549116/ProjectGearDeburr/documentatie/proof of concept/foto/WhatsApp Image 2025-10-16 at 11.18.52_3c14d5c5.jpg

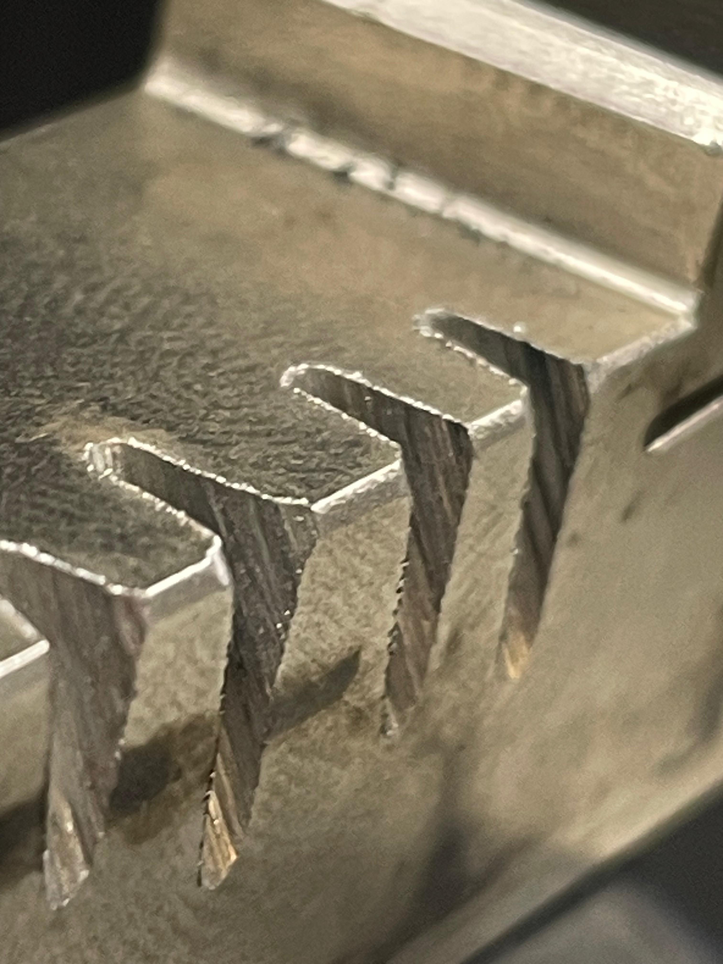
documentatie/proof of concept/foto/WhatsApp Image 2025-10-16 at 11.18.52_3c14d5c5.jpg
