549116/ProjectGearDeburr/presentaties/current status 21-11-2025.pptx

## Current status

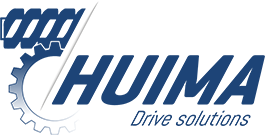
[picture p15: figure]
HUIMA SPECIALS – Drive solutions
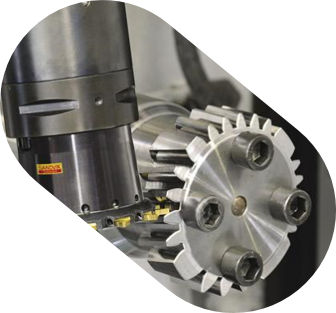
[picture p16: figure]
Gear Processing Process (7 Steps Make You Feel Simple) - Richconn

Project Gear Deburr

- - Gijs Winkelhorst
- - Sven Kerkhoff

## Slide 2

- Table of contents

- Current 3d model
  - Overview
  - How does it work?
  - Components
  - test
  - issues
- Future plans

## Slide 3

- 3d model overview

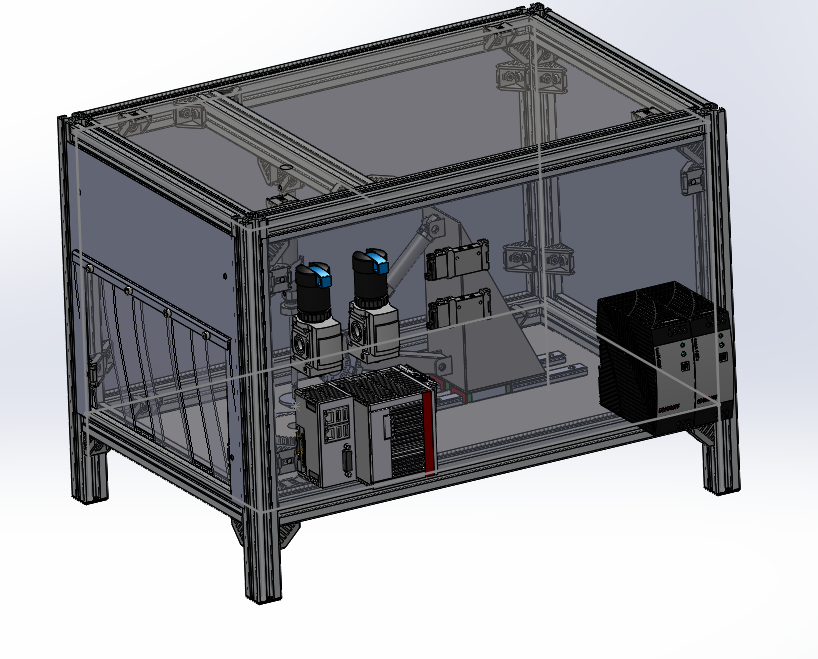
[picture p17: figure]

- Bosch rexroth frame 30x30 profile
- Deburring with a steel brush
- Prototype
- adjustable to the diameter and height of the gear wheel

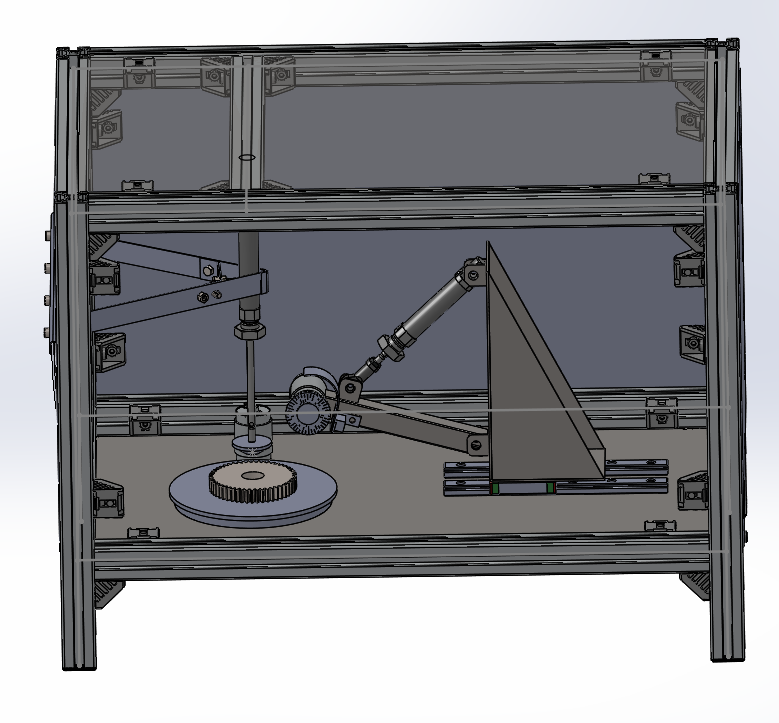
[picture p18: figure]
Afbeelding met schets Door AI gegenereerde inhoud is mogelijk onjuist.

## Slide 4

- How does it work?

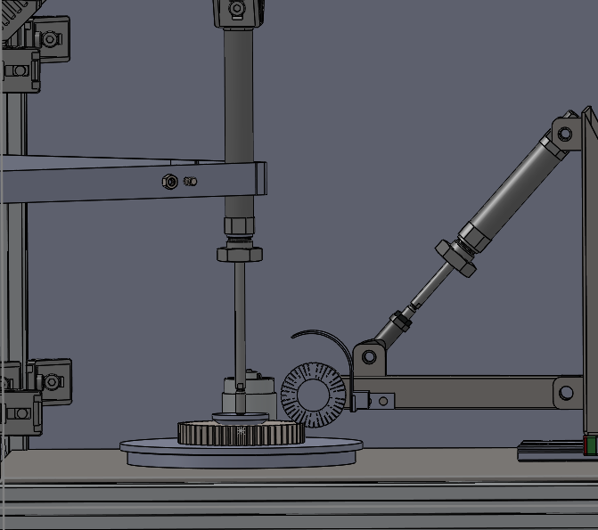
[picture p19: figure]
Afbeelding met schermopname, machine, microscoop Door AI gegenereerde inhoud is mogelijk onjuist.

Step 1:
Gear is placed on the turntable by hand or by a robot
Step 2:
Pneumatic cilinder with rotating center presses the gear onto the turntable
Step 3:
steel brush moves to the correct diameter position and is pressed against the gear wheel
Step 4:
Steel brush and turntable starts to rotate. -> gear is getting deburred
Step 5:
Everything returns to its starting position
Step 6:
Gear can be taken out

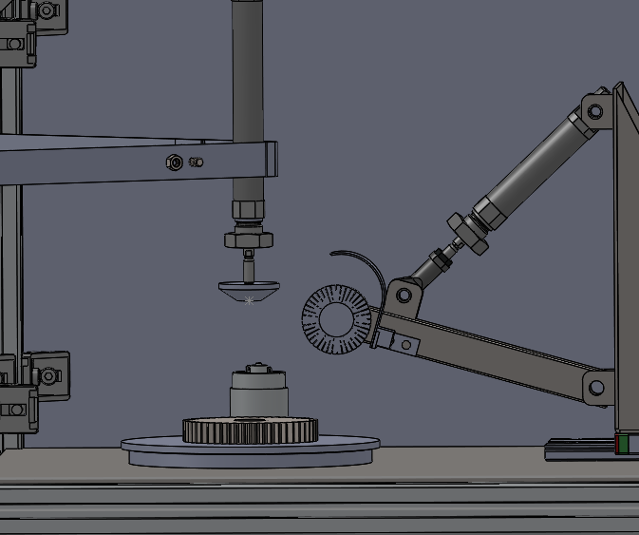
[picture p20: figure]
Afbeelding met schermopname, 3d-modellering, microscoop Door AI gegenereerde inhoud is mogelijk onjuist.

## Slide 5

- testing

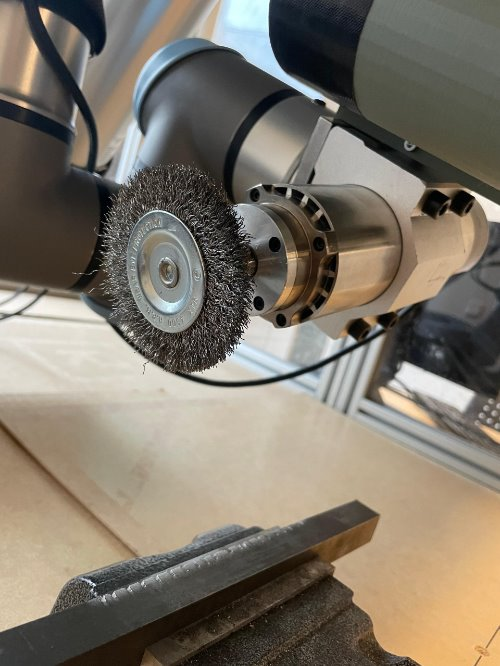
[picture p21: figure]
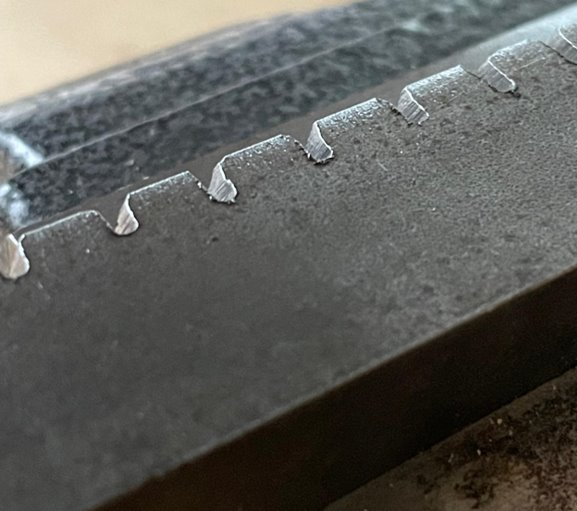
[picture p22: figure]

- Testing with robot and steel brush
- burrs have been removed

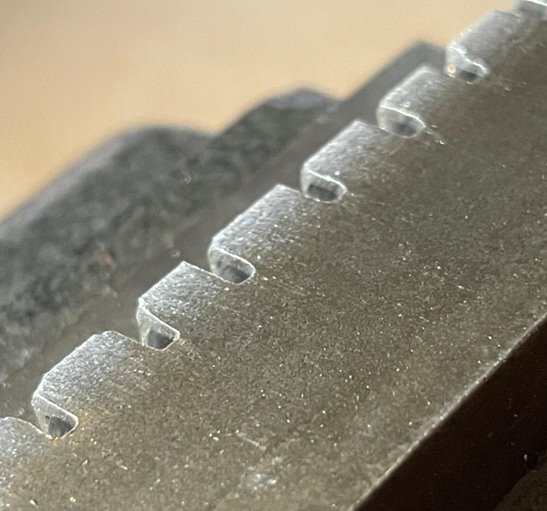
[picture p23: figure]

## Slide 6

- Components

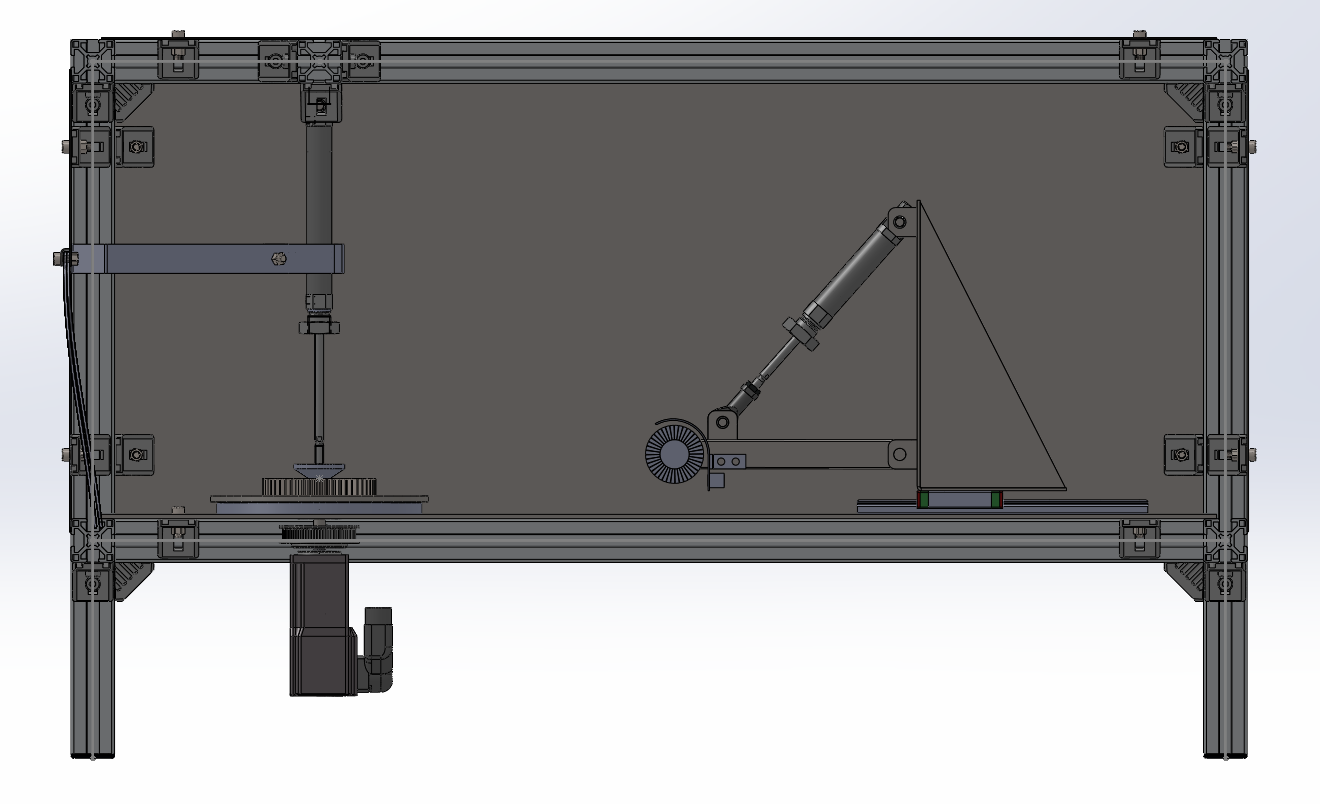
[picture p24: figure]
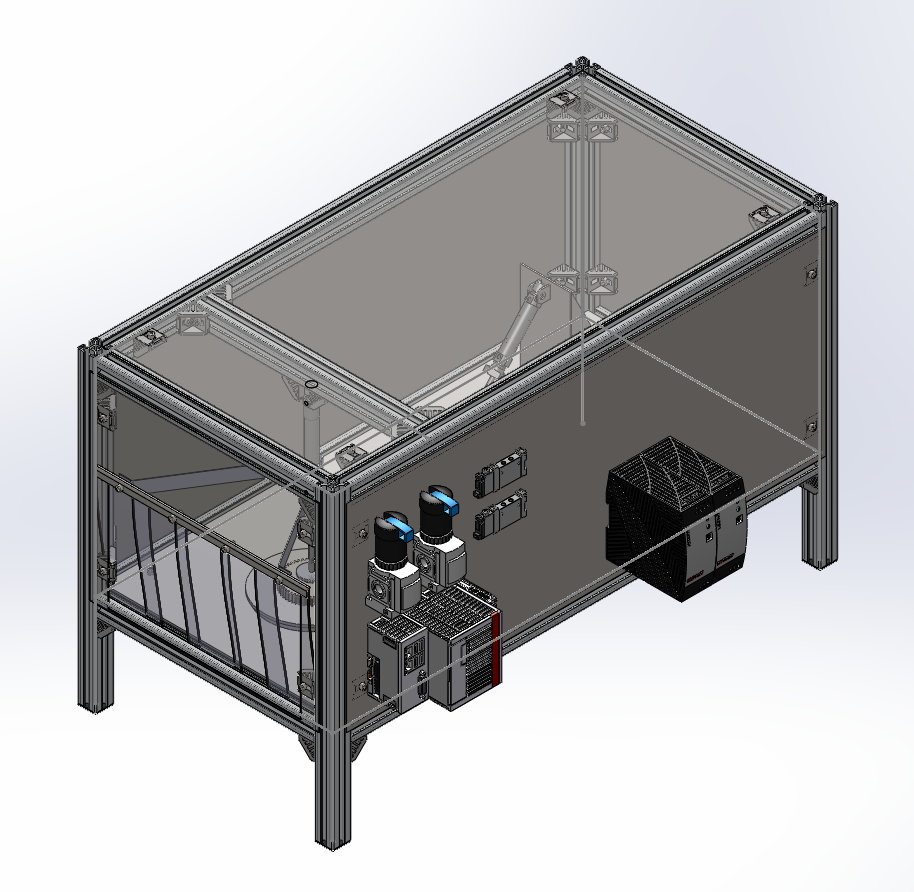
[picture p25: figure]
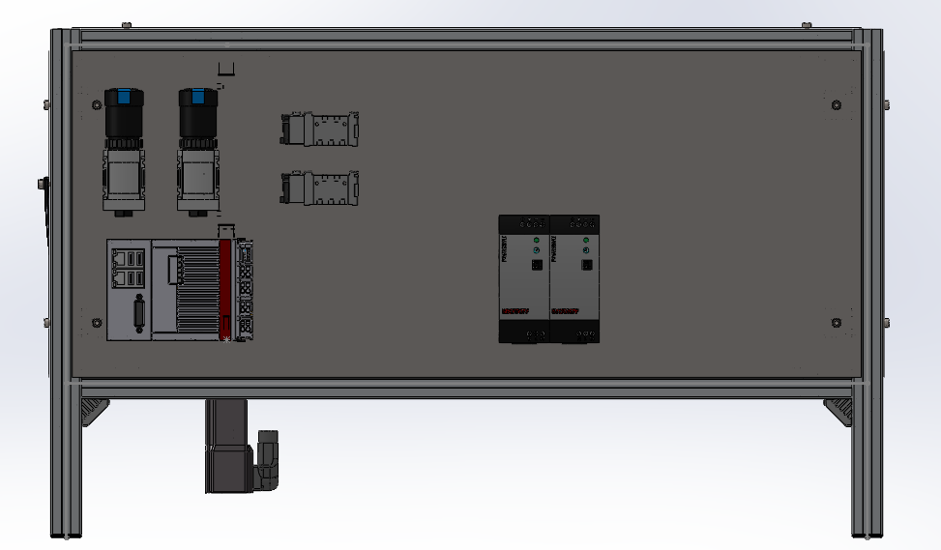
[picture p26: figure]

## Slide 7

- issues

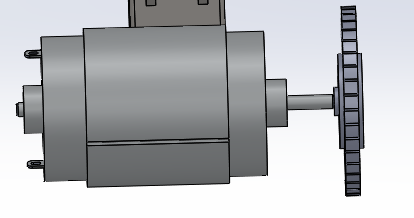
[picture p27: figure]

- bending force on motor axis.
- Bending force supporting gear
- Moment of inertia of turntable on motor
- Safety features
- Dust in machine

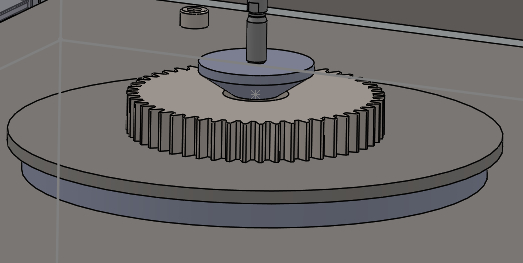
[picture p28: figure]

## Slide 8

- Future plans

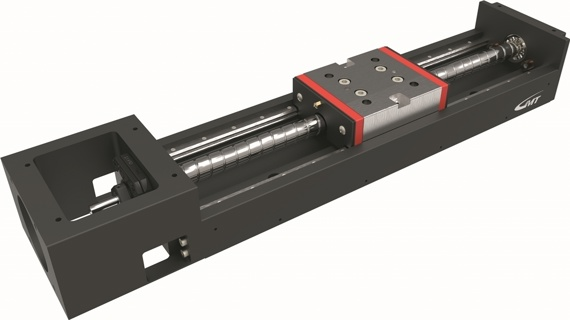
[picture p29: figure]
Linear actuator GKA4270-600-12N-P5 - GMT Europe GmbH
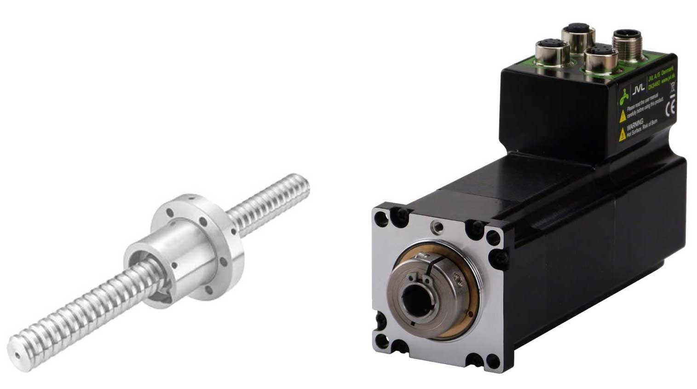
[picture p30: figure]

- Finalize 3d model and components
- Wiring
- Building the prototype
- Programming
- testing

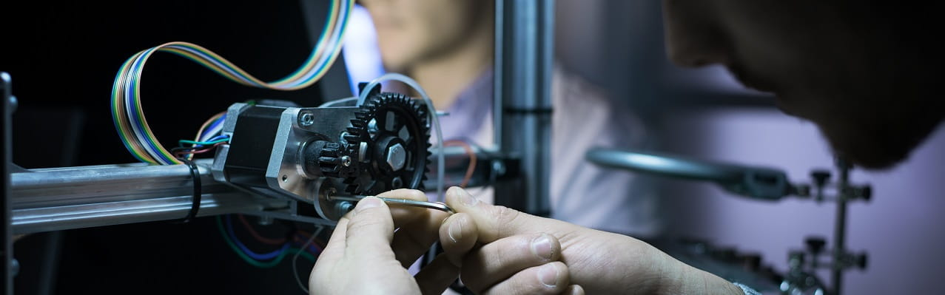
[picture p31: figure]
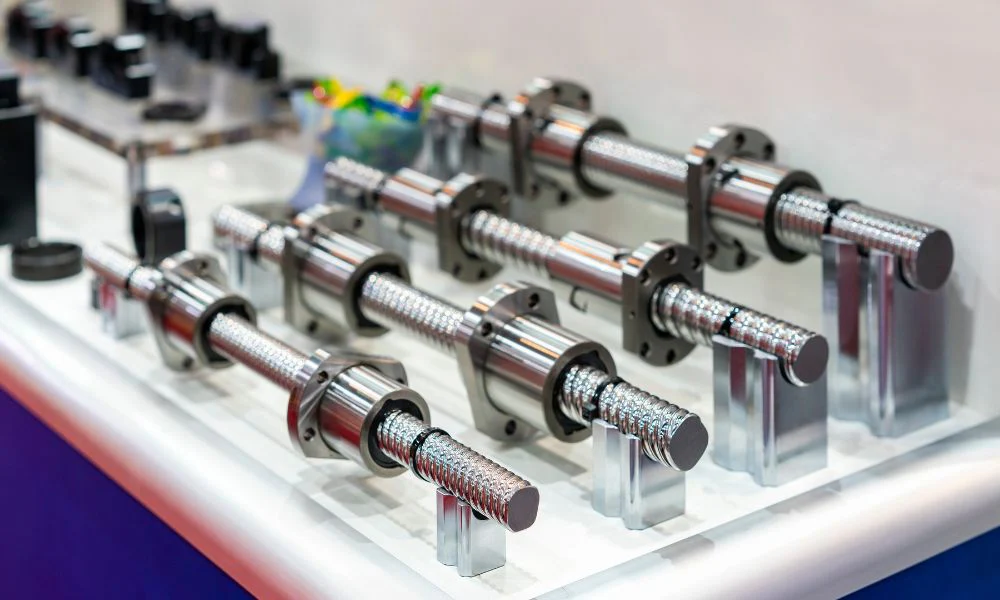
[picture p32: figure]
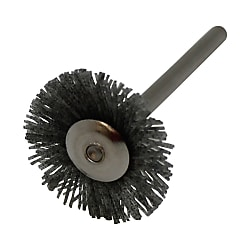
[picture p33: figure]
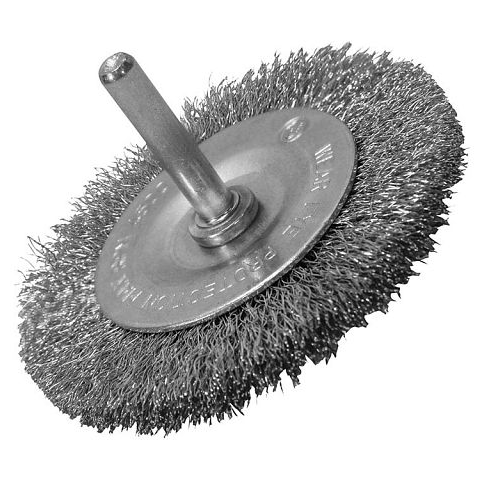
[picture p34: figure]
Wire Brush 75mm x 6mm Shank | FaithfullTools.com
