549116/ProjectGearDeburr/berekeningen/berekening uiterste massawaarden tandwielen.docx

# Berekening uiterste massawaarden tandwielen

# Lichtste

Algemene gegevens:

∅_(buiten) = 77.6 mm = 0.0776 m

∅_(binnen) = 50.0 mm = 0.0500 m

Modul = onbekend. Aanname: massieve schijf van buitendiameter.

## C45

Overige materiaalgegevens:

- Dichtheid = 7850 kg/m³ (bron: Xometry.pro)

π/4*(0.0776^2 -0.0500^2 )*dikte tandwiel*7850=kg=g

## 42CrMo4

Overige materiaalgegevens:

Dichtheid = 7850 kg/m³

π/4*(0.0776^2 -0.0500^2 )*dikte tandwiel*7850=kg=g

Dus het lichtste tandwiel is … gram.

# Zwaarste

∅_(buiten) = 132 mm = 0.132 m

∅_(binnen) = 17.0 mm = 0.0170 m
