549116/ProjectGearDeburr/presentaties/presentatie groep 5 week 1.6.pptx

## Status quo gear deburring

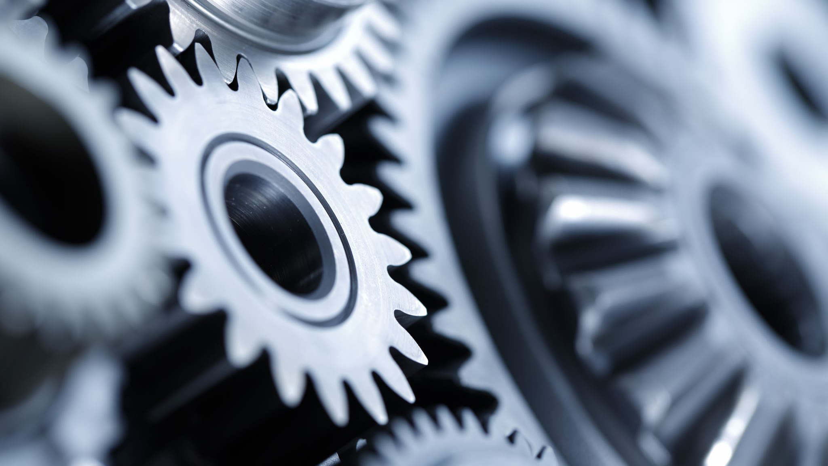
[picture p35: figure]
Machine gears

Groep 5:
Cedric Arentz (532214)
Gijs Winkelhorst (554028)
Sven Kerkhof (549116)
3-10-2025

## Introduction to project

- Mr. Spikker
- Huima BV
- Deburring of gears
- Proof of concept

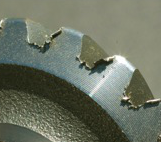
[picture p36: figure]
Deburring and Gear Deburring – Marples Gears
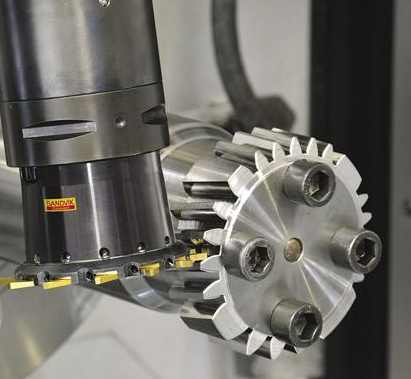
[picture p37: figure]
Gear Processing Process (7 Steps Make You Feel Simple) - Richconn

## Week 1

- Choosing of project
- Research about project
- First market research

## Week 2

- Meeting with client
  - weekly
- Company visit
  - Current solution: sandpaper wheel + plastic/steel brush
  - Manual labor
- Research
  - Market
  - project

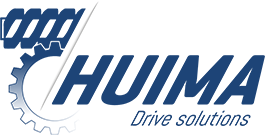
[picture p38: figure]
HUIMA SPECIALS – Drive solutions

## Week 3

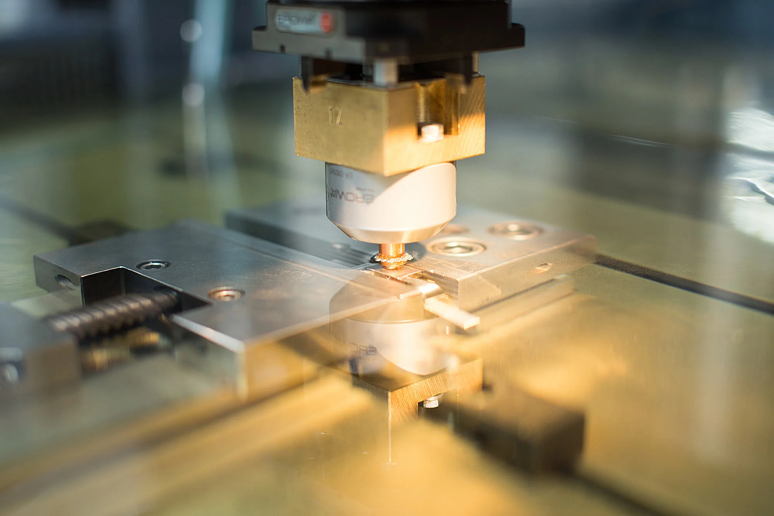
[picture p39: figure]

- Function scheme
- Morfologic scheme
  - EDM
  - brush
- first draft requirements document
  - Table version
  - Text version

## Week 4

- Combined requirements document
- Schedule
- Testing of concepts
  - EDM would be possible
  - brush is already proven
- Start of idef0 diagram

## Week 5

- EDM not an option -> brush
  - Bed
  - Gear tolerances
  - cost
- IDEF0 diagram
- Actual concept drawings
  - 2 or 3 axis version?

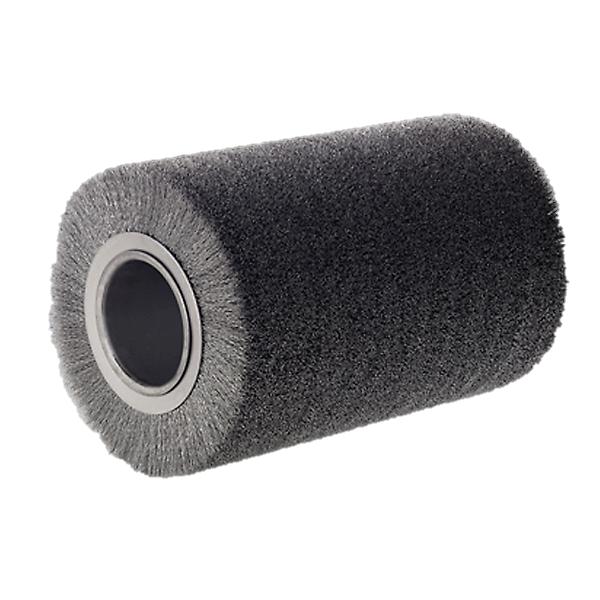
[picture p40: figure]
Industrial Brushes - RSA Cutting Systems

## Present (week 6)

- 'final' decision on concept to prove
  - Presented to company and client
- This presentation
- Calculations
  - Special parts to look into

## future

- Purchase part list
- Solidworks drawings
- Refinement Schedule for next quartile
  - Deadlines for different assemblies
- Building, testing, refinement (next quartile)

## Questions?

- Feel free to ask
