549116/ProjectGearDeburr/documentatie/oude pve's/PvE Verslag.docx

# 1 Inleiding

## 1.1 Projectcontext

Binnen de minor Industrial Automation werken studenten aan een praktijkgericht project waarbij een stap in een bestaand productieproces wordt geautomatiseerd. Dit project is gekozen voor het automatiseren van het afbramen van tandwielen die worden geproduceerd met behulp van een Afwikkelfreesmachine.

## 1.2 Bedrijf

# 2 Huidige situatie

In de huidige situatie vindt het afbramen volledig handmatig plaats. Operators gebruiken hierbij een koolstofborstel om bramen uit de groeven te verwijderen en een schuurband om de bovenzijdes van de tandwielen te bewerken. Dit is tijdsintensief, fysiek belastend en gevoelig voor inconsistentie en overbewerking.

## 2.1 Probleem

# 3 Gewenste situatie

## 3.1 Bedrijfswens

## 3.2 Projectscope

Het doel van dit project is het ontwikkelen van een proof of concept voor een geautomatiseerd systeem dat tandwielen op een reproduceerbare, veilige en efficiënte manier kan afbramen. Hoewel detectie, handling en afvoer secundair zijn, vormen ze wel noodzakelijke stappen om het proces als geheel werkbaar te maken.

# 4 Ontwerpuitgangspunten

Onder ontwerpuitgangspunten verstaan wij de basis waarop het systeem ontworpen moet worden

## 4.1 Specificaties

### 4.1.1 Materialen

De tandwielen worden van 42CrMo4 en C45 gemaakt. Dit zijn beide harde constructiestalen waardoor bewerkingen op dit metaal (hier iets waarom het moeilijk is om te bewerken)

### 4.1.2 Afmetingen

De Tandwielen hebben een buitendiameter van 75-140mm en een binnendiameter (gat) van 17-50mm. Voor de wormwielen gelden maten die zowel kleiner als het minimum en groter als het maximum van de tandwielen zijn.

## 4.2 Proces

### 4.2.1 Aanvoer

De tandwielen worden vanuit de afwikkelfreesmachine op een drager aangeleverd op een lopende band. Hierbij is belangrijk om te benoemen dat de bramen aan de onderkant van de tandwielen uitsteken. Deze band bevindt zich op een hoogte van +-1,5m. Sinds deze aanvoer niet makkelijk aan te sluiten is op een vervolg proces, zou er een toepassing gemaakt moeten worden die de tandwielen van deze lopende band kan detecteren en afhalen om de tandwielen verder te bewerken.

### 4.2.2 Afvoer

Omdat het ontbramen de laatste stap is in het bewerkingsproces kunnen de tandwielen na het proces verzameld worden of in een buffer worden bewaard waarna de tandwielen voor transport of opslag kunnen worden afgehandeld.

1 Scope en prioriteiten

De scope van het project is gedefinieerd aan de hand van prioriteiten:

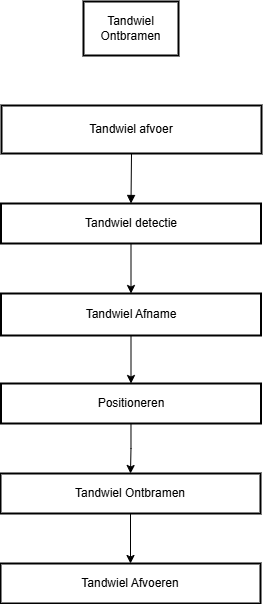
[picture p58: figure]

Hoofdoel:
Afbramen van normale tandwielen

Het systeem moet in staat zijn de bramen die ontstaan tijdens het slijpen effectief en consistent te verwijderen.

Voor de gehele automatie zijn deze stappen ook wenselijk. Afhankelijk van de vooruitgang kunnen deze eisen worden meegenomen

1. Afbramen van wormwielen – Afhankelijk van de oplossing die wordt gekozen, kan dit met de nodige aanpassingen worden meegenomen
2. Detecteren, correct oppakken en positioneren van tandwielen – noodzakelijk om het afbramen automatisch te laten verlopen.
3. Afvoeren en/of opslaan van tandwielen – gewenst om het proces te sluiten, maar ondergeschikt aan de afbraamfunctie.

Hoewel de focus ligt bij het aanleveren van een proof of concept voor het afbramen van tandwielen moet het wel zodanig ontworpen worden dat het passend is op deze functionaliteiten.

Specificaties en Eisen

Materialen

De tandwielen worden van 42CrMo4 en C45 gemaakt. Dit zijn beide harde constructiestalen waardoor bewerkingen op dit metaal (hier iets waarom het moeilijk is om te bewerken)

Afmetingen

De Tandwielen hebben een buitendiameter van 75-140mm en een binnendiameter (gat) van 17-50mm. Voor de wormwielen gelden maten die zowel kleiner als het minimum en groter als het maximum van de tandwielen zijn.

Aanvoer:
De tandwielen worden vanuit de afwikkelfreesmachine op een drager aangeleverd op een lopende band. Hierbij is belangrijk om te benoemen dat de bramen aan de onderkant van de tandwielen uitsteken. Deze band bevindt zich op een hoogte van +-1,5m. Sinds deze aanvoer niet makkelijk aan te sluiten is op een vervolg proces, zou er een toepassing gemaakt moeten worden die de tandwielen van deze lopende band kan detecteren en afhalen om de tandwielen verder te bewerken.

Afvoer

Omdat het ontbramen de laatste stap is in het bewerkingsproces kunnen de tandwielen na het proces verzameld worden of in een buffer worden bewaard waarna de tandwielen voor transport of opslag kunnen worden afgehandeld.

# 5 Functionele eisen

- Het systeem moet tandwielen kunnen afbramen binnen de cyclustijd van het slijpproces.
- Het systeem moet tandwielen herkennen en correct positioneren voor bewerking.
- Het systeem moet compatibel zijn met de genoemde diameters en materialen.
- Het afbraamproces moet reproduceerbaar en betrouwbaar zijn.
- Het systeem moet ontworpen zijn voor proof of concept: uitbreidbaar en geschikt als basis voor verdere ontwikkeling.

# 6 Niet-functionele eisen

- Veiligheid: naleving van ARBO- en werkplaatsvoorschriften.
- Betrouwbaarheid: minimaal storingsvrij functioneren tijdens demonstraties.
- Onderhoudsgemak: componenten moeten eenvoudig vervangbaar en reinigbaar zijn.
- Gebruiksvriendelijkheid: de bediening moet intuïtief zijn en geen hoge operatorvaardigheden vereisen.

# 7 Randvoorwaarden

- Budget: €10.000–15.000.
- Tijd: één semester (± 20 weken).
- Wettelijk kader: ARBO en overige werkplaatsveiligheid.
- Ruimte: integratie in bestaande productieruimte (ruimte van 2-3m²)

# 8 Op te leveren resultaten

- Een proof of concept van een (deels geautomatiseerd) afbraamsysteem dat normale tandwielen kan afwerken binnen de gestelde cyclustijd.
- Een werkende demo waarin detectie, positionering en afbramen zichtbaar worden gedemonstreerd.
- Documentatie met:
  - Beschrijving van ontwerp en werking.
  - Onderbouwing van gemaakte ontwerpkeuzes.
  - Overzicht van beperkingen en openstaande punten.
  - Suggesties voor vervolgstappen.
- Een evaluatie van de haalbaarheid binnen de gestelde randvoorwaarden (kosten, veiligheid, ruimte).
- Een presentatie voor de opdrachtgever en het bedrijf met de resultaten en vervolgmogelijkheden.

# 9 Wensen / nice-to-have

- Automatische afvoer van tandwielen naar een opslagpunt.
- Flexibiliteit om later wormwielen volledig te integreren.
- Gebruik van standaardcomponenten om kosten te beperken en vervangbaarheid te vergroten.

# 10 Open punten / te onderzoeken onderwerpen

- Welke detectietechnieken het meest geschikt zijn (bijv. vision, sensoren).
- Welke afbraammethoden technisch en economisch haalbaar zijn.
- Hoe om te gaan met vervuiling door vet en slijpsel.
- Hoe het proces later opgeschaald kan worden naar volledige integratie in de productielijn.

Eisen verzameld in overzicht op een meetbare specifiek geformuleerde manier. Dit moet allemaal terug te vinden zijn:

Soort eis: vast, variabel of wens | Gebruikers eis of fabricage eis | eis
vast | gebruiker | Machine moet automatisch werken
vast | gebruiker | De machine moet kunnen werken met een tandwiel-buitendiameter van 75 t/m 140 mm
| | De machine moet kunnen werken met een tandwiel-binnendiameter van 17 t/m 50 mm
vast | gebruiker | De machine moet met tandwielen kunnen werken met een dikte van (...) t/m (...) mm
vast | gebruiker | Machine moet tandwielen kunnen ontbramen die gemaakt zijn van de volgende soort materialen: aluminium, brons, gietijzer, brons, chroom 42.
vast | fabricage | Alle tandwielen voldoen aan de standaard iso maatvoering en mogen een minimale modulus waarde hebben van ……
vast | gebruiker | Maximale radius rand tandwiel na bewerking is …. mm
vast | gebruiker | Cyclustijd moet binnen de 15 minuten zitten
vast | gebruiker | Maximaal budget is 15.000 euro
vast | fabricage | Machine voldoet aan CE-norm
vast | fabricage | Machine moet deels bestendig zijn tegen spanen en olie
vast | gebruiker | Machine moet functioneel zijn tussen de -20 en 60 graden celcius
Variabel | gebruiker | Machine mag niet meer dan 3 m² vloeroppervlak in beslag nemen
wens | gebruiker | Machine moet aansluiten op de tandwielproductie machine
