549116/ProjectGearDeburr/documentatie/contact/Antwoorden Bedrijfsbezoek.docx

## Informatie

Het doel van het project is om een Proof of Concept op te leveren die op een effectieve manier het afbraamproces bij tandwielen automatiseert. Deze proof of concept is in afstemming met de eisen die het bedrijf hierbij stelt. Hierbij wordt er niet gekeken naar de aanvoer en afvoer van de tandwielen in het productieproces.

Batches met dezelfde tandwielen in de tientallen

Conisch gevormde Jigs voor transport van Tandwielen

Materialen die gebruikt worden voor de tandwielen (Zachtst naar hardst):

- Brons (zachtst)
- Messing
- AluminiumBrons
- Enzovoort.
- C-45 (hardst)

## Werkwijze

Concepten uitwerken en met afstemming van Joris presenteren aan bedrijf.

Tussentijds concepten uittesten. Niet te veel op eentje vestigen in beginfase

Nadenken over wat voor gereedschap we gaan gebruiken

Componenten beschikbaar op school.

Elke donderdag 14:45 bespreekmoment Joris Spikker
