549116/ProjectGearDeburr/documentatie/contact/Vragenlijst bezoek tandwiel deburren.docx

# Vragenlijst bezoek tandwiel deburren

- Mogen de tandwielen op de loopband blijven

mogen er spanen/troep op de loopband komen

# Financieel

- Hoeveel mag de machine kosten in gebruik
- Hoeveel mag het project/aanschaf kosten
- 15000 euro

# Praktisch

- Moeten beide kanten of alleen de braamkant worden bewerkt
  - Waar zit de braamkant bij helische tandwielen
- Hoe groot mag de machine zijn
- hoeveel diepte mag er van het tandwiel af
- komen de tandwielen perfect uit elkaar met bepaalde afstand aan?
  - Hoever/ hoelang zit ertussen
  - Mogen ze weer op deze rolband worden gegooid/gelegd na nabewerken
  - Zitten nog eisen aan hierbovengenoemd
- Hoe vet zijn de tandwielen
- Is er al een naaf
  - Is hier een systeem/constante binnendiameter voor? nee
- Hoe groot zijn de tandwielen
  - Minimale/maximale diameter
  - Minimale/maximale dikte
  - Minimale/maximale gewicht
- Van welk materiaal / welke hardheid is er te verwachten
- Levensduur en onderhoud
  - Hoeveel uur tussen onderhoud
  - Hoeveel uur moet de machine in totaal meegaan

Kunnen de maten van de tandwielen tijdens het proces uitgelezen worden?

Worden de tandwielen in batches gemaakt?

# Snelheid

- Hoeveel tandwielen per tijdseenheid moet de machine aankunnen?

# Veiligheid

- Moet de machine afgeschermd zijn?
- Alleen arbo of nog veiliger als dat?
