549116/ProjectGearDeburr/documentatie/PvE/Plan van Eisen - Afbraam Automatisering.docx

# Plan van Eisen

Automatisering afbraamproces tandwielen

# 1 Inleiding

Binnen de minor Industrial Automation wordt voor het bedrijf Huima Specials BV gewerkt aan de ontwikkeling van een proof of concept voor het automatiseren van het afbramen van tandwielen.

## 1.1 Huidige situatie

Het bedrijf maakt gebruik van een afwikkelfreesmachine die tandwielen produceert en onbewerkt afgeeft. Na dit proces blijven er bramen en vetresten achter. Momenteel wordt het afwerken van deze tandwielen handmatig uitgevoerd door een werknemer: het tandwiel wordt met een doek schoongemaakt, met een schuurband worden de vlakke kanten afgewerkt en met een koolstofborstel worden de groeven langsgegaan. Dit is arbeidsintensief, fysiek belastend en leidt tot variaties in kwaliteit.

## 1.2 Gewenste situatie

Het bedrijf streeft naar een volledig geautomatiseerd proces waarin de tandwielen na de afwikkelfrees automatisch worden opgepakt, gecentreerd, ontbraamd, eventueel gereinigd en vervolgens afgevoerd naar een verzamelpunt.

## 1.3 Projectdoel

Voor het project ontwikkelen wij een proof of concept dat zich primair richt op het automatisch afbramen van de tandwielen. De overige stappen in het proces – detectie, oppakken, positioneren en afvoer – worden wel meegenomen in de oplossingsrichting en opstelling, maar krijgen een secundaire rol. Afhankelijk van de voortgang kan een deel hiervan verder worden gerealiseerd.

# 2 Ontwerpuitgangspunten

Ontwerpuitgangspunten vormen de randvoorwaarden en uitgangssituatie waarbinnen het systeem moet worden ontwikkeld. Dit zijn feiten die al door het bedrijf zijn vastgesteld en waar het project geen invloed op heeft.

## 2.1 Productgegevens

Eigenschap | Specificatie
Materialen | 42CrMo4, C45
Buitendiameter tandwielen | 75–140 mm
Binnendiameter tandwielen | 17–50 mm
Dikte tandwielen | Nog te specificeren
Toestand bij aanvoer | Spaanders in snijolie op de tandwielen, met bramen aan de onderzijde

## 2.2 Aanvoer en afvoer

### 2.2.1 Aanvoer

Na de afwikkelfreesmachine worden de tandwielen geplaatst in houders die via een transportband, vanwaar ze door een medewerker verder verwerkt worden. Bij aanvoer zijn de tandwielen vettig en bevinden de bramen zich met name aan de onderzijde.

### 2.2.2 Afvoer

Na het afbramen worden de tandwielen (nu nog handmatig) verzameld op pallets en in een doos geplaatst voor opslag of transport.

## 2.3 Randvoorwaarden

- Budget: €10.000–15.000.
- Semesterduur: ± 20 weken.
- Machine moet voldoen aan CE-normering en ARBO-veiligheid.

# 3 Procesoverzicht

Zoals te zien in de figuur bestaal het proces uit een aantal stappen:

1. inneemen van een tandwiel na de afwikkelfrees.
2. correct positioneren van het tandwiel.
3. Centreren en fixeren van het tandwiel voor bewerking.
4. Het tandwiel roteren, zodat elke braam langs de tool komt
5. De tool gebruiken
6. De tool wegnemen
7. Afgifte van het tandwiel

# 4 Eisen (MoSCoW)

Onderstaande tabel geeft een overzicht van de eisen, ingedeeld volgens de MoSCoW-methode en voorzien van de herkomst van de eis (gebruiker of fabricage).

NR | Eis | MoSCoW | Herkomst
1 | Machine moet automatisch functioneren zonder constante handmatige interventie | Must | Gebruiker
2 | Machine moet tandwielen met buitendiameter 75–140 mm verwerken | Must | Gebruiker
3 | Machine moet tandwielen met binnendiameter 17–50 mm verwerken | Must | Gebruiker
4 | Machine moet geschikt zijn voor materialen 42CrMo4 en C45 | Must | Gebruiker
5 | Cyclustijd mag de cyclustijd van de afwikkelfrees niet overschrijden | Must | Gebruiker
6 | Machine moet een CE markering hebben | Must | Fabricage
7 | De machine moet voldoen aan de arbowet | must | Fabricage
8 | Machine moet bestand zijn tegen spanen en olie | Must | Fabricage
9 | Machine mag maximaal 3 m² vloeroppervlak innemen | Must | Gebruiker
10 | Machine moet tandwielen detecteren en correct oppakken van houders op 1,5 m hoogte | Must | Gebruiker
11 | Machine moet tandwielen effectief ontbramen (radius na bewerking nader te bepalen) | Must | Gebruiker
12 | Dagelijks onderhoud mag maximaal 10 minuten duren | Should | Gebruiker
13 | Wekelijks onderhoud mag maximaal 30 minuten duren | should | gebruiker
14 | Resultaten moeten reproduceerbaar zijn, met op het zicht consistente afwerking | Should | Gebruiker
15 | Machine moet functioneren bij 5°C tot +35 °C | Should | Fabricage
16 | Machine tandwieldikten tussen (bereik) kunnen bewerken | must | Gebruiker
17 | Machine kan aansluiten op tandwielproductiemachine | Could | Gebruiker
18 | Machine kan tandwielen uit het uitvoermagazijn van de afwikkelfrees pakken | Could | Gebruiker
19 | Volledige integratie met afvoersysteem | could | gebruiker
20 | Uitbreidbaarheid voor wormwielen | Could | Gebruiker
21 | Gebruik van standaardcomponenten voor kosten en onderhoud | Could | Fabricage
22 | Geautomatiseerde kwaliteitscontrole (visuele inspectie) | Won’t | Gebruiker

# 5 Op te leveren resultaten

- Een proof of concept van een (deels geautomatiseerd) afbraamsysteem dat normale tandwielen kan verwerken binnen de gestelde cyclustijd.
- Een werkende demo waarin het automatisch afbramen van tandwielen wordt getoond. Positionering kan handmatig plaatsvinden, tenzij de projectvoortgang meer toelaat.
- Documentatie met:
  - Beschrijving van ontwerp en werking.
  - Onderbouwing van ontwerpkeuzes (detectie, klemmen, afbraamtechniek).
  - Overzicht van beperkingen en suggesties voor vervolgstappen.
- Evaluatie van de haalbaarheid binnen budget, veiligheid en beschikbare ruimte.
- Een presentatie van de resultaten en vervolgmogelijkheden aan het bedrijf.
- Twee posterpresentaties voor het lectoraat, eentje halverwege en eentje aan het einde van het project.
6 Plan van Eisen – Automatisering afbraamproces tandwielen
7 1. Inleiding

Binnen de minor Industrial Automation wordt in samenwerking met [naam bedrijf/afdeling] gewerkt aan de ontwikkeling van een proof of concept voor het automatiseren van het afbramen van tandwielen.

8 Huidige situatie

Het bedrijf maakt gebruik van een afwikkelfreesmachine die tandwielen produceert en onbewerkt afgeeft. Na dit proces blijven er bramen en vetresten achter. Momenteel wordt dit handmatig uitgevoerd door een werknemer: het tandwiel wordt met een doek schoongemaakt, met een koolstofborstel worden de groeven langsgegaan en met een schuurband worden de vlakke kanten afgewerkt. Dit is arbeidsintensief, fysiek belastend en leidt tot variaties in kwaliteit.

9 2. Gewenste situatie
10 Bedrijfswens

Het bedrijf streeft naar een volledig geautomatiseerd proces waarin de tandwielen na de afwikkelfrees automatisch worden opgepakt, gecentreerd, ontbraamd, eventueel gereinigd en vervolgens afgevoerd naar een verzamelpunt.

11 Projectdoel

Binnen het project ontwikkelen wij een proof of concept dat zich primair richt op het automatisch afbramen van de tandwielen. De overige stappen in het proces – detectie, oppakken, positioneren en afvoer – worden meegenomen in de oplossingsrichting en opstelling, maar hebben een secundaire rol. Afhankelijk van de voortgang kan een deel hiervan verder worden gerealiseerd.

12 3. Ontwerpuitgangspunten

Ontwerpuitgangspunten vormen de randvoorwaarden en uitgangssituatie waarbinnen het systeem moet worden ontwikkeld. Dit zijn feiten die al door het bedrijf zijn vastgesteld en waar het project geen invloed op heeft.

13 Productgegevens

Eigenschap | Specificatie
Materialen | 42CrMo4, C45
Buitendiameter tandwielen | 75–140 mm
Binnendiameter tandwielen | 17–50 mm
Dikte tandwielen | Nog te specificeren
Toestand bij aanvoer | Vettig, met bramen aan de onderzijde

14 Aanvoer en afvoer
- Aanvoer: na de afwikkelfreesmachine worden de tandwielen op een transportband geplaatst. Op circa 1,5 meter hoogte verplaatsen de tandwielen zich in houders (jigs) die door de band worden meegevoerd. Bij aanvoer zijn de tandwielen vettig en bevinden de bramen zich met name aan de onderzijde.
- Afvoer: na het afbramen worden de tandwielen (nu nog handmatig) verzameld op pallets en in een doos geplaatst voor verdere verwerking.
15 Randvoorwaarden
- Budget: €10.000–15.000.
- Semesterduur: ± 20 weken.
- Machine moet voldoen aan CE-normering en ARBO-veiligheid.
16 4. Procesoverzicht

De automatisering omvat de volgende processtappen:

1. Detecteren van een tandwiel na de afwikkelfrees.
2. Oppakken en correct positioneren van het tandwiel.
3. Centreren en fixeren van het tandwiel voor bewerking.
4. Afbramen van tandwiel (tussen groeven en bovenrand).
5. Eventueel reinigen/verwijderen van slijpsel en vet.
6. Afvoeren naar pallet of doos voor verzameling.
17 5. Eisen

Onderstaande tabel geeft een overzicht van de eisen, ingedeeld volgens de MoSCoW-methode en voorzien van de herkomst van de eis (gebruiker of fabricage).

Nr. | Eis | MoSCoW | Herkomst
1 | Machine moet automatisch functioneren zonder constante handmatige interventie | Must | Gebruiker
2 | Machine moet tandwielen met buitendiameter 75–140 mm verwerken | Must | Gebruiker
3 | Machine moet tandwielen met binnendiameter 17–50 mm verwerken | Must | Gebruiker
4 | Machine moet geschikt zijn voor materialen 42CrMo4 en C45 | Must | Gebruiker
5 | Cyclustijd mag de cyclustijd van de afwikkelfrees niet overschrijden | Must | Gebruiker
6 | Machine moet voldoen aan CE-norm en ARBO-veiligheid | Must | Fabricage
7 | Machine moet bestand zijn tegen spanen en olie | Must | Fabricage
8 | Machine mag maximaal 3 m² vloeroppervlak innemen | Must | Gebruiker
9 | Machine moet tandwielen detecteren en correct oppakken van houders op 1,5 m hoogte | Must | Gebruiker
10 | Machine moet tandwielen centreren en fixeren voor bewerking | Must | Gebruiker
11 | Machine moet tandwielen effectief ontbramen (radius na bewerking nader te bepalen) | Must | Gebruiker
12 | Machine moet onderhoudsvriendelijk zijn (borstels/onderdelen vervangbaar) | Should | Gebruiker
13 | Resultaten moeten reproduceerbaar zijn, met consistente afwerking | Should | Gebruiker
14 | Machine moet functioneren bij -20 °C tot +60 °C | Should | Fabricage
15 | Machine moet geschikt zijn voor variatie in tandwieldikte | Should | Gebruiker
16 | Machine kan aansluiten op tandwielproductiemachine | Could | Gebruiker
17 | Volledige integratie met aanvoer- en afvoersysteem | Could | Gebruiker
18 | Uitbreidbaarheid voor wormwielen | Could | Gebruiker
19 | Gebruik van standaardcomponenten voor kosten en onderhoud | Could | Fabricage
20 | Geautomatiseerde kwaliteitscontrole (visuele inspectie) | Won’t | Gebruiker

18 6. Op te leveren resultaten
- Een proof of concept van een (deels geautomatiseerd) afbraamsysteem dat normale tandwielen kan verwerken binnen de gestelde cyclustijd.
- Een werkende demo waarin het automatisch afbramen van tandwielen wordt getoond. Positionering kan handmatig plaatsvinden, tenzij de projectvoortgang meer toelaat.
- Documentatie met:
  - Beschrijving van ontwerp en werking.
  - Onderbouwing van ontwerpkeuzes (detectie, klemmen, afbraamtechniek).
  - Overzicht van beperkingen en suggesties voor vervolgstappen.
- Evaluatie van de haalbaarheid binnen budget, veiligheid en beschikbare ruimte.
- Een presentatie van de resultaten en vervolgmogelijkheden aan het bedrijf.
