549116/ProjectGearDeburr/documentatie/concepttekeningen/schetsen afbramen/CamScanner 30-09-2025 13.43.pdf

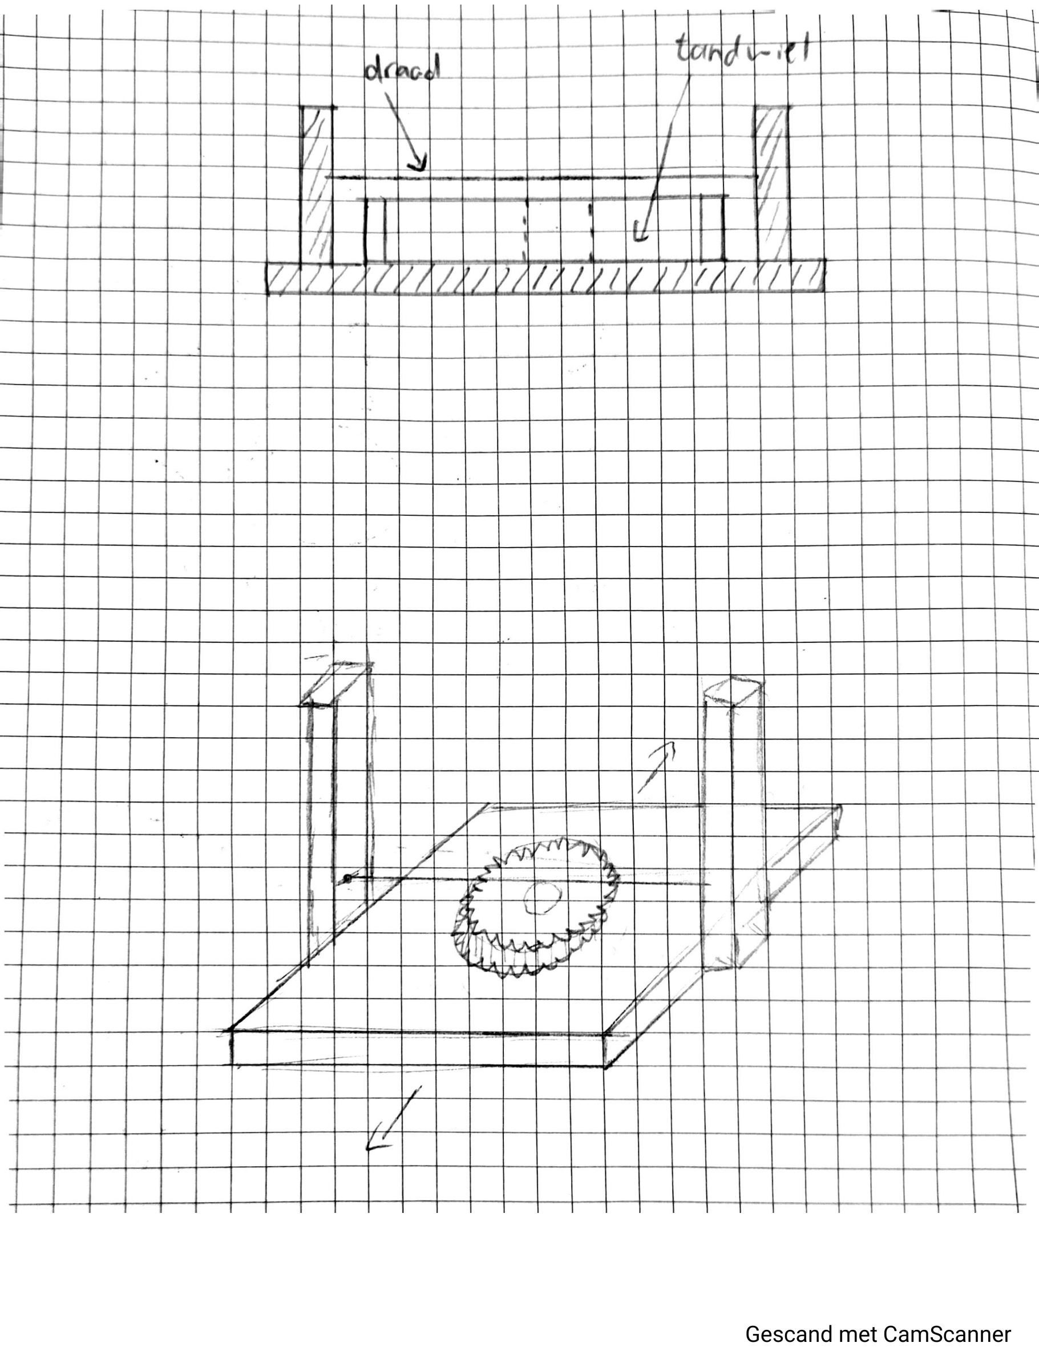
[picture p64: page 1]
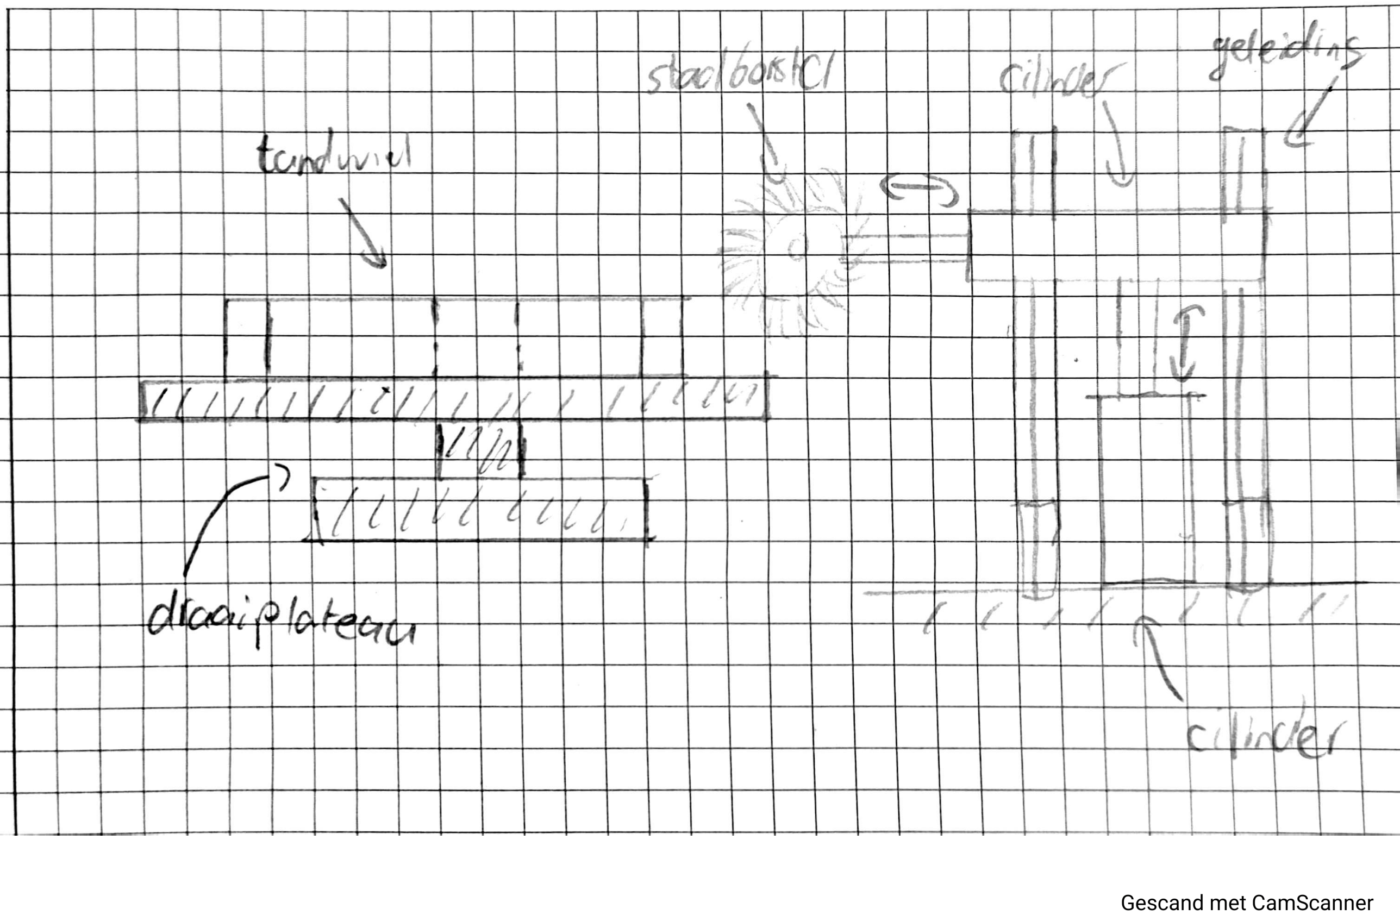
[picture p65: page 2]
