549116/ProjectGearDeburr/documentatie/concepttekeningen/schetsen afbramen/eerste concept gijs.pdf

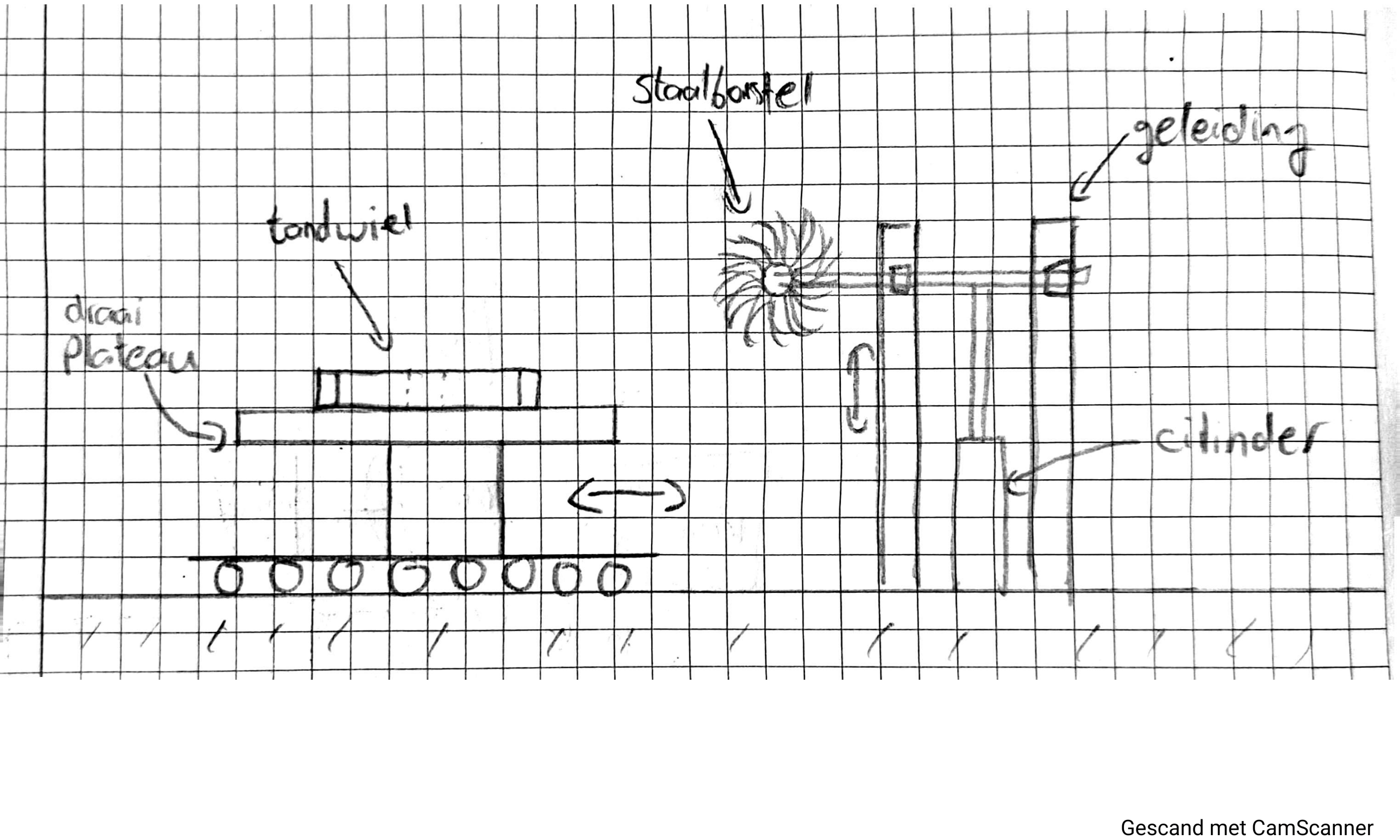
[picture p66: page 1]

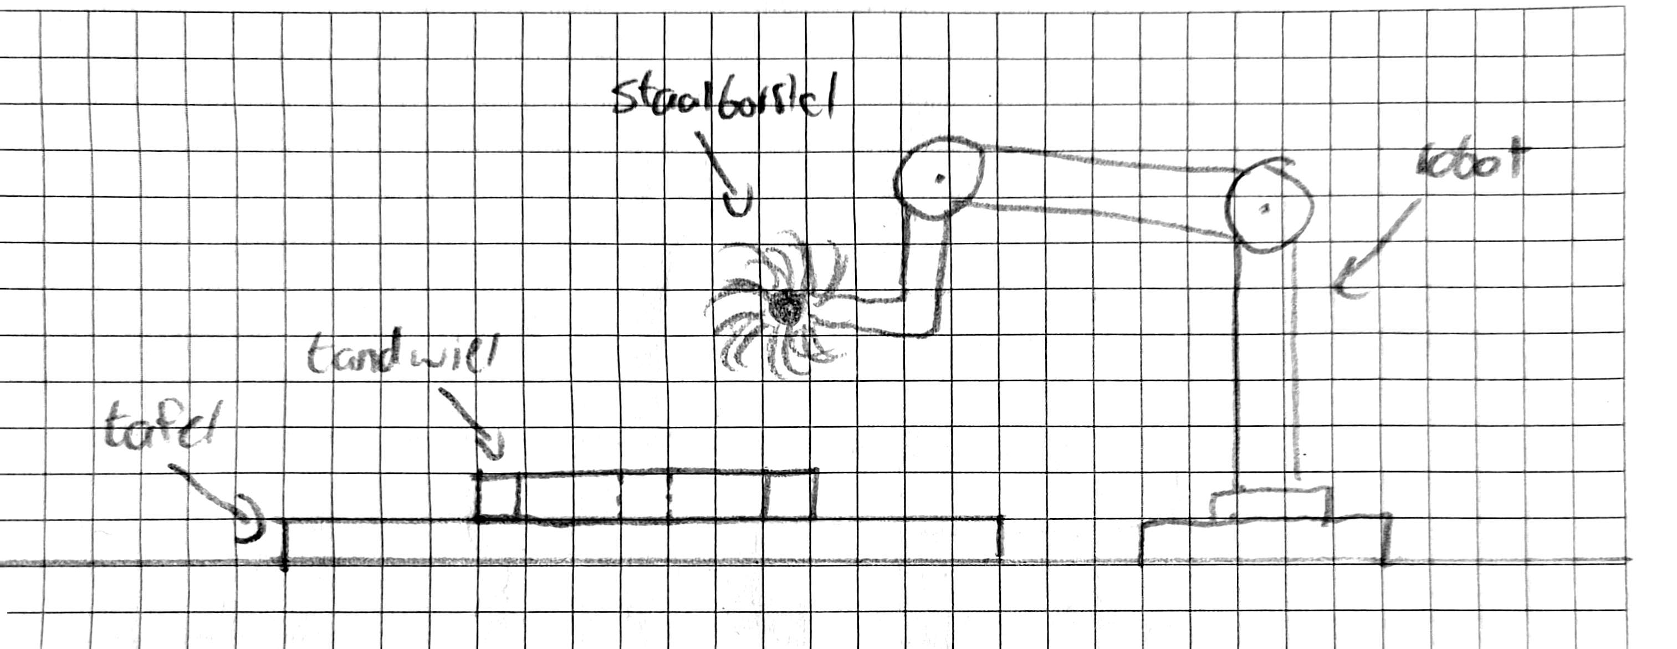
[picture p67: figure]
