549116/ProjectGearDeburr/documentatie/concepttekeningen/schetsen afbramen/eindconcept schets.pdf

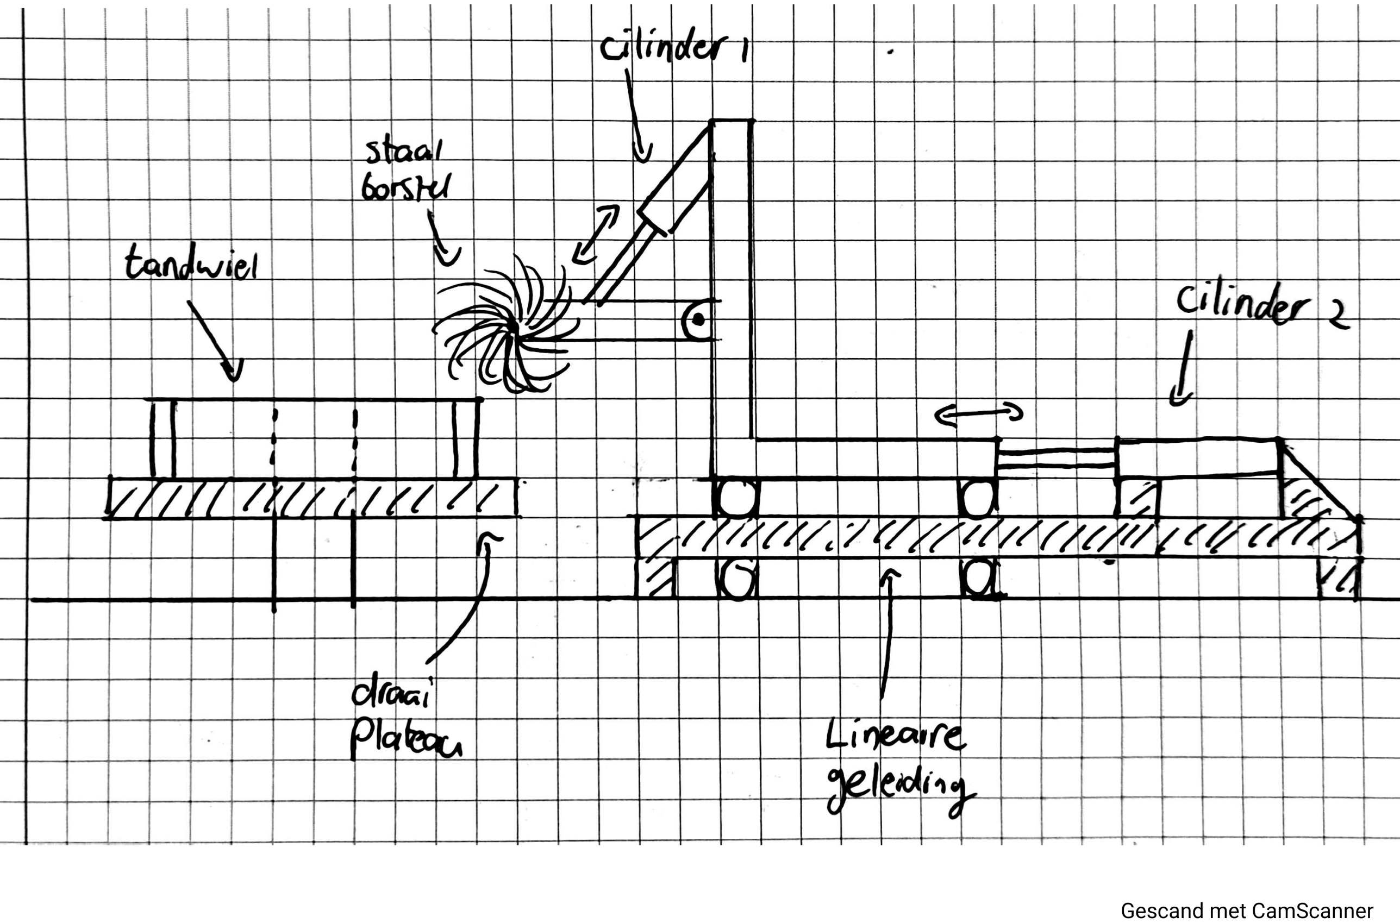
[picture p68: page 1]
