549116/ProjectGearDeburr/documentatie/diagrammen/functieschema tandwiel ontbramen.drawio.pdf

tandwiel ontbramen

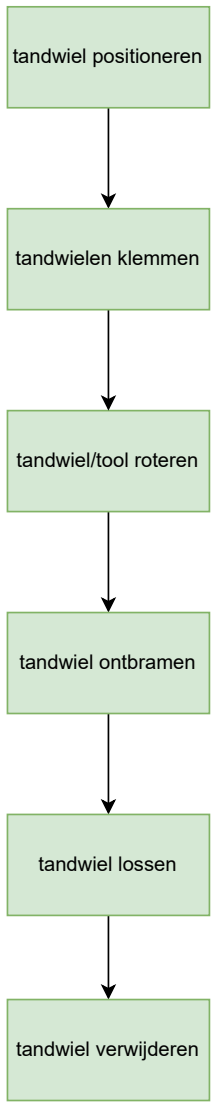
[picture p69: figure]
tandwiel/tool roteren; tandwiel positioneren; tandwielen klemmen; tandwiel ontbramen; tandwiel lossen; tandwiel verwijderen
