549116/ProjectGearDeburr/documentatie/conceptkeuze/kesselring deburring machine.xlsx

 |  | concept edm |  | concept staalborstel v1 |  | concept frees |  | concept staalborstel en schuurpapier |  | eindconcept
fabricage-eisen | weegfactor | punten | P*F | punten | P*F | punten | P*F | punten | P*F | punten | P*F
materiaal | 1 | 3 | 3 | 4 | 4 | 3 | 3 | 3 | 3 | 4 | 4
compacte constructie | 2 | 4 | 8 | 3 | 6 | 3 | 6 | 3 | 6 | 4 | 8
kosten inschatting | 4 | 1 | 4 | 4 | 16 | 4 | 16 | 4 | 16 | 3 | 12
montage | 3 | 3 | 9 | 3 | 9 | 3 | 9 | 3 | 9 | 3 | 9
eenvoudigheid | 3 | 2 | 6 | 4 | 12 | 3 | 9 | 3 | 9 | 5 | 15
totaal |  |  | 30 |  | 47 |  | 43 |  | 43 |  | 48
totaal (%) |  |  | 46.15384615% |  | 72.30769231% |  | 66.15384615% |  | 66.15384615% |  | 73.84615385%
 |  | concep edm |  | concept staalborstel v1 |  | concept frees |  | concept staalborstel en schuurpapier |  | eindconcept
gebruikers-eisen | weegfactor | punten | P*F | punten | P*F | punten | P*F | punten | P*F | punten | P*F
veiligheid | 4 | 3 | 12 | 3 | 12 | 3 | 12 | 4 | 16 | 4 | 16
onderhoud | 3 | 3 | 9 | 3 | 9 | 2 | 6 | 4 | 12 | 4 | 12
betrouwbaarheid | 4 | 3 | 12 | 4 | 16 | 1 | 4 | 5 | 20 | 5 | 20
cyclustijd | 3 | 2 | 6 | 3 | 9 | 2 | 6 | 3 | 9 | 3 | 9
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
