549116/ProjectGearDeburr/documentatie/conceptkeuze/morfologisch overzicht in-uitvoer.xlsx

transport frees -> schoonmaak | schoonmaak | transport schoonmaak -> afbramen | afbramen | transport afbramen ->uitvoer
robotarm |  | robotarm | zie andere morfologische overzicht | robotarm
indextafel |  | indextafel |  | indextafel
loopkraan |  | loopkraan |  | loopkraan
