549116/ProjectGearDeburr/documentatie/bestaande opstelling/WhatsApp Image 2025-11-14 at 09.37.18.jpeg

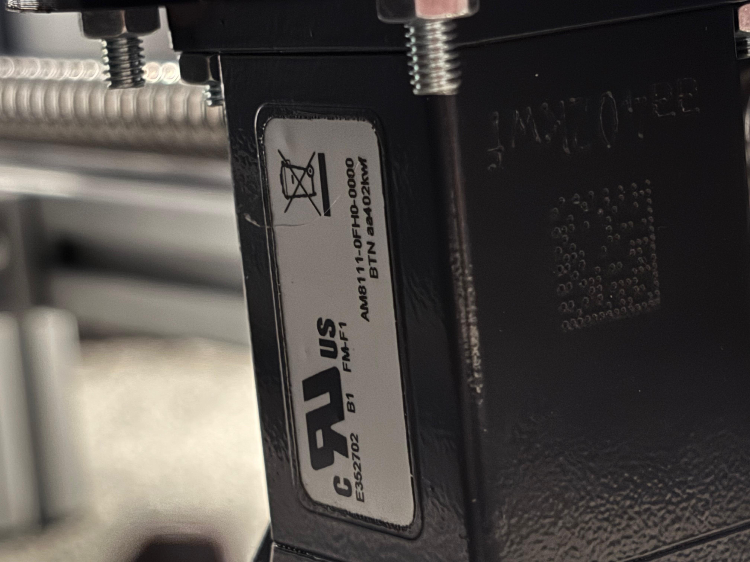
documentatie/bestaande opstelling/WhatsApp Image 2025-11-14 at 09.37.18.jpeg
