549116/ProjectGearDeburr/documentatie/bestaande opstelling/WhatsApp Image 2025-11-18 at 11.09.09.jpeg

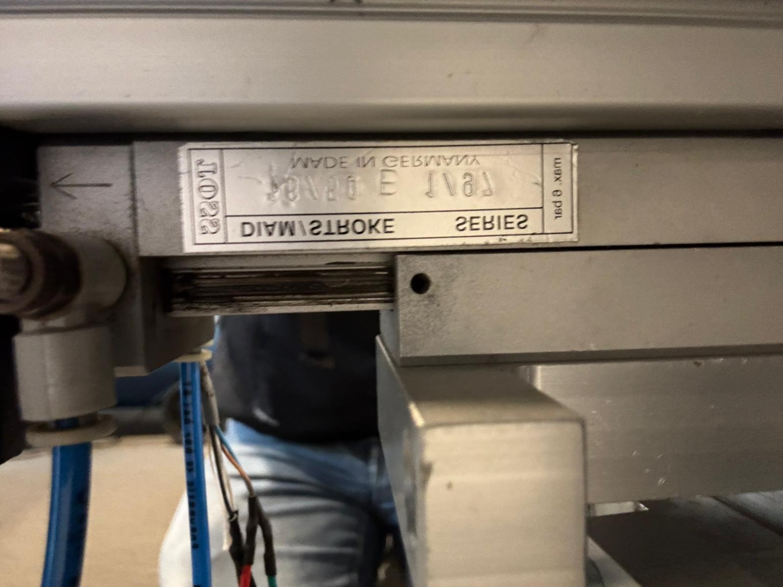
documentatie/bestaande opstelling/WhatsApp Image 2025-11-18 at 11.09.09.jpeg
