549116/ProjectGearDeburr/documentatie/concepttekeningen/schetsen afbramen/concept 2 gijs.png

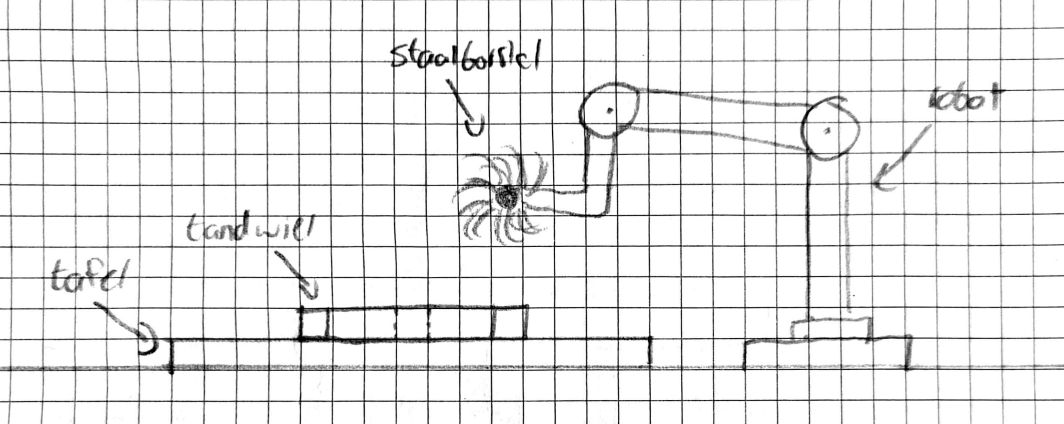
documentatie/concepttekeningen/schetsen afbramen/concept 2 gijs.png
