549116/ProjectGearDeburr/documentatie/concepttekeningen/schetsen afbramen/eerste concept Sven.jpg

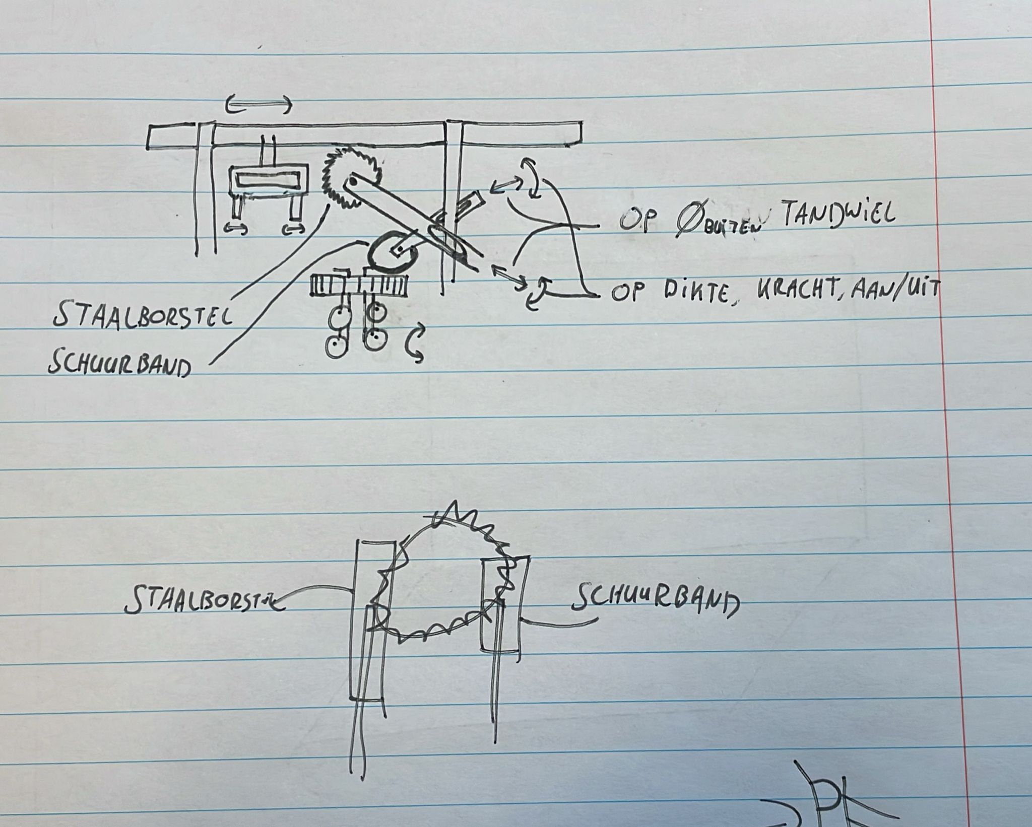
documentatie/concepttekeningen/schetsen afbramen/eerste concept Sven.jpg
