549116/ProjectGearDeburr/documentatie/concepttekeningen/schetsen afbramen/schets rondlopende frees.jpeg

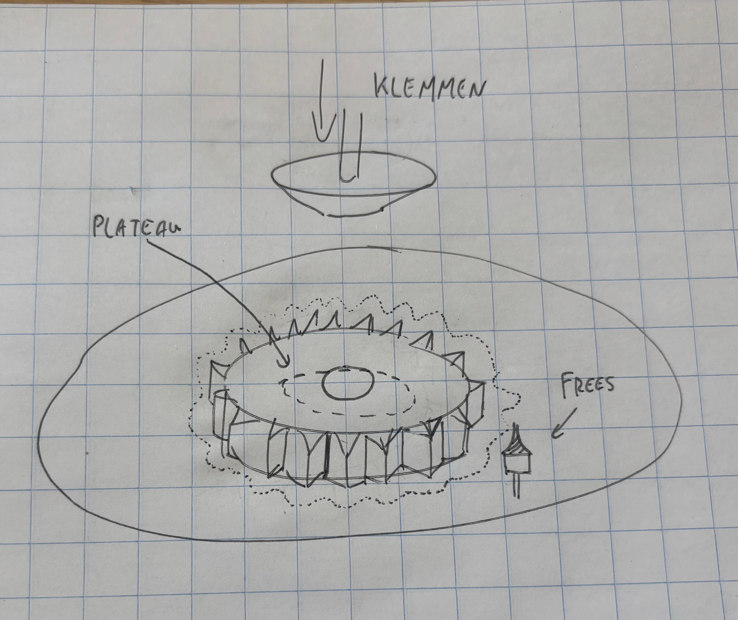
documentatie/concepttekeningen/schetsen afbramen/schets rondlopende frees.jpeg
