549116/ProjectGearDeburr/documentatie/concepttekeningen/schetsen afbramen/toevoeging eerste concept Gijs.jpg

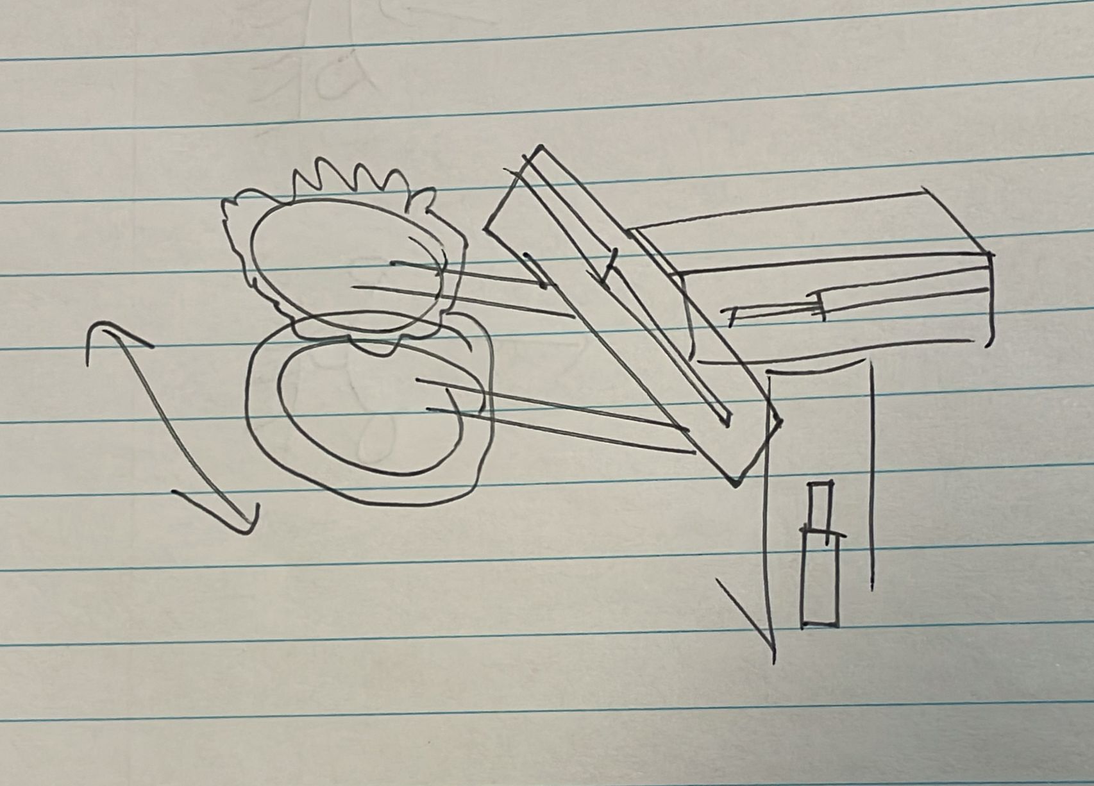
documentatie/concepttekeningen/schetsen afbramen/toevoeging eerste concept Gijs.jpg
