549116/ProjectGearDeburr/documentatie/concepttekeningen/schetsen integratie/draaitafel.png

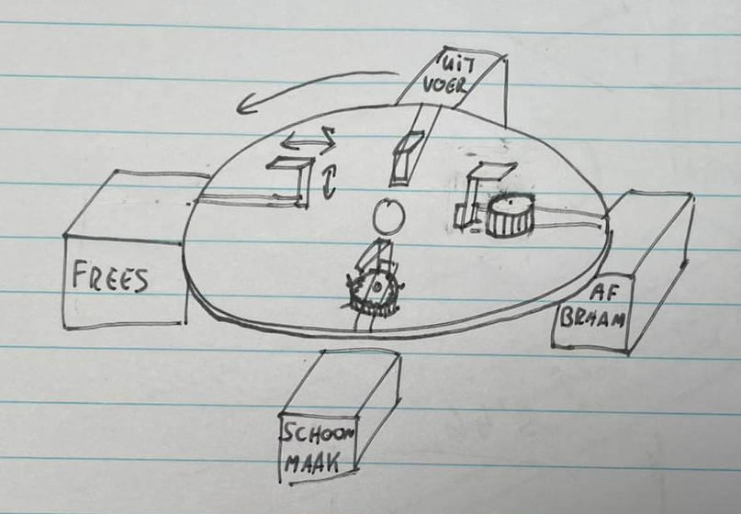
documentatie/concepttekeningen/schetsen integratie/draaitafel.png
