549116/ProjectGearDeburr/documentatie/concepttekeningen/schetsen integratie/index tafel meer detail.jpg

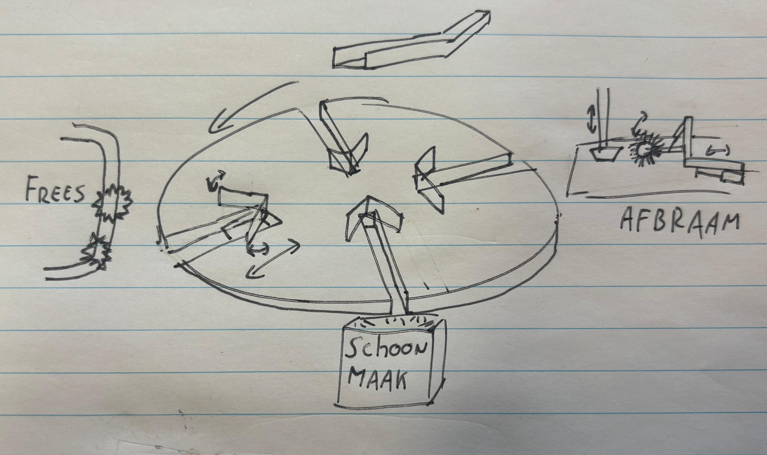
documentatie/concepttekeningen/schetsen integratie/index tafel meer detail.jpg
