549116/ProjectGearDeburr/documentatie/concepttekeningen/schetsen integratie/rails bovenlangs.jpg

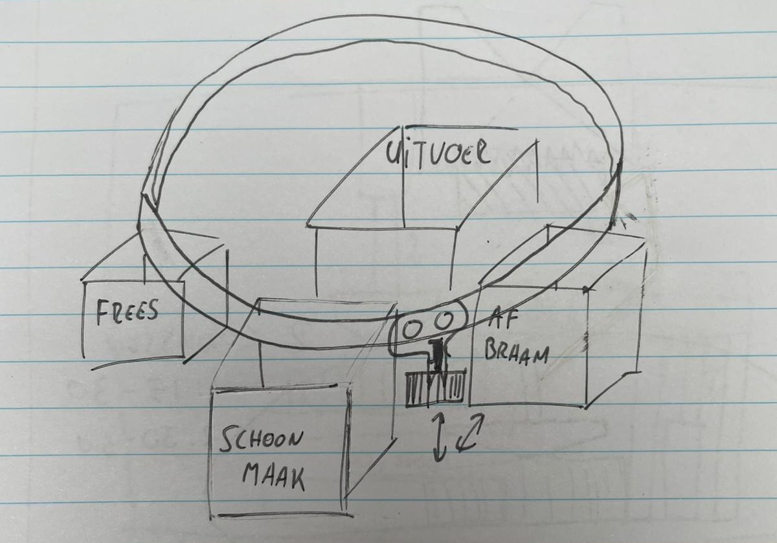
documentatie/concepttekeningen/schetsen integratie/rails bovenlangs.jpg
