549116/ProjectGearDeburr/documentatie/concepttekeningen/schetsen integratie/rechte rails bovenlangs.jpg

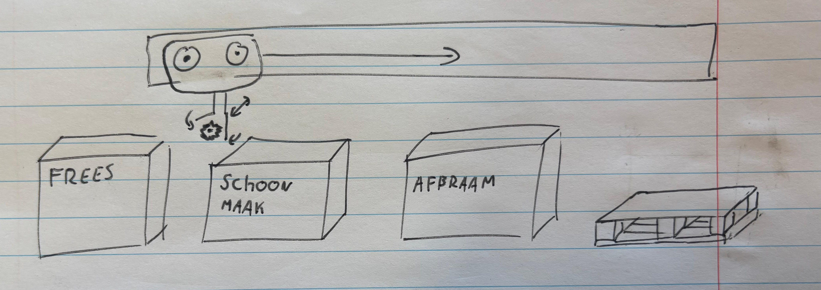
documentatie/concepttekeningen/schetsen integratie/rechte rails bovenlangs.jpg
