549116/ProjectGearDeburr/documentatie/diagrammen/electrical diagram current.png

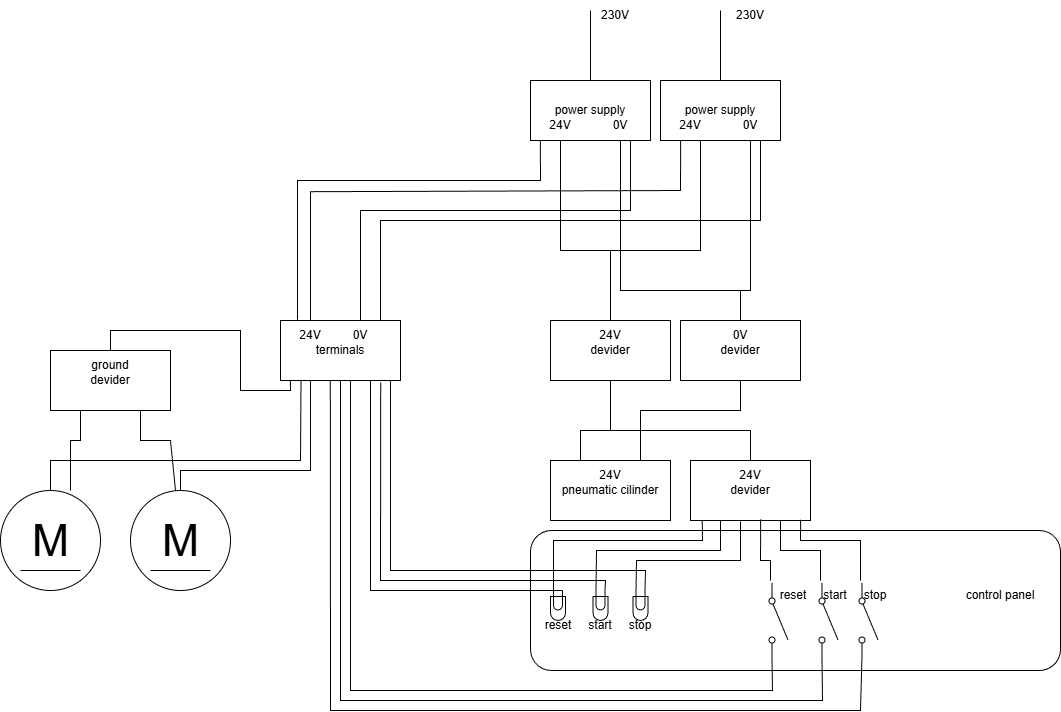
documentatie/diagrammen/electrical diagram current.png
