549116/ProjectGearDeburr/documentatie/proof of concept/foto/WhatsApp Image 2025-10-16 at 11.18.47_62da453f.jpg

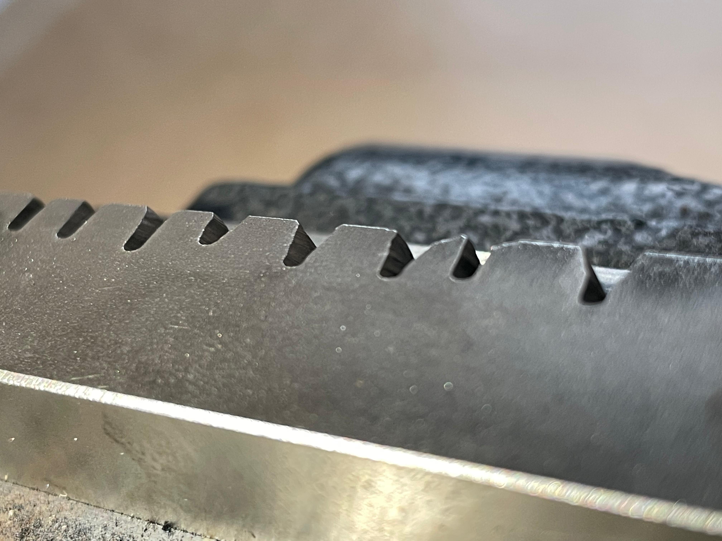
documentatie/proof of concept/foto/WhatsApp Image 2025-10-16 at 11.18.47_62da453f.jpg
