549116/ProjectGearDeburr/documentatie/proof of concept/foto/WhatsApp Image 2025-10-16 at 11.18.48_e5664db1.jpg

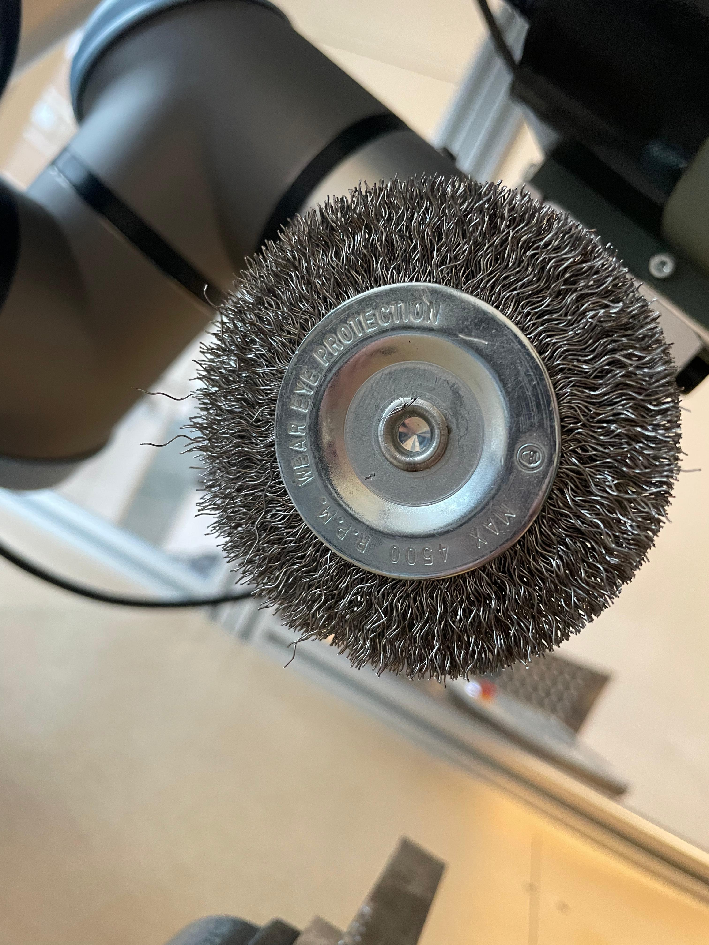
documentatie/proof of concept/foto/WhatsApp Image 2025-10-16 at 11.18.48_e5664db1.jpg
