549116/ProjectGearDeburr/documentatie/proof of concept/foto/WhatsApp Image 2025-10-16 at 11.18.50_1c2ecd3f.jpg

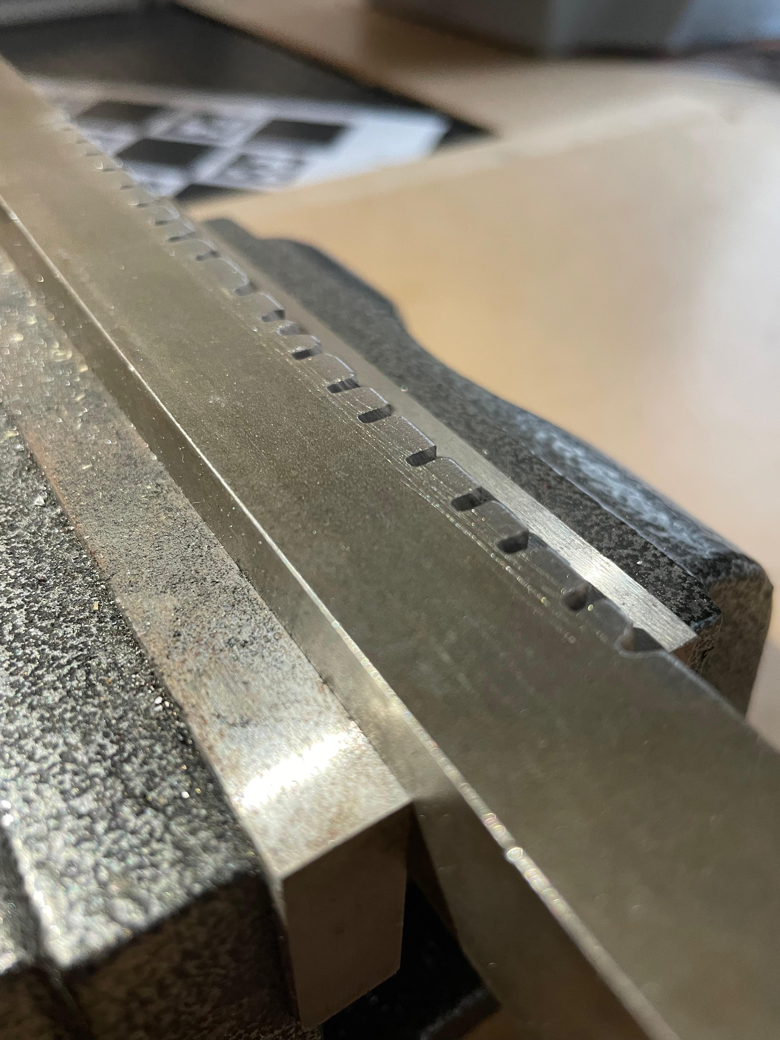
documentatie/proof of concept/foto/WhatsApp Image 2025-10-16 at 11.18.50_1c2ecd3f.jpg
