549116/ProjectGearDeburr/documentatie/proof of concept/foto/WhatsApp Image 2025-10-16 at 11.18.51_2d85fec1.jpg

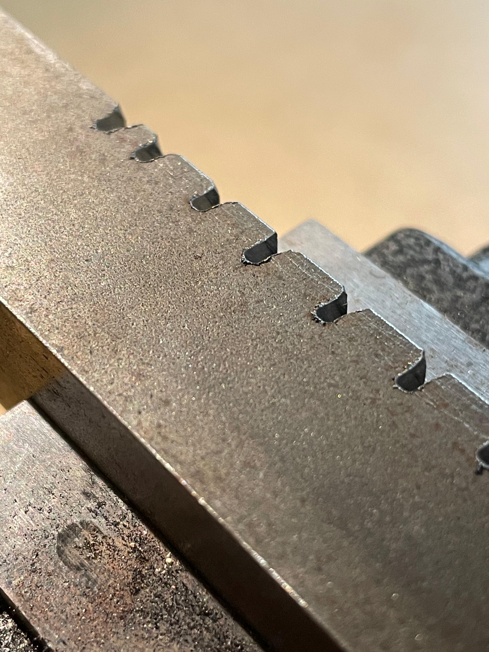
documentatie/proof of concept/foto/WhatsApp Image 2025-10-16 at 11.18.51_2d85fec1.jpg
