549116/ProjectGearDeburr/documentatie/proof of concept/foto/WhatsApp Image 2025-10-16 at 11.18.52_8143f336.jpg

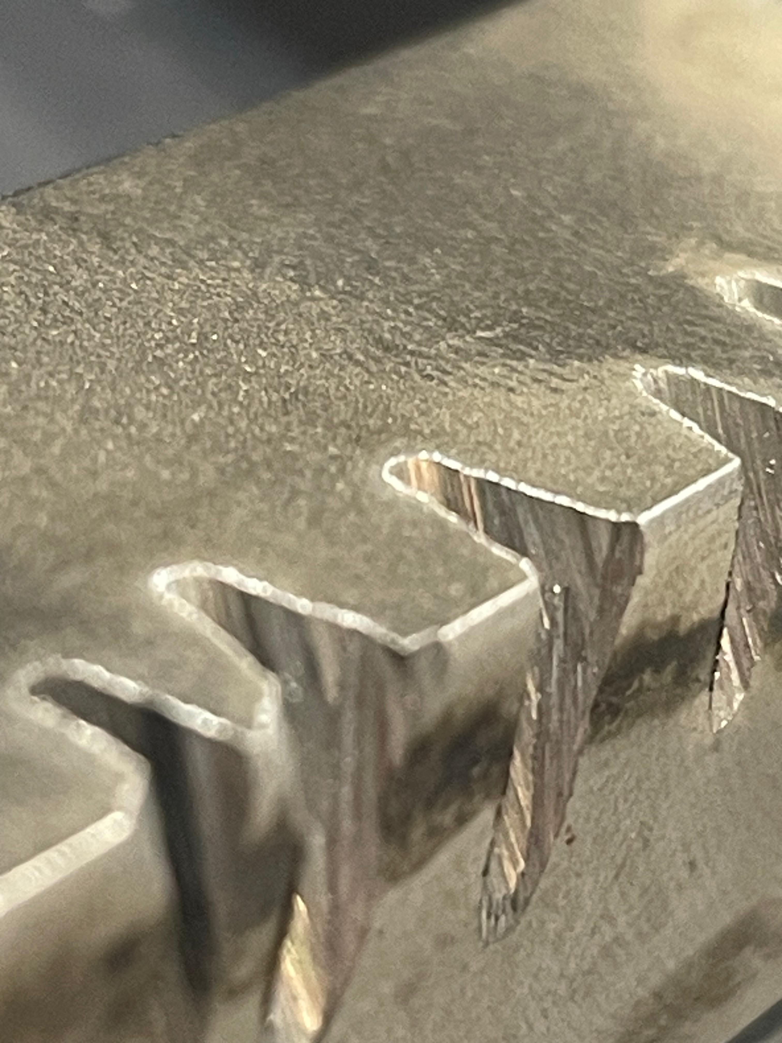
documentatie/proof of concept/foto/WhatsApp Image 2025-10-16 at 11.18.52_8143f336.jpg
