549116/ProjectGearDeburr/documentatie/proof of concept/foto/WhatsApp Image 2025-10-16 at 11.18.53_0b3efcab.jpg

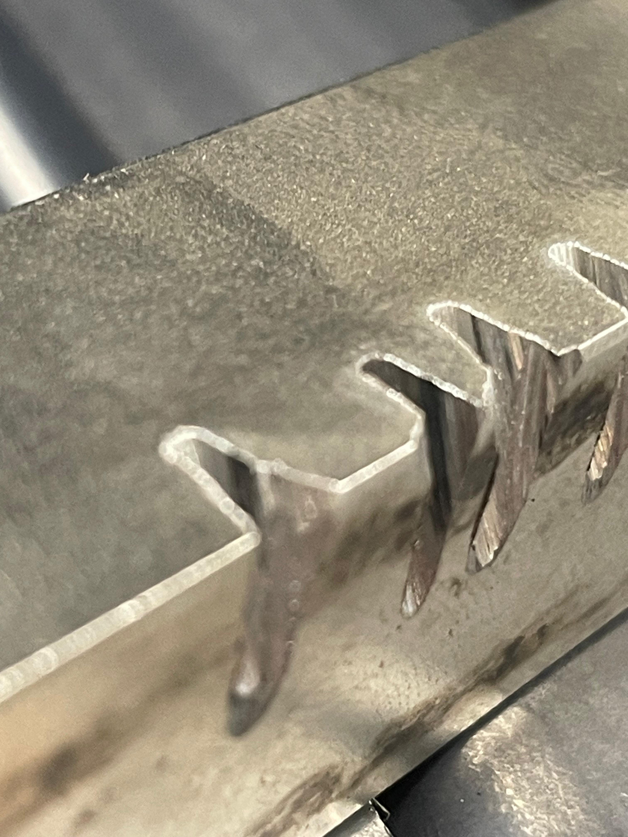
documentatie/proof of concept/foto/WhatsApp Image 2025-10-16 at 11.18.53_0b3efcab.jpg
