549116/ProjectGearDeburr/documentatie/proof of concept/foto/WhatsApp Image 2025-10-16 at 11.18.53_4b8d326b.jpg

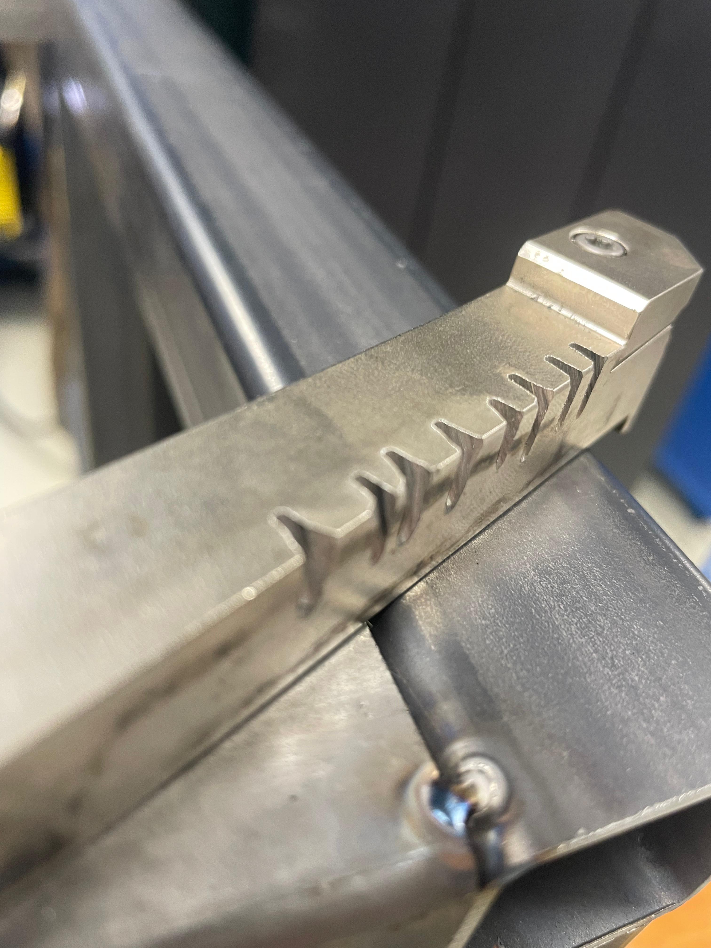
documentatie/proof of concept/foto/WhatsApp Image 2025-10-16 at 11.18.53_4b8d326b.jpg
