549116/ProjectGearDeburr/documentatie/proof of concept/foto/WhatsApp Image 2025-10-16 at 11.18.54_9ef50d9a.jpg

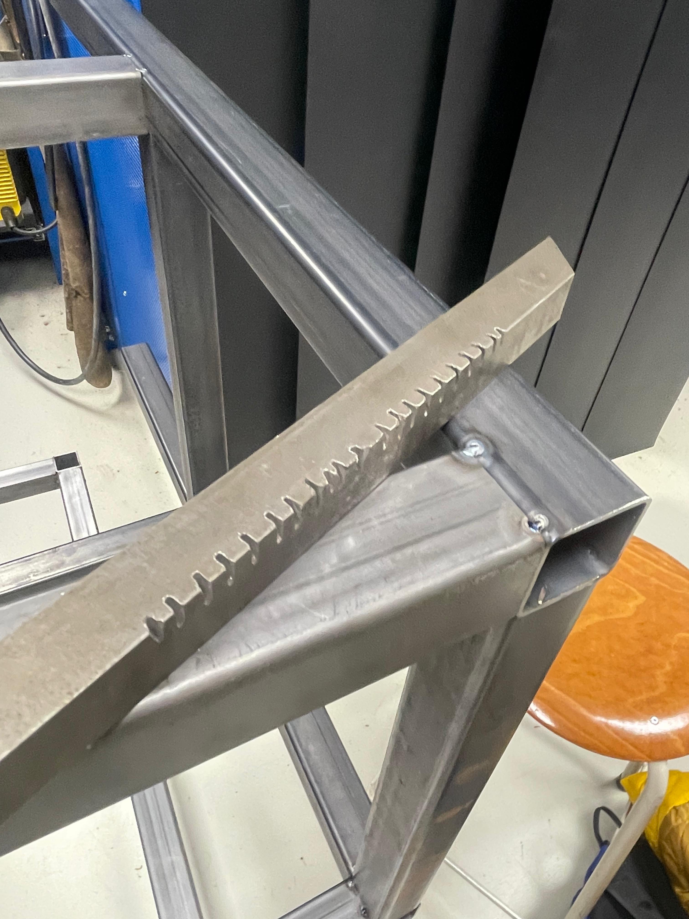
documentatie/proof of concept/foto/WhatsApp Image 2025-10-16 at 11.18.54_9ef50d9a.jpg
