549116/ProjectGearDeburr/documentatie/proof of concept/foto/WhatsApp Image 2025-10-16 at 11.18.55_cd2e0dfb.jpg

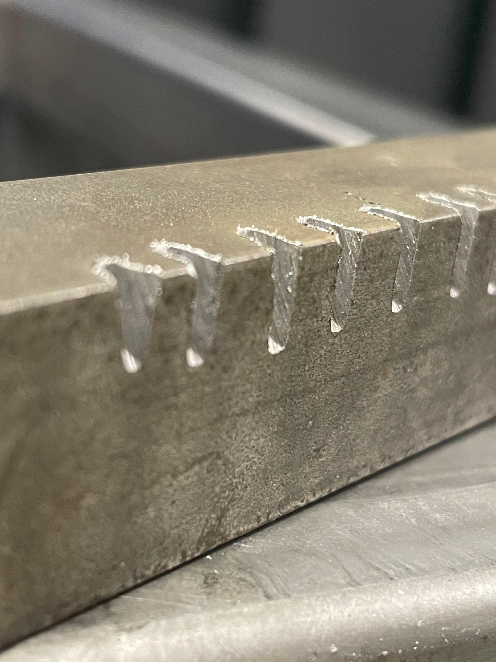
documentatie/proof of concept/foto/WhatsApp Image 2025-10-16 at 11.18.55_cd2e0dfb.jpg
