549116/ProjectGearDeburr/solidworks/solidworks/koopdelen/Motor 12v/pic1.jpg

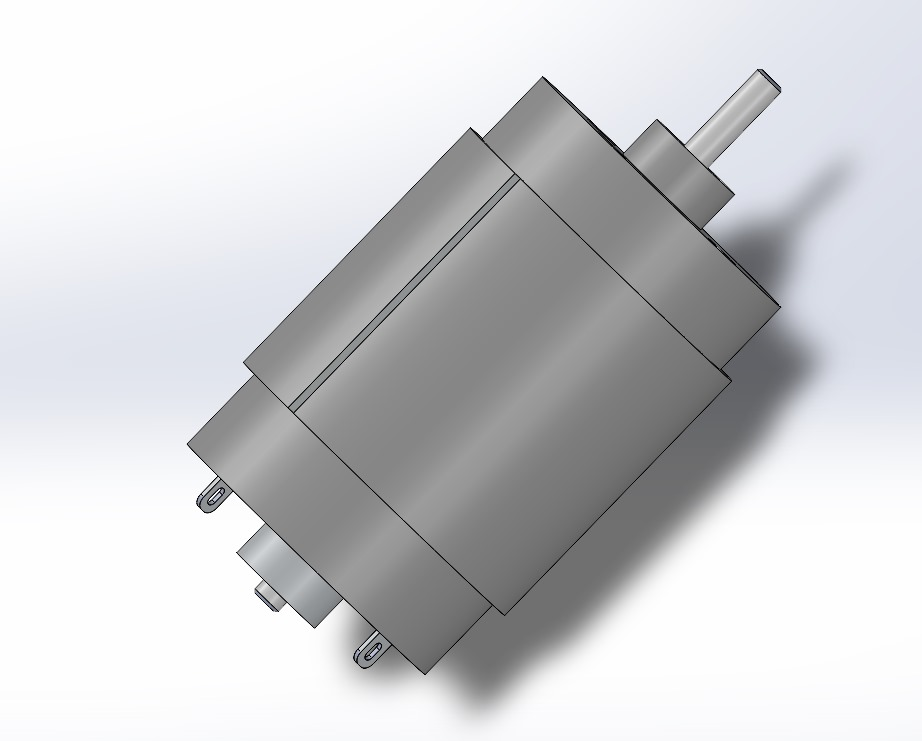
solidworks/solidworks/koopdelen/Motor 12v/pic1.jpg
