549116/ProjectGearDeburr/solidworks/solidworks/koopdelen/Motor 12v/pic2.jpg

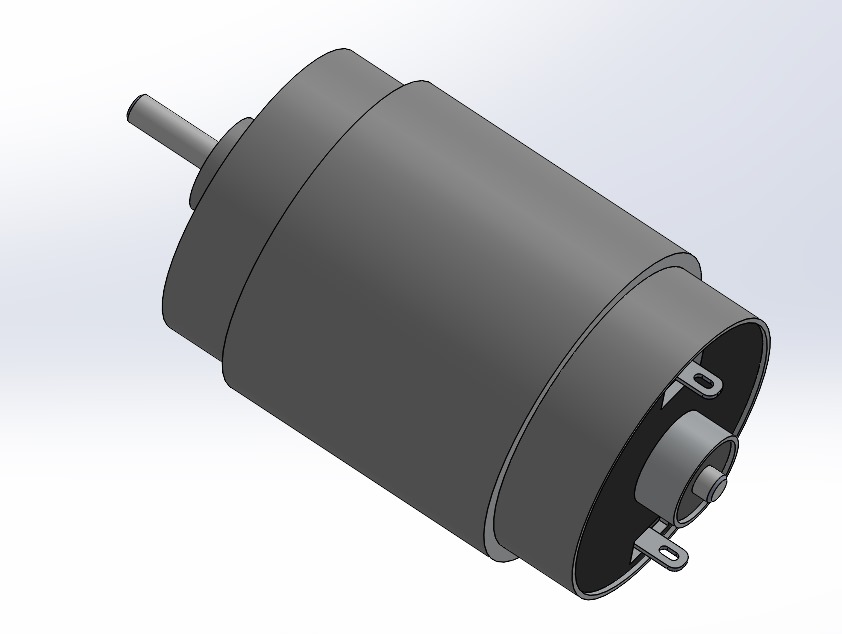
solidworks/solidworks/koopdelen/Motor 12v/pic2.jpg
