549116/ProjectGearDeburr/solidworks/solidworks/koopdelen/Motor 12v/pic3.jpg

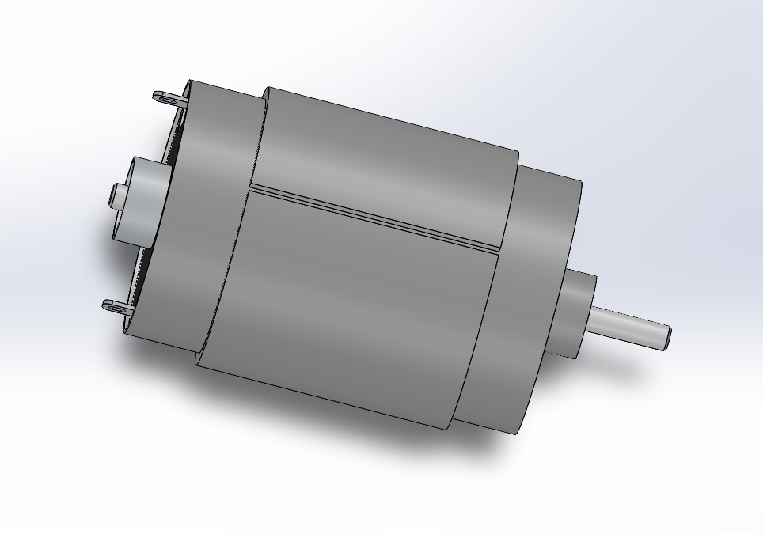
solidworks/solidworks/koopdelen/Motor 12v/pic3.jpg
