549116/ProjectGearDeburr/berekeningen/geleiders.xlsx

inputs |  |  |  | berekeningen
grootheid | waarde | eenheid | opmerking | grootheid | waarde | eenheid | opmerking
L1 | 200 | mm |  | F3 | 39.24 | N | drukkracht
 | 0.2 | m |  | F2 | 68.67 | N | trekkracht
L2 | 150 | mm |  | punt 2 sterk genoeg | ja
 | 0.15 | m |  | punt 3 sterk genoeg | ja
F1 | 3 | kg
 | 29.43 | N
C0 | 8330 | N | trekkracht geleider
c1 | 13500 | N | drukkracht geleider
#VALUE!
