549116/ProjectGearDeburr/documentatie/bestellijst/bestellijst automation.xlsx

Sheet: Uitleg document
Uitleg document:
Blad werkplaats: |  | Blad Inkoop
Positie nummer: | Plek waar het onderdeel zit, gebaseerd op je assambly. | Positie nummer: | Plek waar het onderdeel zit, gebaseerd op je assambly.
Soort materiaal: | Hier moet je je materiaal aangeven doormiddel van het pulldown menu. | Bestelnummer: | Hier vul je het bestelnummer in van het artikel dat je nodig hebt.
Aantal: | Hier vul je in hoeveel stuks je van het onderdeel nodig hebt. | Artikelnummer: | Hier vul je het artikelnummer in van het artikel dat je nodig hebt.
Hoofdbewerking: | Hier kies je de hoofdbewerking die nodig is voor het product doormiddel van het pulldown menu. | Leverancier: | Hier vul je de leverancier in doormiddel van het gegeven pulldown menu.
Afmetingen: | Hier vul je de gegeven afmeting in doormiddel van het pulldown menu van het te maken product. | Aantal: | Hier vul je in hoeveel stuks je nodig hebt van het in te kopen onderdeel.
Lengte: | Hier wordt de lengte van het te produceren product ingevuld. | Prijs: | Hier vul je in hoeveel het onderdeel kost.
Leverancier: | Hier vul je de leverancier in doormiddel van het gegeven pulldown menu. | Totaalprijs: | Hier vul je in hoeveel alle onderdelen kosten indien je er meer dan één nodig hebt.
Product omschrijving: | Hier vul je eventueel extra informatie in die van toepassing is op het onderdeel. (Bijv. draai en freeswerk.)
Mochten afmetingen van een product anders wezen dan de standaardproducten. Overleggen met de werkplaats. Indien het op voorraad is kan er overlegd worden. Anders zal het ontwerp aangepast moeten worden. |  |  |  | Naam groep:
 |  |  |  | Besteld door:
 |  |  |  | E-mail adres:
 |  |  |  | Student nummer:
 |  |  |  | Datum:

Sheet: Werkplaats
Bestellijst duurzaam ontwerpen (Ruw materiaal)
Pos. Nr. | Soort materiaal: | Aantal: | Hoofd bewerking: | Afmetingen profiel: | Afmetingen Staf: | Lengte: | Leverancier: | Tekening nummer en omschrijving:
1 |  |  |  |  |  |  | MCB
2
3
4
5
6
7
8
9
10
11
12
13
14
15
16
17
18
19
20
21
22
23
24
25
26
27
28
29
30
31
32
33
34
35
36
37
38
39
40
41
42
43
44
45
46
47
48
49

Sheet: Inkoop
Bestellijst duurzaam ontwerpen (koopdelen)
Pos nr.: | Bestelnummer: | Artikelomschrijving: | Tekening nummer: | Leverancier: | Aantal/eenheid: | Prijs/eenheid: | Totaalprijs:
1 |  | lazy susan 6 inch |  |  | 1.00 | €6.70 | €6.70
2 |  | geleiders |  |  | 2.00 |  | €0.00
3 |  |  |  |  |  |  | €0.00
4 |  |  |  |  |  |  | €0.00
5 |  |  |  |  |  |  | €0.00
6 |  |  |  |  |  |  | €0.00
7 |  |  |  |  |  |  | €0.00
8 |  |  |  |  |  |  | €0.00
9 |  |  |  |  |  |  | €0.00
10 |  |  |  |  |  |  | €0.00
11 |  |  |  |  |  |  | €0.00
12 |  |  |  |  |  |  | €0.00
13 |  |  |  |  |  |  | €0.00
14 |  |  |  |  |  |  | €0.00
15 |  |  |  |  |  |  | €0.00
16 |  |  |  |  |  |  | €0.00
17 |  |  |  |  |  |  | €0.00
18 |  |  |  |  |  |  | €0.00
19 |  |  |  |  |  |  | €0.00
20 |  |  |  |  |  |  | €0.00
21 |  |  |  |  |  |  | €0.00
22 |  |  |  |  |  |  | €0.00
23 |  |  |  |  |  |  | €0.00
24 |  |  |  |  |  |  | €0.00
25 |  |  |  |  |  |  | €0.00
26 |  |  |  |  |  |  | €0.00
27 |  |  |  |  |  |  | €0.00
28 |  |  |  |  |  |  | €0.00
29 |  |  |  |  |  |  | €0.00
30 |  |  |  |  |  |  | €0.00
31 |  |  |  |  |  |  | €0.00
32 |  |  |  |  |  |  | €0.00
33 |  |  |  |  |  |  | €0.00
34 |  |  |  |  |  |  | €0.00
35 |  |  |  |  |  |  | €0.00
36 |  |  |  |  |  |  | €0.00
37 |  |  |  |  |  |  | €0.00
38 |  |  |  |  |  |  | €0.00
39 |  |  |  |  |  |  | €0.00
40 |  |  |  |  |  |  | €0.00
41 |  |  |  |  |  |  | €0.00
42 |  |  |  |  |  |  | €0.00
43 |  |  |  |  |  |  | €0.00
44 |  |  |  |  |  |  | €0.00
45 |  |  |  |  |  |  | €0.00
46 |  |  |  |  |  |  | €0.00
47 |  |  |  |  |  |  | €0.00
48 |  |  |  |  |  |  | €0.00
49 |  |  |  |  |  |  | €0.00
50 |  |  |  |  |  |  | €0.00
51 |  |  |  |  |  |  | €0.00
52 |  |  |  |  |  |  | €0.00
53 |  |  |  |  |  |  | €0.00
54 |  |  |  |  |  |  | €0.00
55 |  |  |  |  |  |  | €0.00
56 |  |  |  |  |  |  | €0.00
57 |  |  |  |  |  |  | €0.00
58 |  |  |  |  |  |  | €0.00
59 |  |  |  |  |  |  | €0.00
60 |  |  |  |  |  |  | €0.00
61 |  |  |  |  |  |  | €0.00
62 |  |  |  |  |  |  | €0.00
63 |  |  |  |  |  |  | €0.00
64 |  |  |  |  |  |  | €0.00
65 |  |  |  |  |  |  | €0.00
