549116/ProjectGearDeburr/solidworks/solidworks/koopdelen/LazySusan.SLDASM

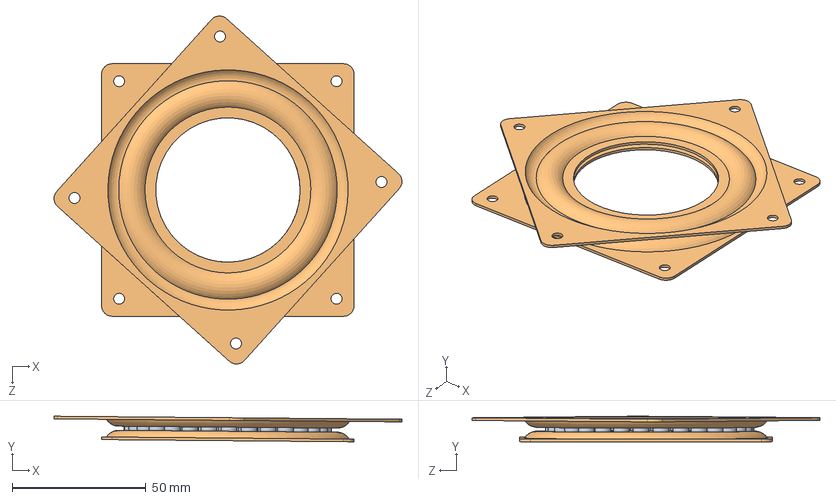
[picture p118: CAD file, 2025-11-12]
solidworks/solidworks/koopdelen/LazySusan.SLDASM
130.2 x 9.58 x 130.2 mm
6mmBearing x 30
HalfLazySusan x 2
