549116/ProjectGearDeburr/solidworks/PACK AND GO (totale assembly heet hoofdassembly)/gebruikte cilinder.SLDASM

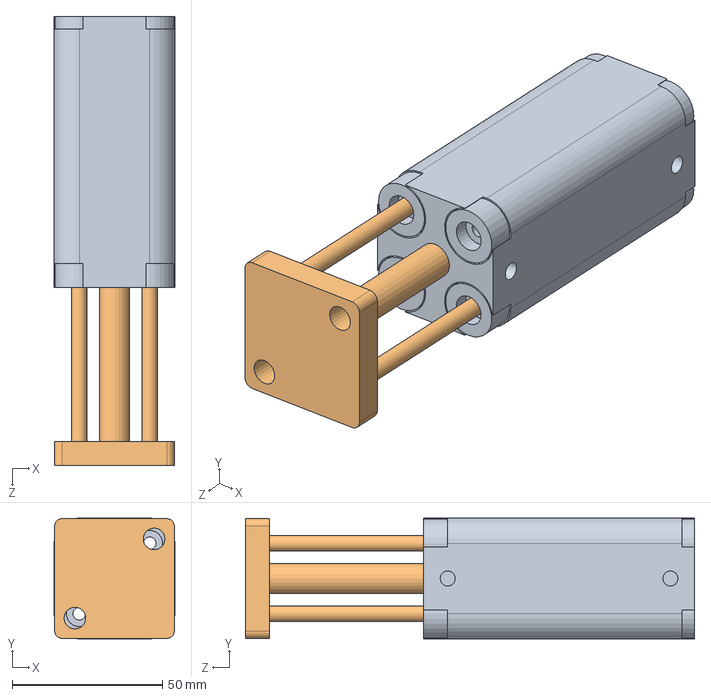
[picture p119: CAD file, 2026-01-21]
solidworks/PACK AND GO (totale assembly heet hoofdassembly)/gebruikte cilinder.SLDASM
40.2 x 40.2 x 149.2 mm
cilinder bewegend
cilinder vast
