549116/ProjectGearDeburr/solidworks/solidworks/koopdelen/Motor 12v/motor 12v.SLDASM

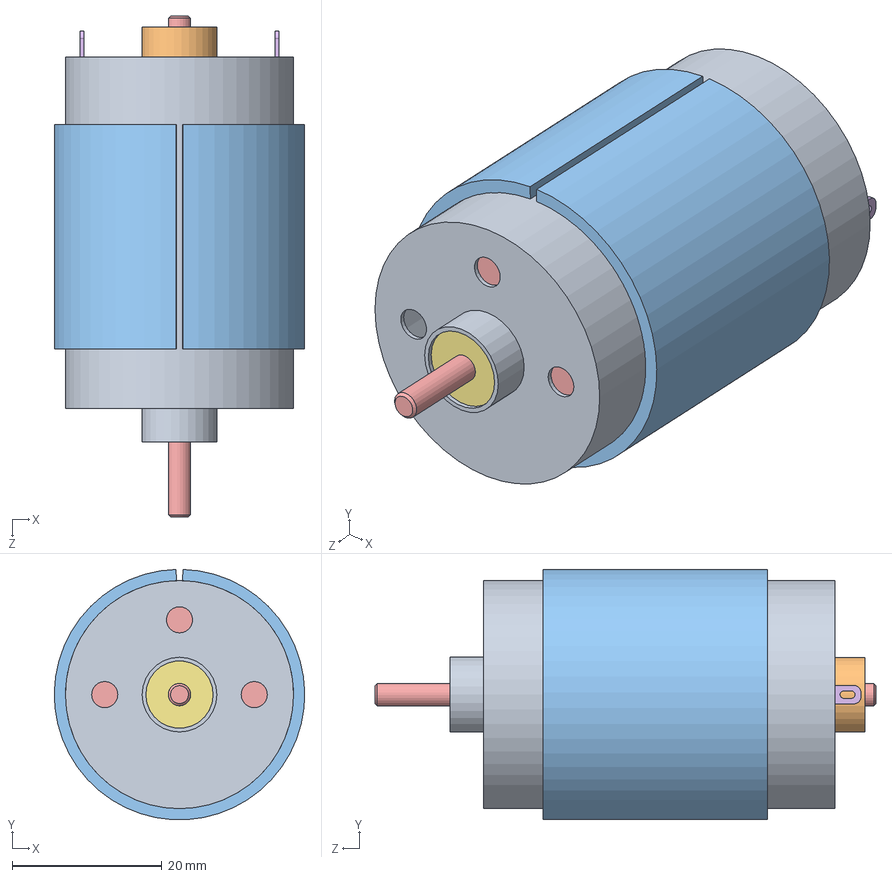
[picture p120: CAD file, 2025-11-12]
solidworks/solidworks/koopdelen/Motor 12v/motor 12v.SLDASM
33.5 x 33.5 x 67.0 mm
Case 1
Case 2
Case 3
Magnet x 2
Rotor
Connect x 2
Shaft Holder x 2
