549116/ProjectGearDeburr/solidworks/automation/plateau goed.SLDPRT

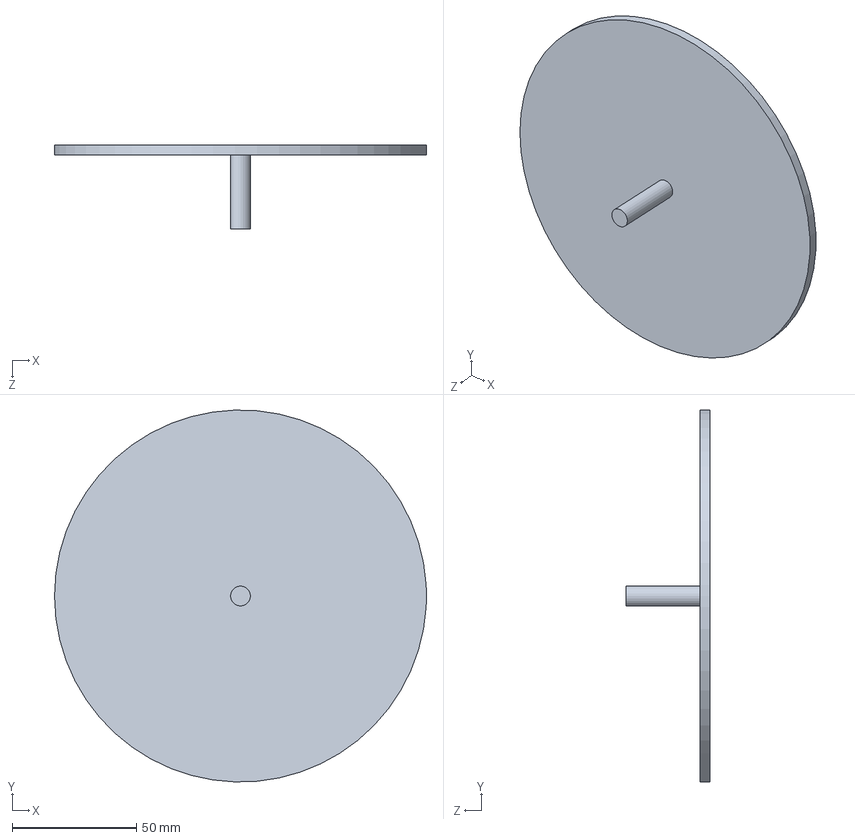
[picture p121: CAD file, 2025-11-12]
solidworks/automation/plateau goed.SLDPRT
150.0 x 149.9 x 34.0 mm
