549116/ProjectGearDeburr/solidworks/solidworks/automation/onderplaat.SLDPRT

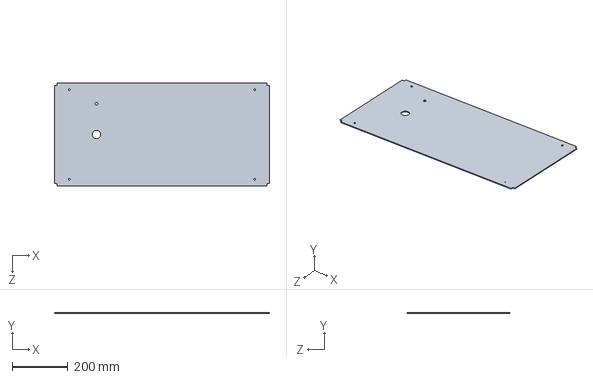
[picture p122: CAD file, 2026-01-20]
solidworks/solidworks/automation/onderplaat.SLDPRT
768.0 x 3.00 x 368.0 mm
