549116/ProjectGearDeburr/solidworks/solidworks/koopdelen/maxion re40 motor/motor.SLDPRT

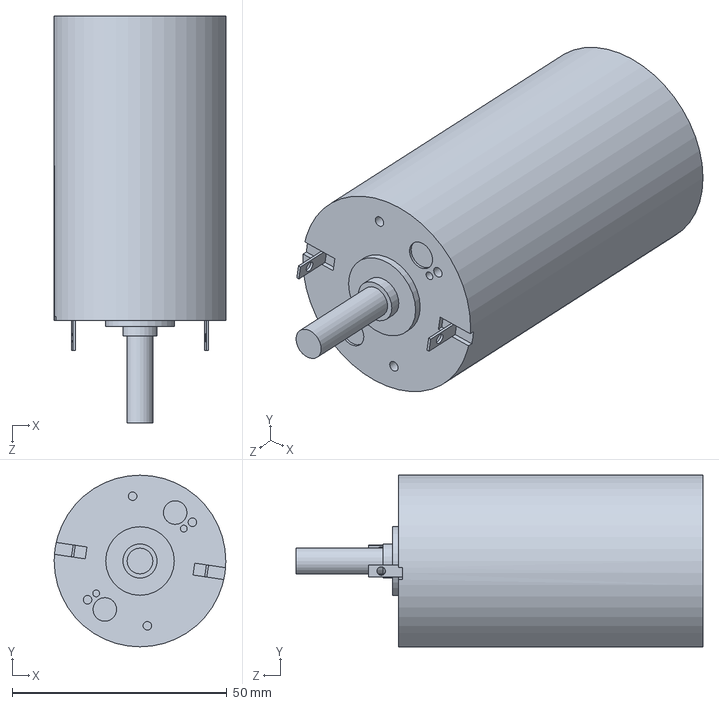
[picture p123: CAD file, 2026-01-20]
solidworks/solidworks/koopdelen/maxion re40 motor/motor.SLDPRT
40.0 x 40.0 x 94.9 mm
