549116/ProjectGearDeburr/solidworks/solidworks/koopdelen/Motor 12v/shaft B.SLDPRT

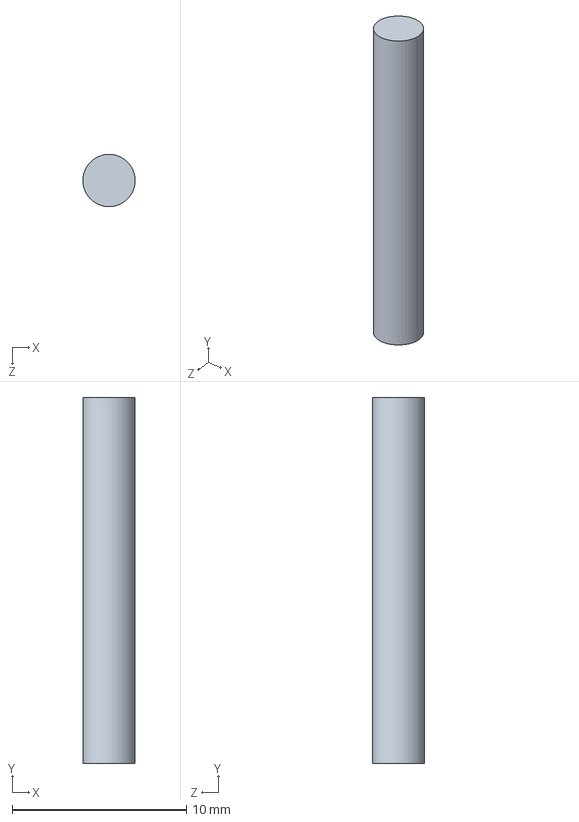
[picture p124: CAD file, 2025-11-12]
solidworks/solidworks/koopdelen/Motor 12v/shaft B.SLDPRT
3.00 x 21.0 x 3.00 mm
