549116/ProjectGearDeburr/solidworks/solidworks/koopdelen/Poulie GT2 80 dents.SLDPRT

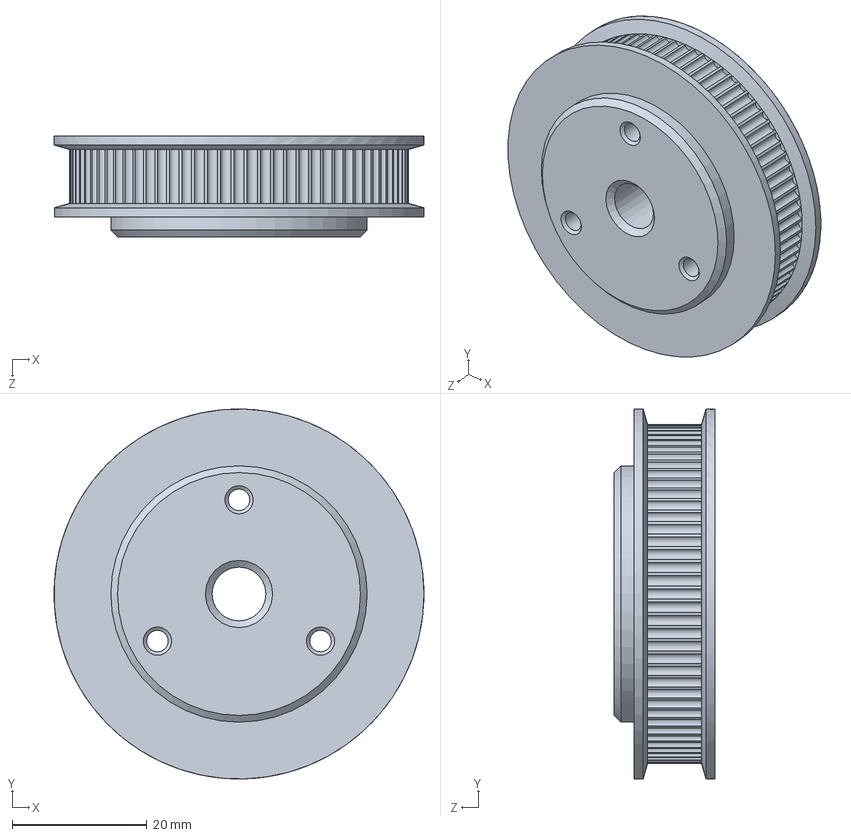
[picture p125: CAD file, 2026-01-20]
solidworks/solidworks/koopdelen/Poulie GT2 80 dents.SLDPRT
55.0 x 55.0 x 15.0 mm
