549116/ProjectGearDeburr/solidworks/solidworks/lasersnijden lading 1/bodemplaat.DXF

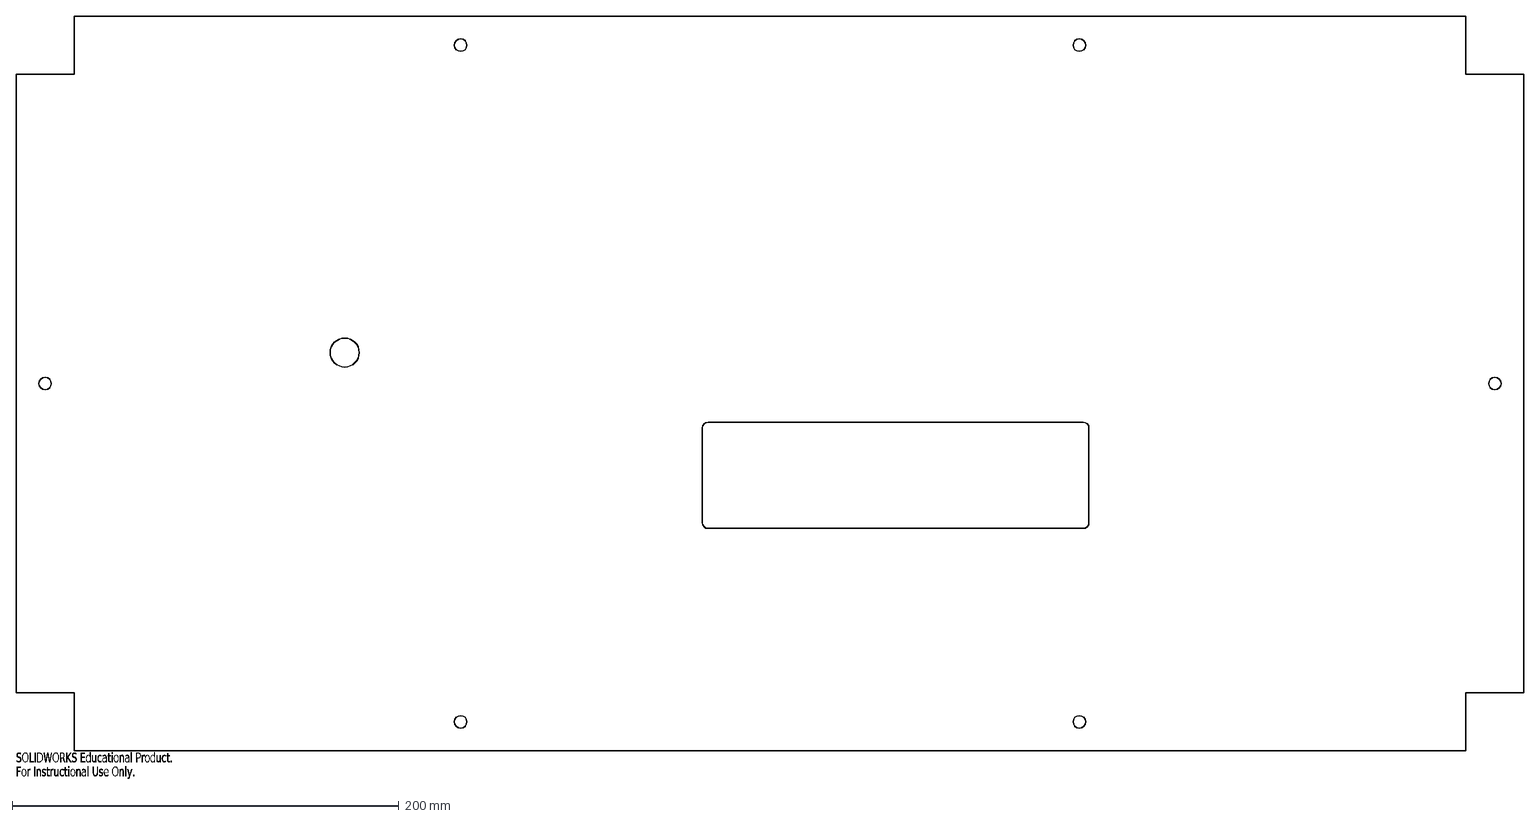
[picture p126: CAD file, 2026-01-20]
solidworks/solidworks/lasersnijden lading 1/bodemplaat.DXF
SOLIDWORKS Educational Product.
For Instructional Use Only.
