549116/ProjectGearDeburr/solidworks/solidworks/tandwiel 17 tands modul 1.SLDPRT

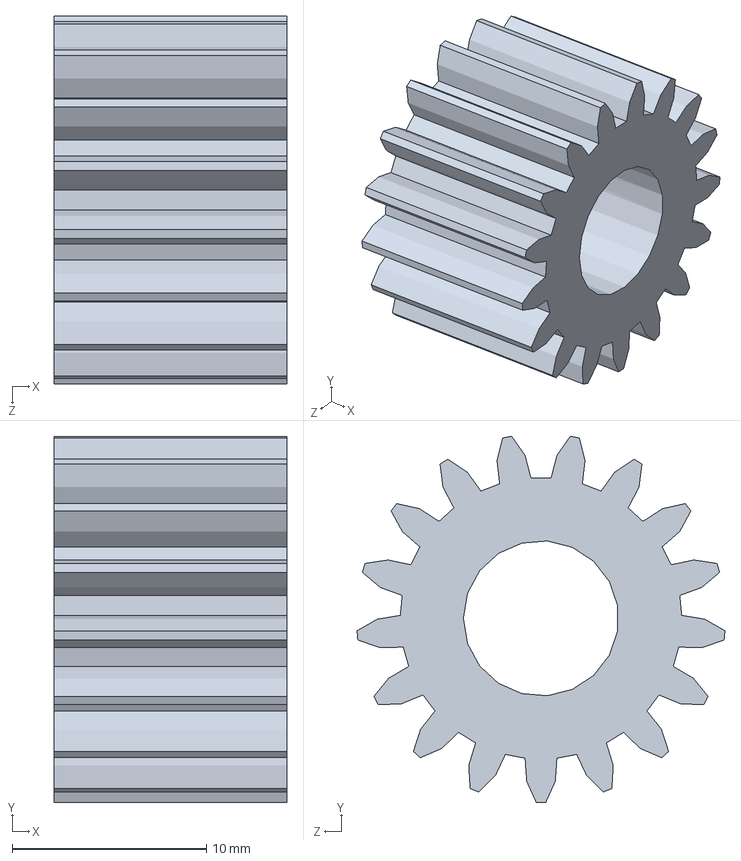
[picture p127: CAD file, 2026-01-20]
solidworks/solidworks/tandwiel 17 tands modul 1.SLDPRT
12.0 x 18.9 x 19.0 mm
