549116/ProjectGearDeburr/solidworks/solidworks/tandwiel klemmen/geleider.SLDPRT

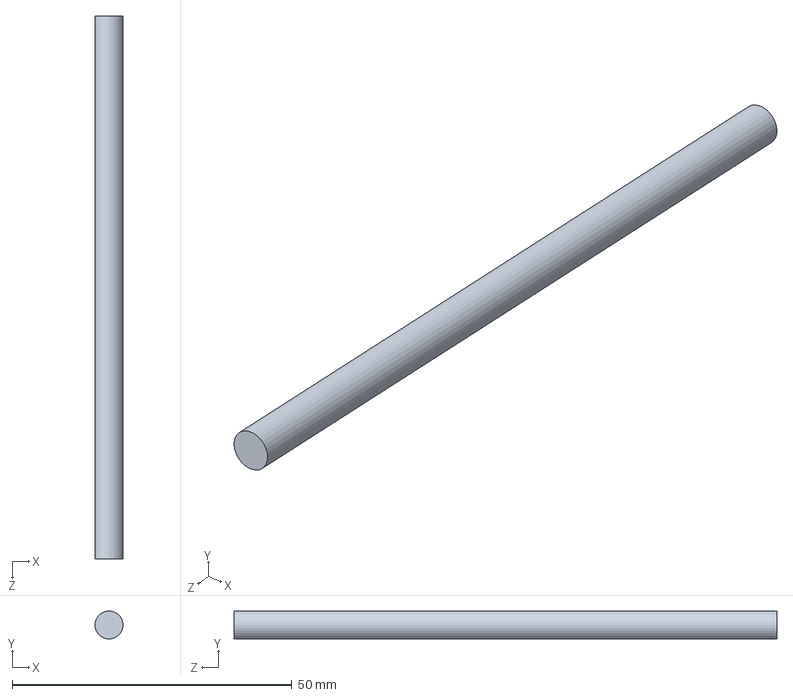
[picture p128: CAD file, 2026-01-20]
solidworks/solidworks/tandwiel klemmen/geleider.SLDPRT
5.00 x 4.97 x 97.0 mm
