549116/ProjectGearDeburr/solidworks/conus klein.SLDPRT

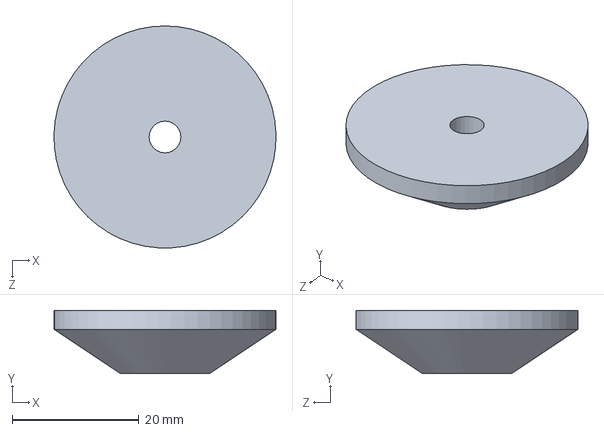
[picture p129: CAD file, 2025-11-12]
solidworks/conus klein.SLDPRT
35.0 x 10.0 x 35.0 mm
