549116/ProjectGearDeburr/solidworks/solidworks/koopdelen/6mmBearing.SLDPRT

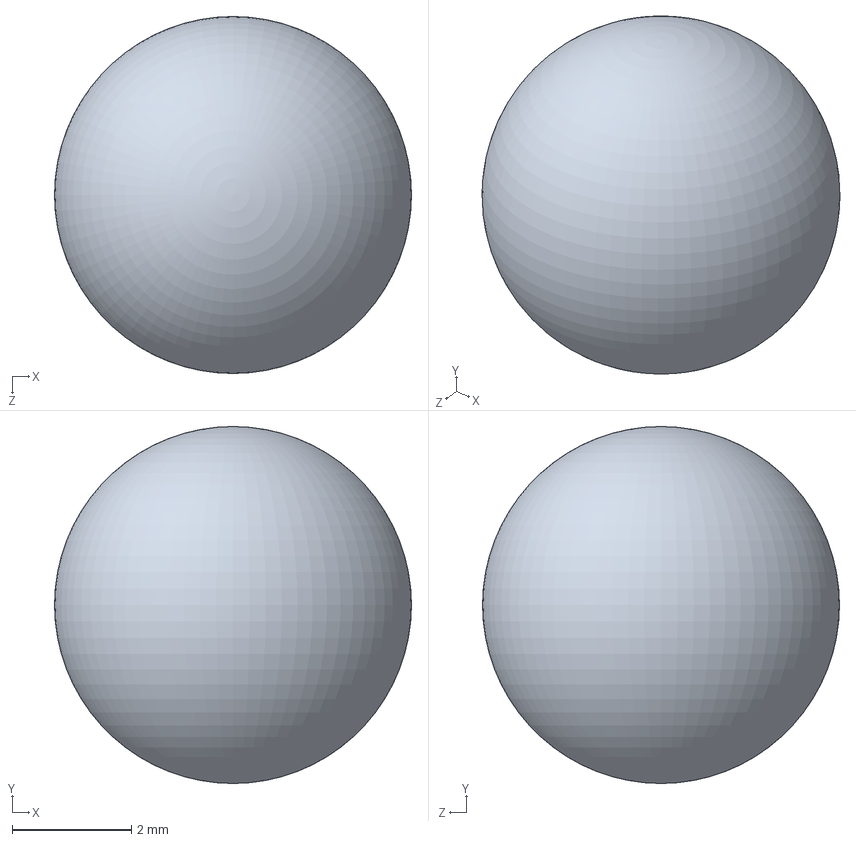
[picture p130: CAD file, 2025-11-12]
solidworks/solidworks/koopdelen/6mmBearing.SLDPRT
6.00 x 6.00 x 6.00 mm
