549116/ProjectGearDeburr/solidworks/solidworks/koopdelen/maxion re40 motor/Maxon RE40.STEP

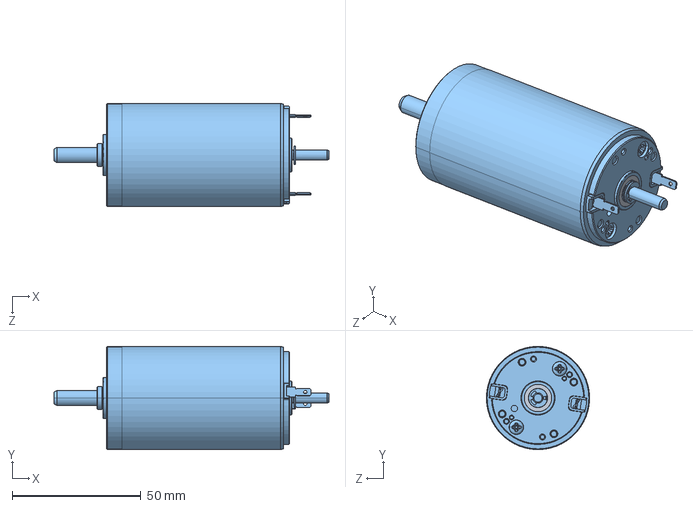
[picture p131: CAD file, 2026-01-20]
solidworks/solidworks/koopdelen/maxion re40 motor/Maxon RE40.STEP
106.6 x 40.0 x 40.0 mm
