549116/ProjectGearDeburr/solidworks/solidworks/koopdelen/Motor 12v/shaft_mid_c.SLDPRT

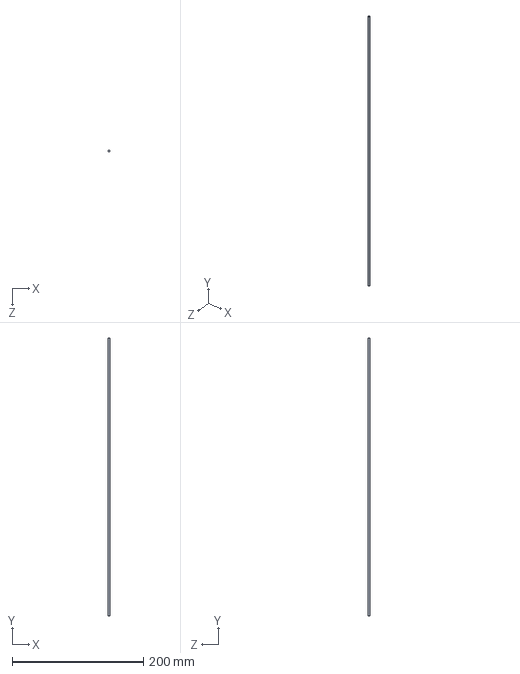
[picture p132: CAD file, 2025-11-12]
solidworks/solidworks/koopdelen/Motor 12v/shaft_mid_c.SLDPRT
3.00 x 424.0 x 3.00 mm
