549116/ProjectGearDeburr/solidworks/solidworks/lasersnijden lading 1/Flat pattern - steun motor draaiplateau.DXF

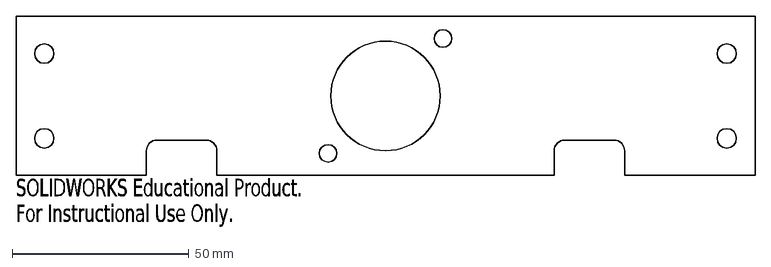
[picture p133: CAD file, 2026-01-20]
solidworks/solidworks/lasersnijden lading 1/Flat pattern - steun motor draaiplateau.DXF
SOLIDWORKS Educational Product.
For Instructional Use Only.
