549116/ProjectGearDeburr/solidworks/solidworks/aandrijfplaatje.SLDPRT

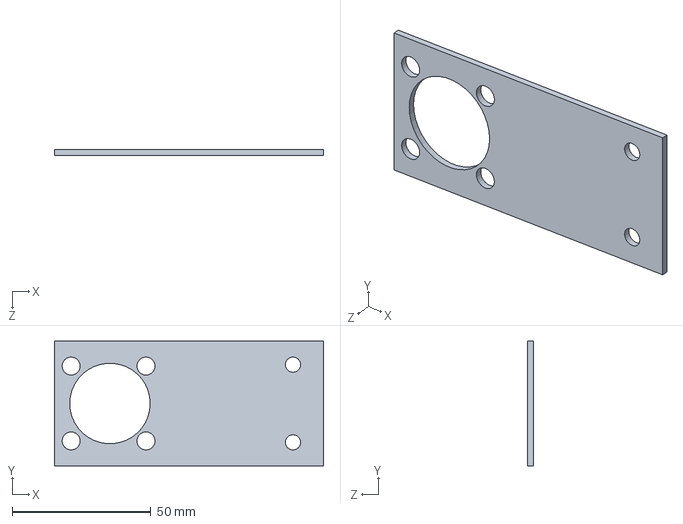
[picture p134: CAD file, 2026-01-20]
solidworks/solidworks/aandrijfplaatje.SLDPRT
97.0 x 45.0 x 2.00 mm
