549116/ProjectGearDeburr/solidworks/solidworks/koopdelen/HalfLazySusan.SLDPRT

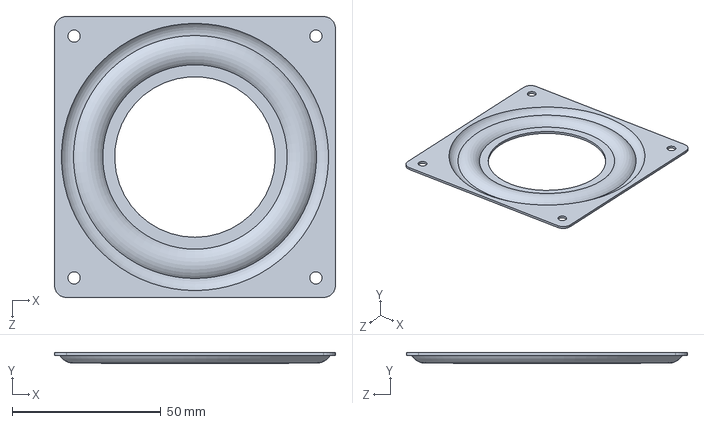
[picture p135: CAD file, 2025-11-12]
solidworks/solidworks/koopdelen/HalfLazySusan.SLDPRT
94.5 x 3.57 x 94.5 mm
