549116/ProjectGearDeburr/solidworks/solidworks/koopdelen/Motor 12v/housing.SLDPRT

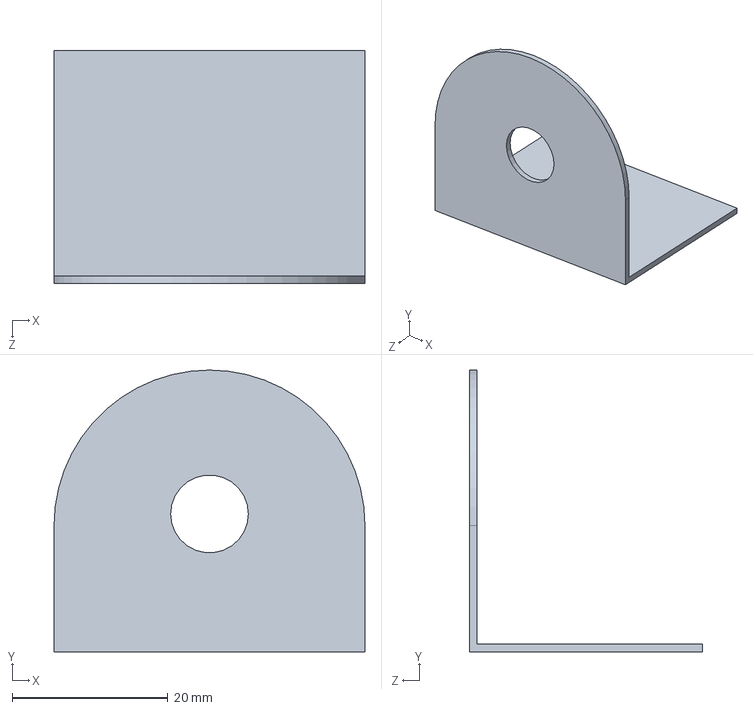
[picture p136: CAD file, 2025-11-12]
solidworks/solidworks/koopdelen/Motor 12v/housing.SLDPRT
40.0 x 36.2 x 30.0 mm
