549116/ProjectGearDeburr/solidworks/solidworks/lasersnijden lading 1/Flat pattern - houderhelft conuszuiger rechts.DXF

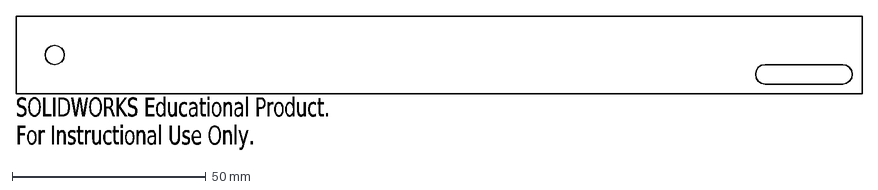
[picture p137: CAD file, 2026-01-20]
solidworks/solidworks/lasersnijden lading 1/Flat pattern - houderhelft conuszuiger rechts.DXF
SOLIDWORKS Educational Product.
For Instructional Use Only.
