549116/ProjectGearDeburr/solidworks/solidworks/koopdelen/Motor 12v/Case 1.SLDPRT

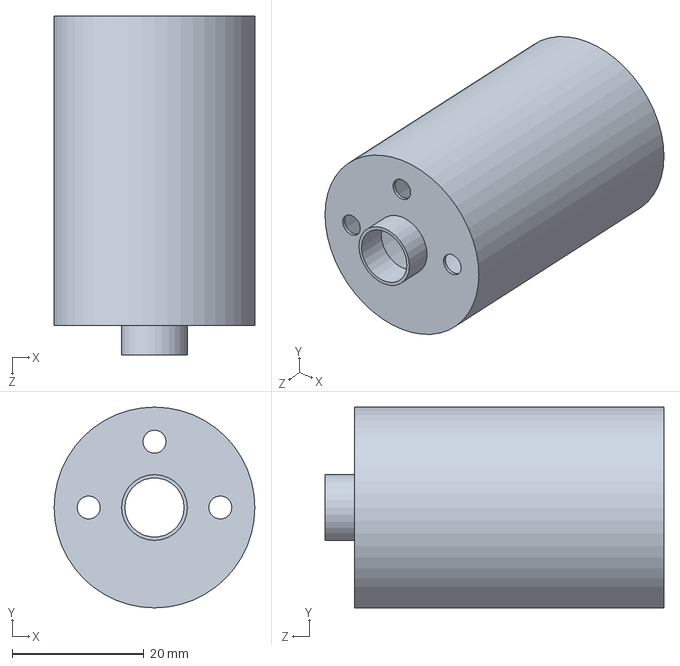
[picture p138: CAD file, 2025-11-12]
solidworks/solidworks/koopdelen/Motor 12v/Case 1.SLDPRT
30.5 x 30.5 x 51.5 mm
