549116/ProjectGearDeburr/solidworks/solidworks/koopdelen/Poulie GT2_20T.SLDPRT

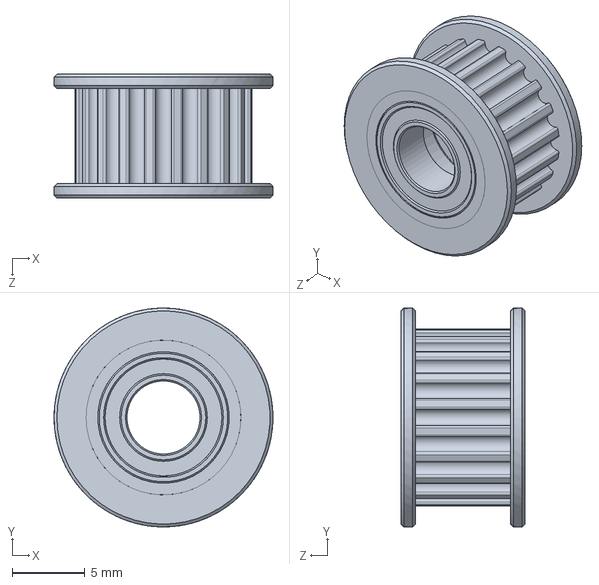
[picture p139: CAD file, 2025-11-12]
solidworks/solidworks/koopdelen/Poulie GT2_20T.SLDPRT
15.0 x 15.0 x 8.50 mm
