549116/ProjectGearDeburr/solidworks/solidworks/lasersnijden lading 1/Flat pattern - steun motor geleiding.DXF

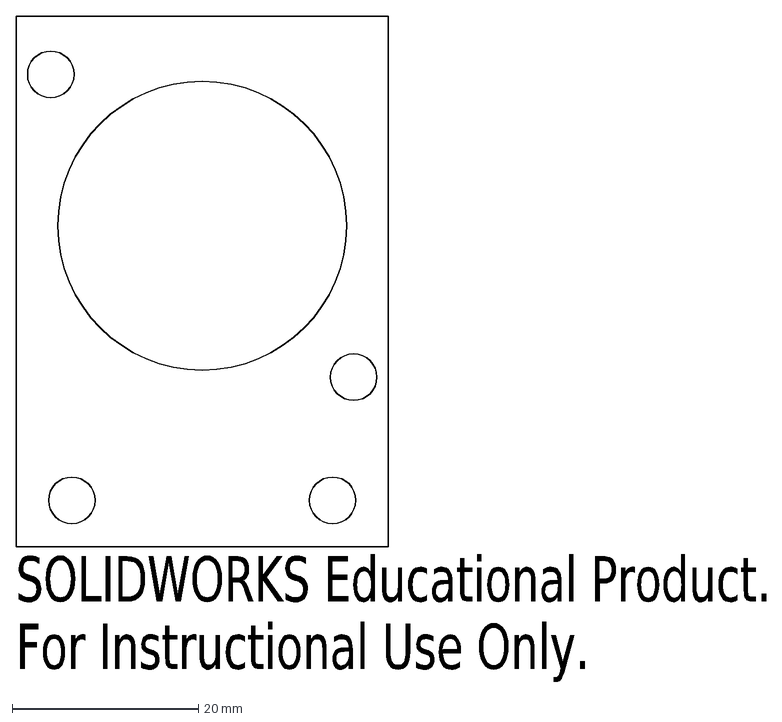
[picture p140: CAD file, 2026-01-20]
solidworks/solidworks/lasersnijden lading 1/Flat pattern - steun motor geleiding.DXF
SOLIDWORKS Educational Product.
For Instructional Use Only.
