549116/ProjectGearDeburr/solidworks/solidworks/hoekje consuszuiger.SLDPRT

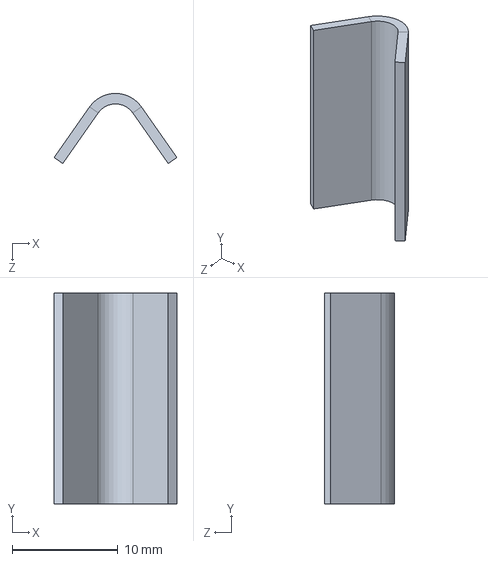
[picture p141: CAD file, 2026-01-20]
solidworks/solidworks/hoekje consuszuiger.SLDPRT
11.6 x 20.0 x 6.64 mm
