549116/ProjectGearDeburr/solidworks/solidworks/koopdelen/Motor 12v/Case 2.SLDPRT

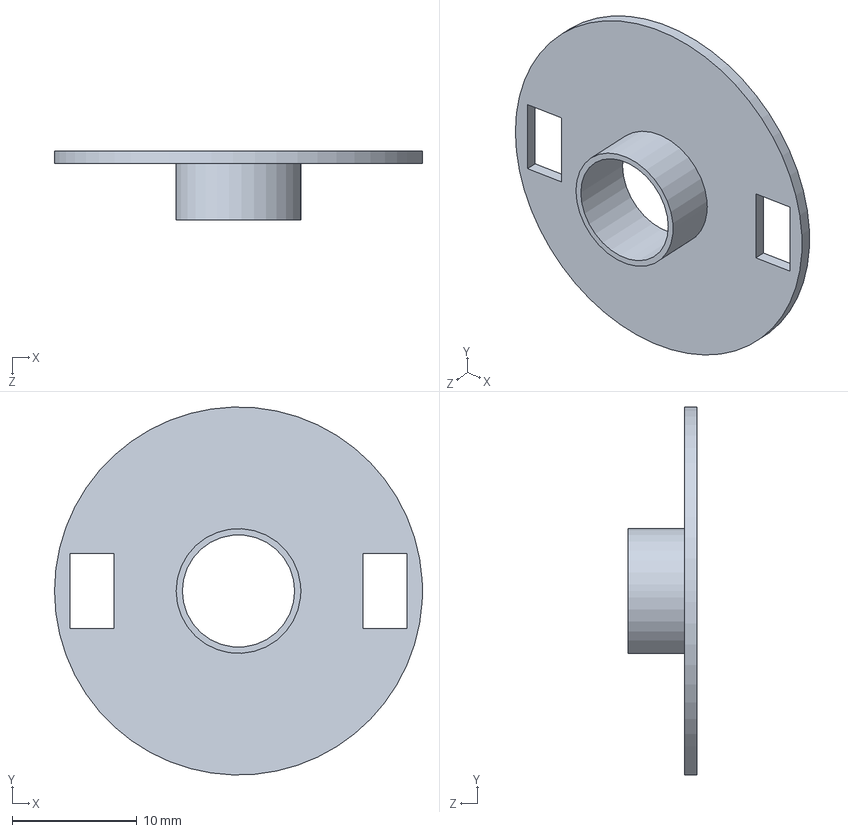
[picture p142: CAD file, 2025-11-12]
solidworks/solidworks/koopdelen/Motor 12v/Case 2.SLDPRT
29.5 x 29.5 x 5.50 mm
