549116/ProjectGearDeburr/solidworks/solidworks/lasersnijden lading 1/driehoek.DXF

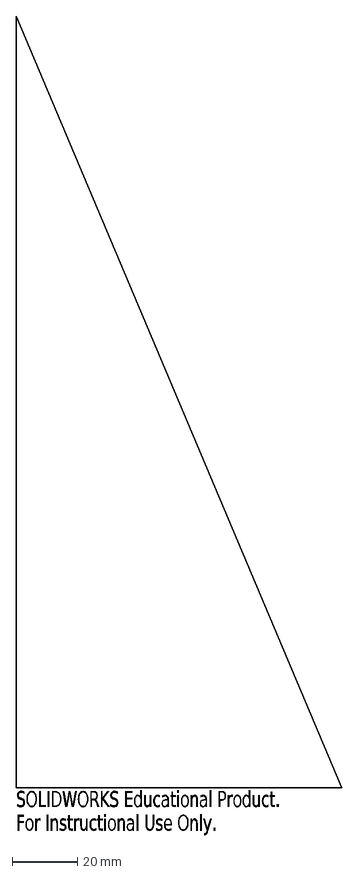
[picture p143: CAD file, 2026-01-20]
solidworks/solidworks/lasersnijden lading 1/driehoek.DXF
SOLIDWORKS Educational Product.
For Instructional Use Only.
