549116/ProjectGearDeburr/solidworks/solidworks/koopdelen/Motor 12v/Shaft Holder.SLDPRT

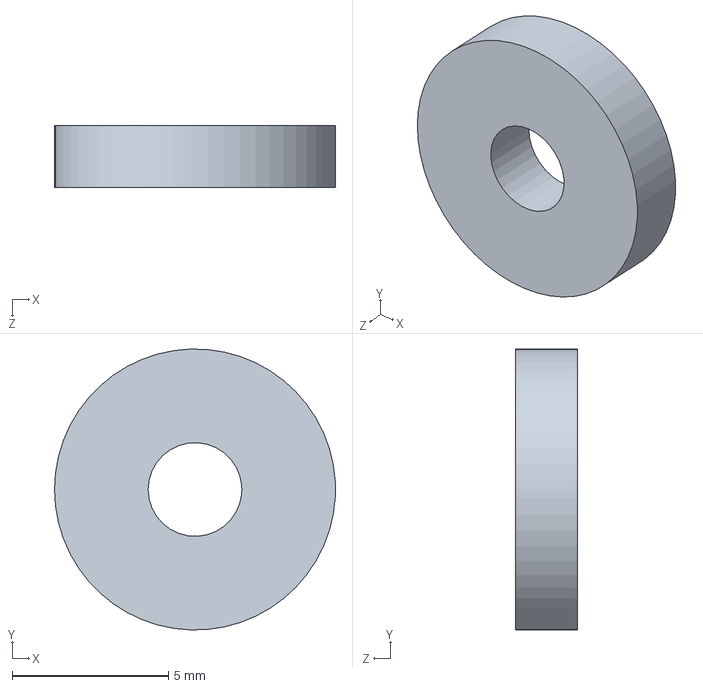
[picture p144: CAD file, 2025-11-12]
solidworks/solidworks/koopdelen/Motor 12v/Shaft Holder.SLDPRT
9.00 x 9.00 x 2.00 mm
