549116/ProjectGearDeburr/solidworks/solidworks/lasersnijden lading 1/Flat pattern - motorbeugel maxon.DXF

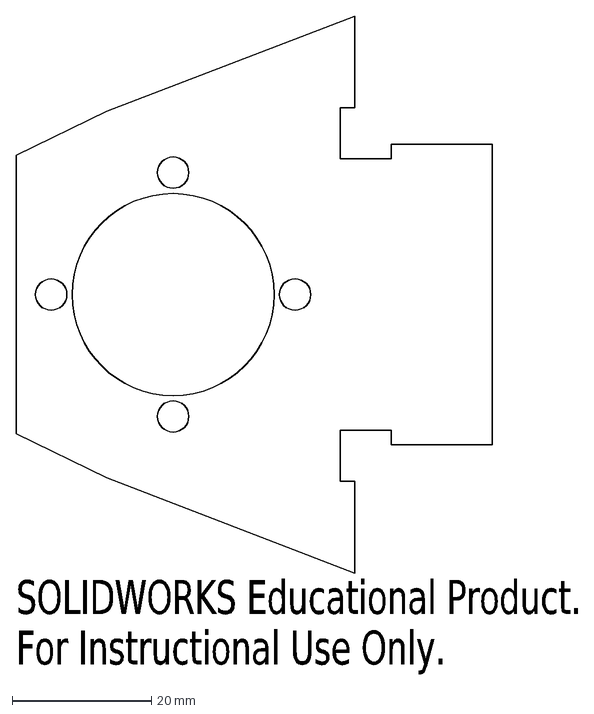
[picture p145: CAD file, 2026-01-20]
solidworks/solidworks/lasersnijden lading 1/Flat pattern - motorbeugel maxon.DXF
SOLIDWORKS Educational Product.
For Instructional Use Only.
