549116/ProjectGearDeburr/solidworks/solidworks/koopdelen/Motor 12v/Rotor.SLDPRT

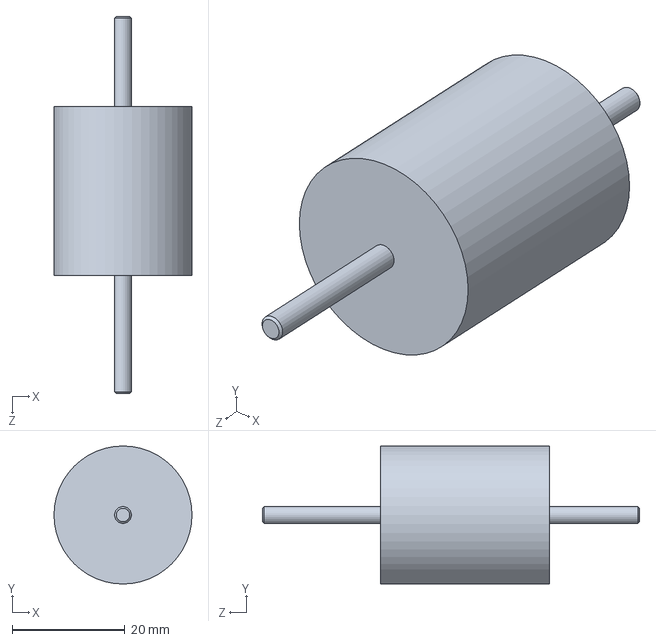
[picture p146: CAD file, 2025-11-12]
solidworks/solidworks/koopdelen/Motor 12v/Rotor.SLDPRT
24.5 x 24.5 x 67.0 mm
