549116/ProjectGearDeburr/solidworks/solidworks/koopdelen/Poulie 2GT6 20dts.STEP

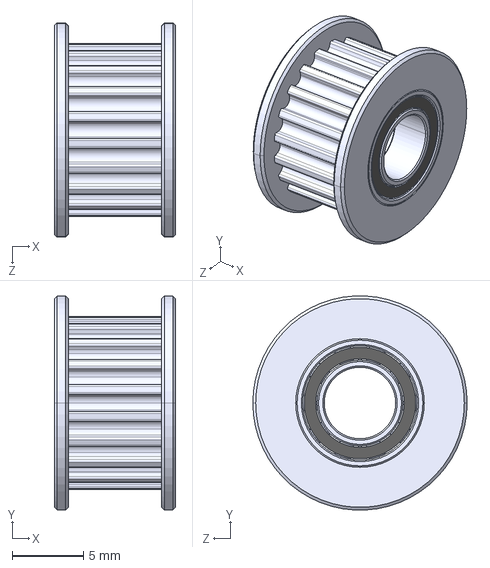
[picture p147: CAD file, 2025-11-12]
solidworks/solidworks/koopdelen/Poulie 2GT6 20dts.STEP
8.50 x 15.0 x 15.0 mm
