549116/ProjectGearDeburr/solidworks/solidworks/lasersnijden lading 1/tandwiel 170 tands modul 1 gat 10mm.DXF

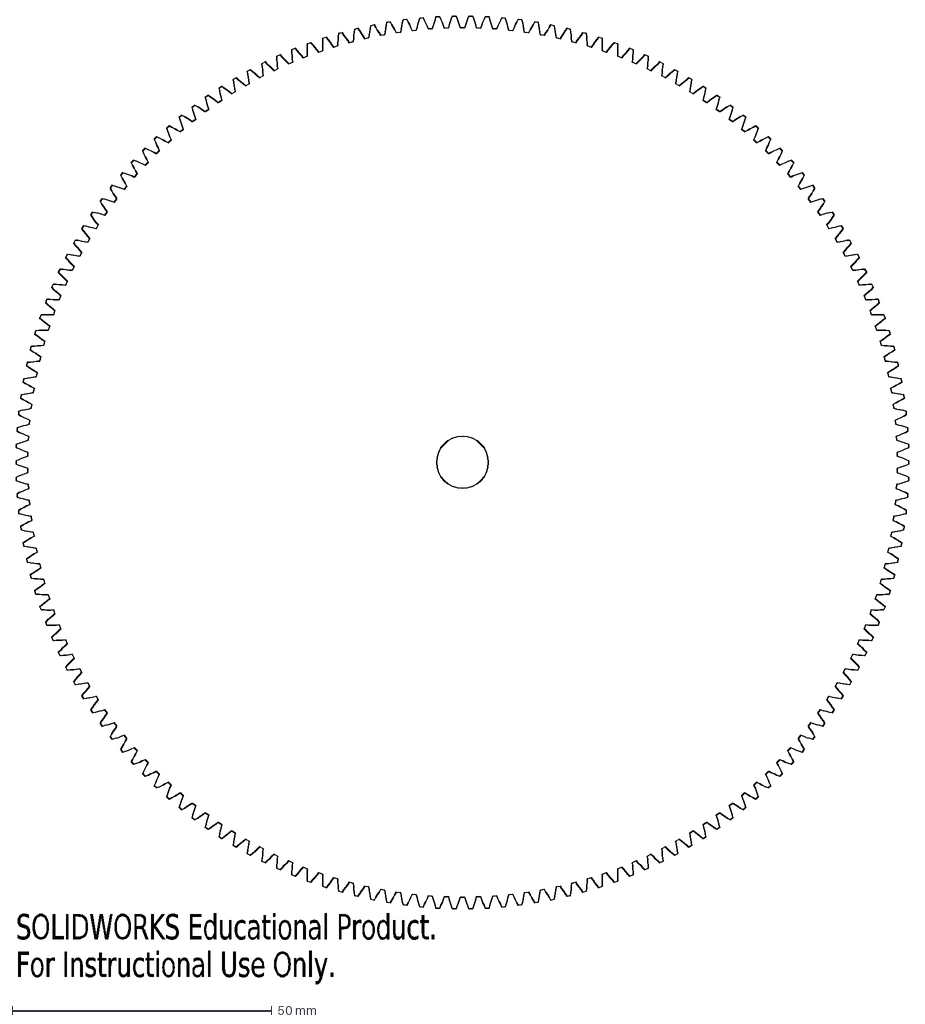
[picture p148: CAD file, 2026-01-20]
solidworks/solidworks/lasersnijden lading 1/tandwiel 170 tands modul 1 gat 10mm.DXF
SOLIDWORKS Educational Product.
For Instructional Use Only.
