549116/ProjectGearDeburr/solidworks/solidworks/uitvulblok.SLDPRT

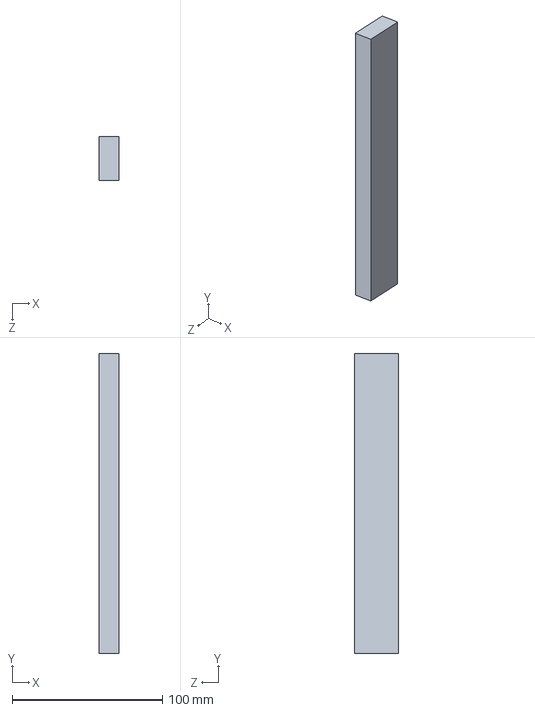
[picture p149: CAD file, 2026-01-20]
solidworks/solidworks/uitvulblok.SLDPRT
13.0 x 200.0 x 29.0 mm
