549116/ProjectGearDeburr/solidworks/solidworks/lasersnijden lading 1/plateau goed.DXF

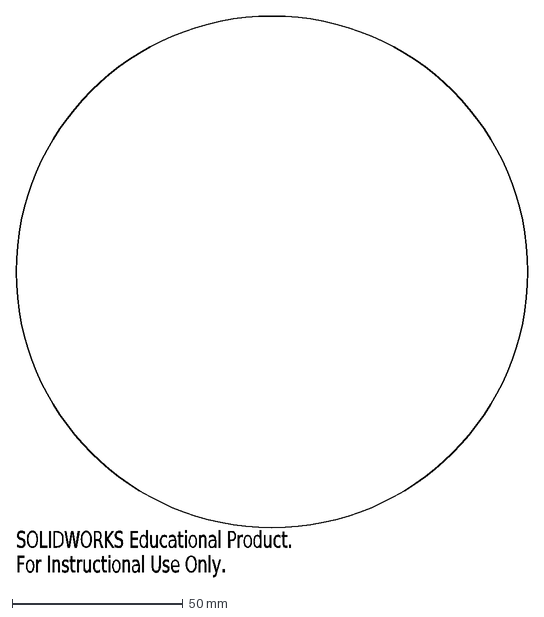
[picture p150: CAD file, 2026-01-20]
solidworks/solidworks/lasersnijden lading 1/plateau goed.DXF
SOLIDWORKS Educational Product.
For Instructional Use Only.
