549116/ProjectGearDeburr/solidworks/solidworks/koopdelen/Motor 12v/Connect.SLDPRT

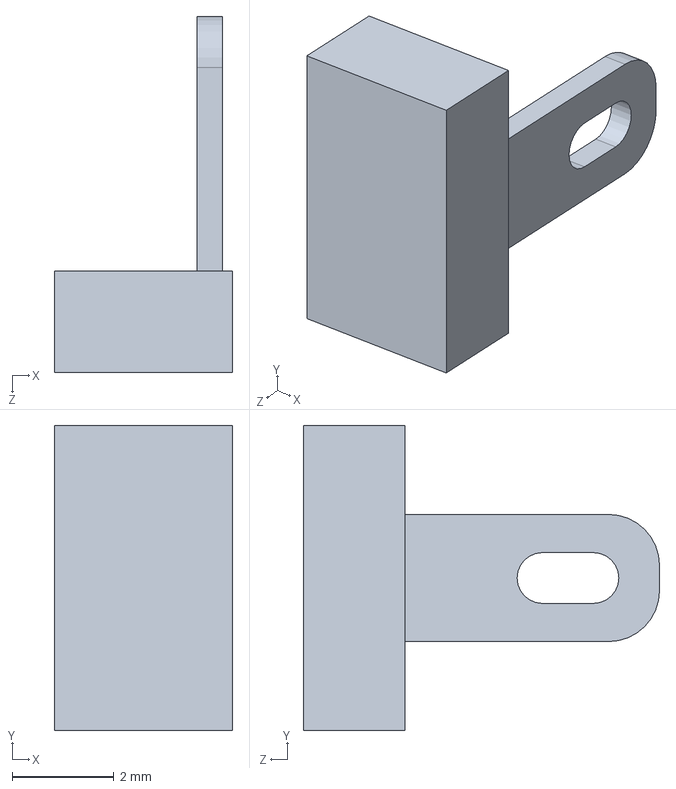
[picture p151: CAD file, 2025-11-12]
solidworks/solidworks/koopdelen/Motor 12v/Connect.SLDPRT
3.50 x 6.00 x 7.00 mm
