549116/ProjectGearDeburr/solidworks/solidworks/lasersnijden lading 1/Flat pattern - zetdeel op geleiding.DXF

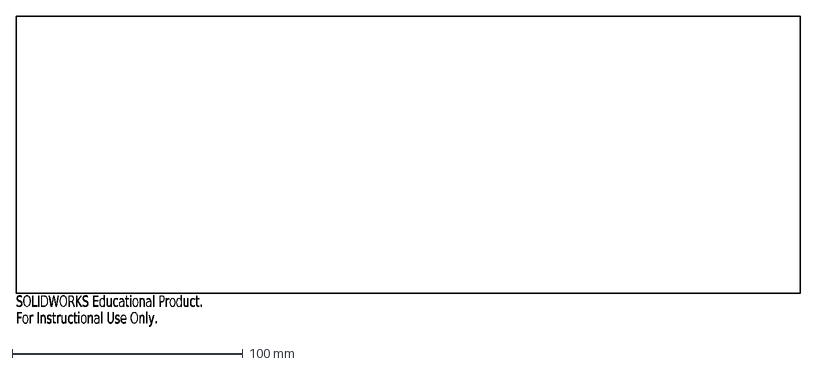
[picture p152: CAD file, 2026-01-20]
solidworks/solidworks/lasersnijden lading 1/Flat pattern - zetdeel op geleiding.DXF
SOLIDWORKS Educational Product.
For Instructional Use Only.
