549116/ProjectGearDeburr/solidworks/solidworks/koopdelen/Motor 12v/B().SLDPRT

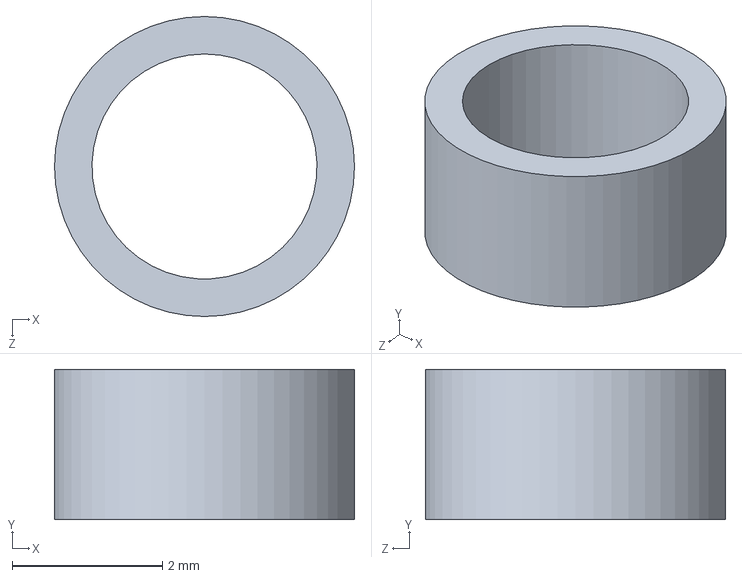
[picture p153: CAD file, 2025-11-12]
solidworks/solidworks/koopdelen/Motor 12v/B().SLDPRT
4.00 x 2.00 x 4.00 mm
