549116/ProjectGearDeburr/solidworks/solidworks/lasersnijden lading 1/Flat pattern - houderhelft conuszuiger links.DXF

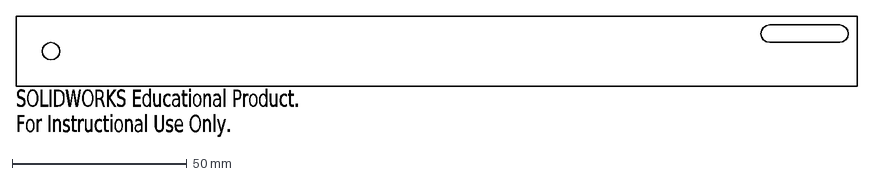
[picture p154: CAD file, 2026-01-20]
solidworks/solidworks/lasersnijden lading 1/Flat pattern - houderhelft conuszuiger links.DXF
SOLIDWORKS Educational Product.
For Instructional Use Only.
