549116/ProjectGearDeburr/solidworks/solidworks/koopdelen/Motor 12v/Case 3.SLDPRT

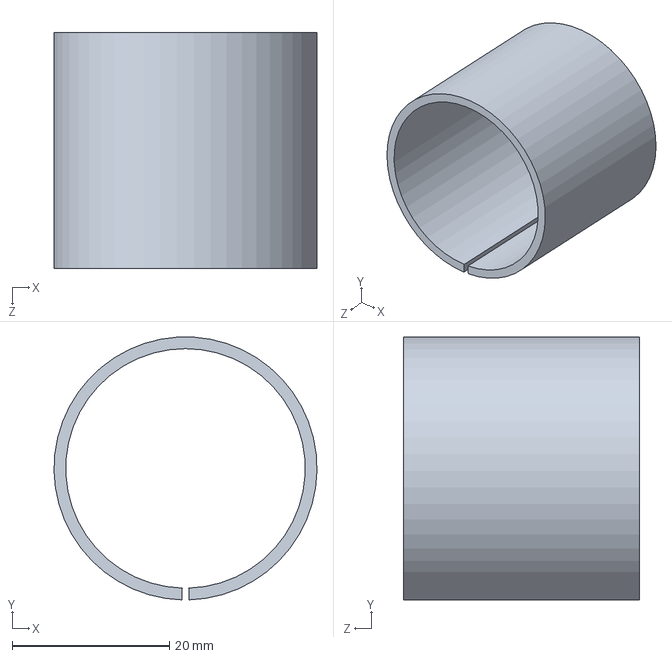
[picture p155: CAD file, 2025-11-12]
solidworks/solidworks/koopdelen/Motor 12v/Case 3.SLDPRT
33.5 x 33.5 x 30.0 mm
