549116/ProjectGearDeburr/solidworks/solidworks/lasersnijden lading 1/oor.DXF

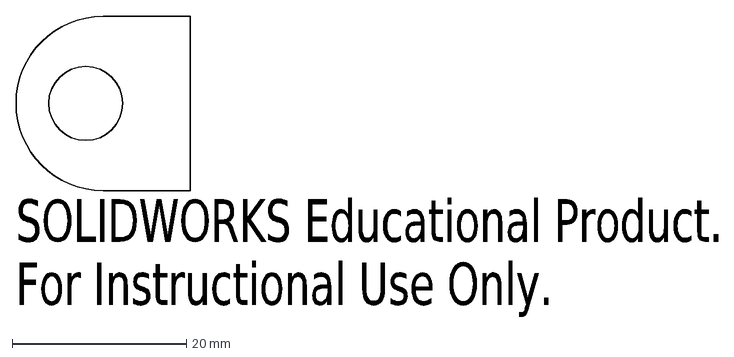
[picture p156: CAD file, 2026-01-20]
solidworks/solidworks/lasersnijden lading 1/oor.DXF
SOLIDWORKS Educational Product.
For Instructional Use Only.
