549116/ProjectGearDeburr/solidworks/solidworks/tandwiel 170 tands modul 1 gat 10mm.SLDPRT

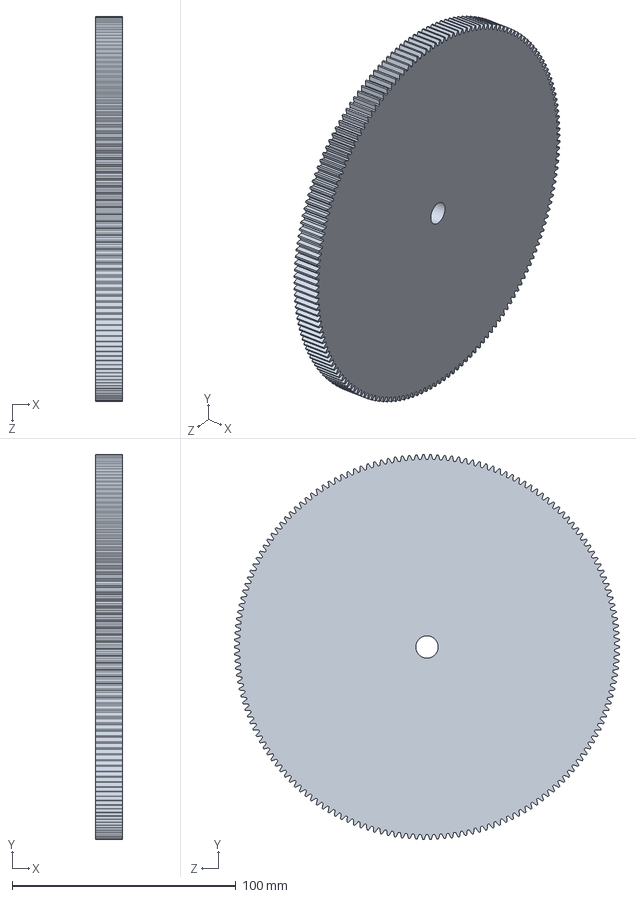
[picture p157: CAD file, 2026-01-20]
solidworks/solidworks/tandwiel 170 tands modul 1 gat 10mm.SLDPRT
12.0 x 172.0 x 172.0 mm
