549116/ProjectGearDeburr/solidworks/solidworks/koopdelen/Motor 12v/Magnet.SLDPRT

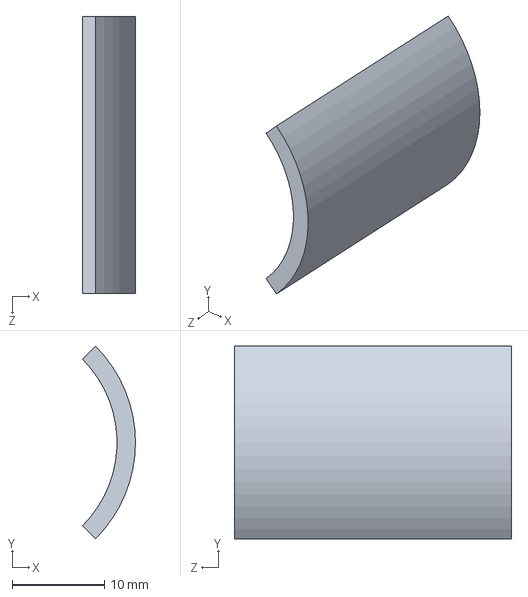
[picture p158: CAD file, 2025-11-12]
solidworks/solidworks/koopdelen/Motor 12v/Magnet.SLDPRT
5.73 x 20.9 x 30.0 mm
