549116/ProjectGearDeburr/solidworks/solidworks/lasersnijden lading 1/voorwand.DXF

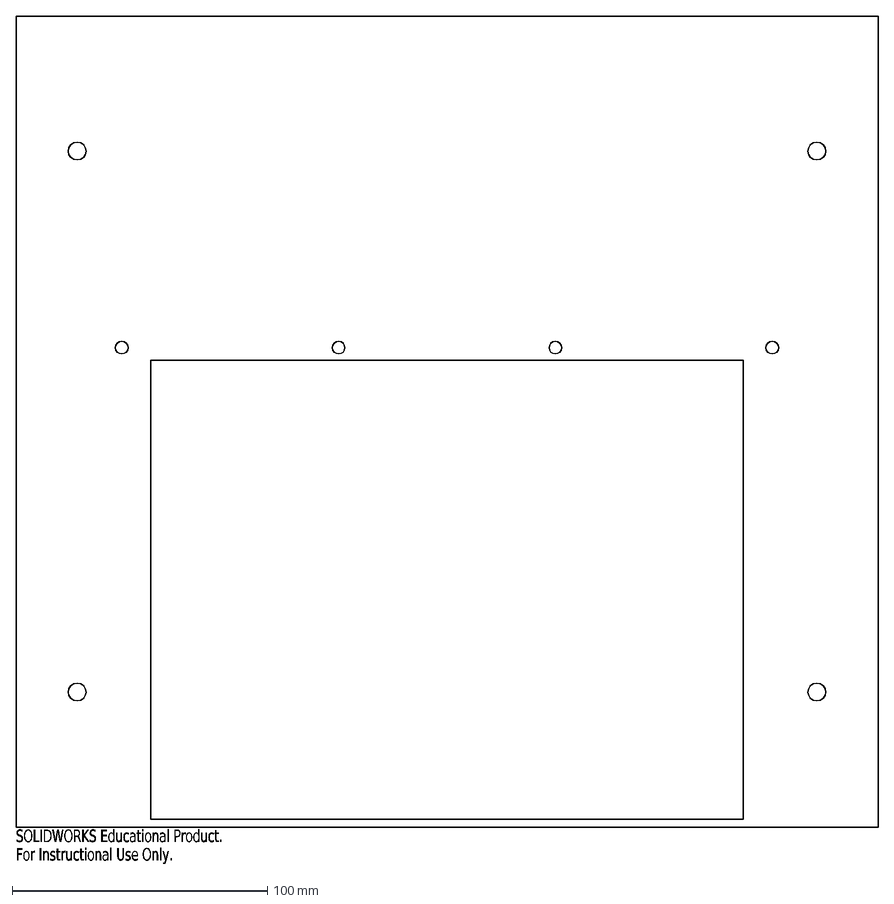
[picture p159: CAD file, 2026-01-20]
solidworks/solidworks/lasersnijden lading 1/voorwand.DXF
SOLIDWORKS Educational Product.
For Instructional Use Only.
