549116/ProjectGearDeburr/solidworks/PACK AND GO (totale assembly heet hoofdassembly)/Guide Rail zelf.SLDPRT

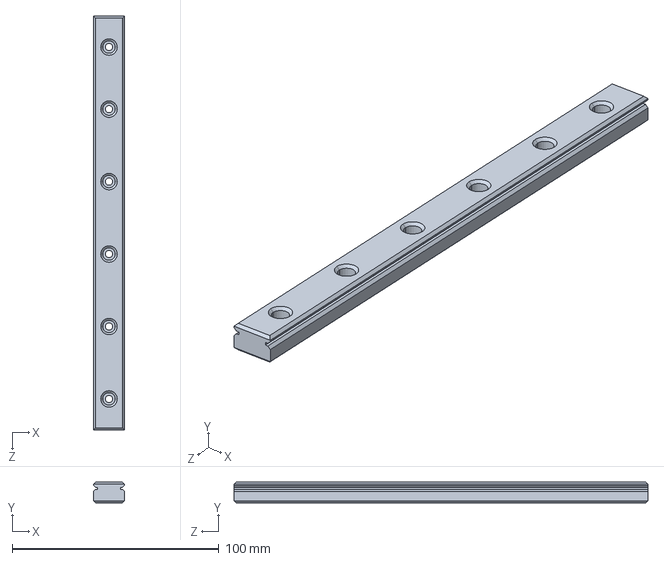
[picture p160: CAD file, 2026-01-20]
solidworks/PACK AND GO (totale assembly heet hoofdassembly)/Guide Rail zelf.SLDPRT
15.0 x 10.0 x 200.0 mm
