549116/ProjectGearDeburr/solidworks/solidworks/buitengeleider conus.SLDPRT

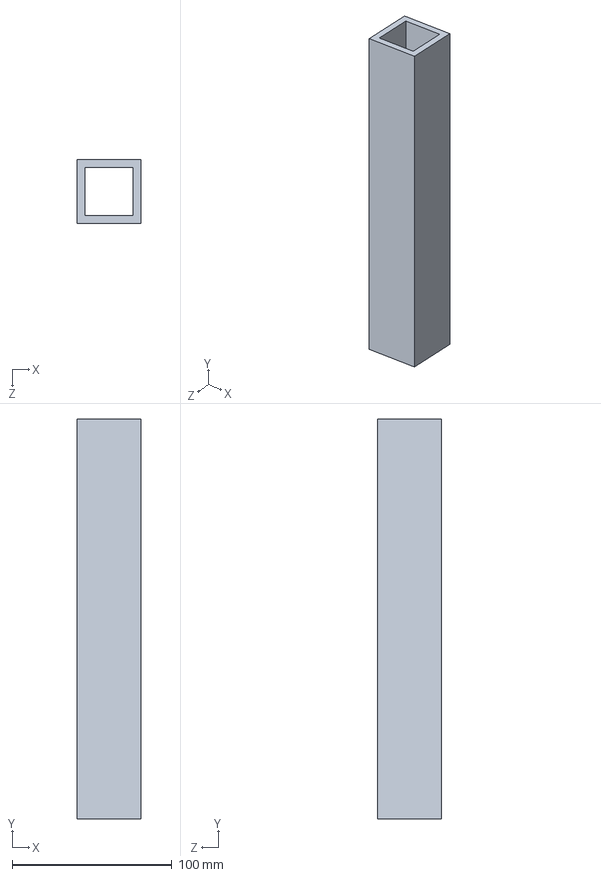
[picture p161: CAD file, 2025-11-12]
solidworks/solidworks/buitengeleider conus.SLDPRT
40.0 x 250.0 x 40.0 mm
