549116/ProjectGearDeburr/solidworks/PACK AND GO (totale assembly heet hoofdassembly)/beugel lamellen.SLDPRT

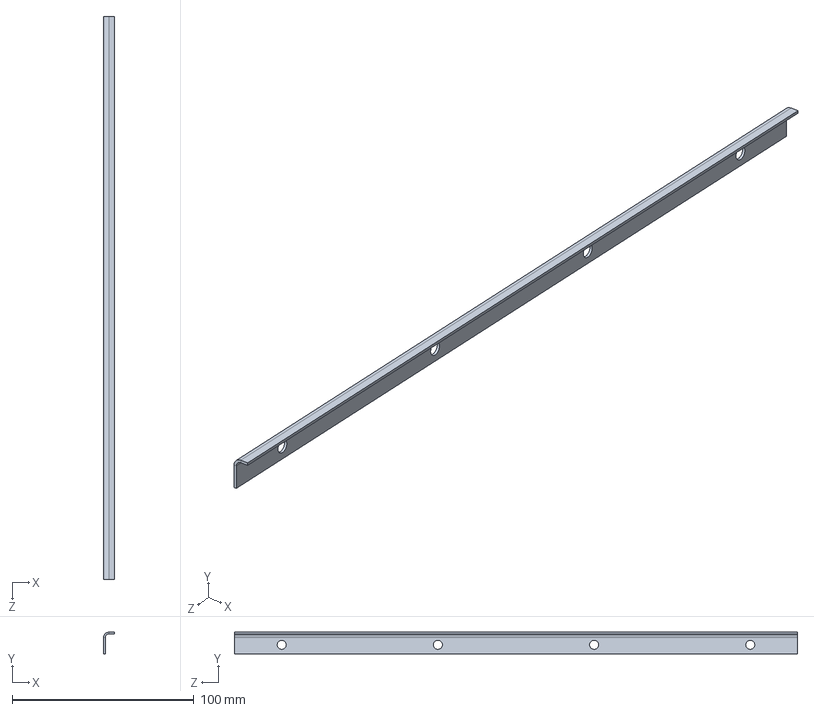
[picture p162: CAD file, 2026-01-20]
solidworks/PACK AND GO (totale assembly heet hoofdassembly)/beugel lamellen.SLDPRT
6.00 x 12.0 x 310.0 mm
