549116/ProjectGearDeburr/solidworks/solidworks/binnengeleider conus.SLDPRT

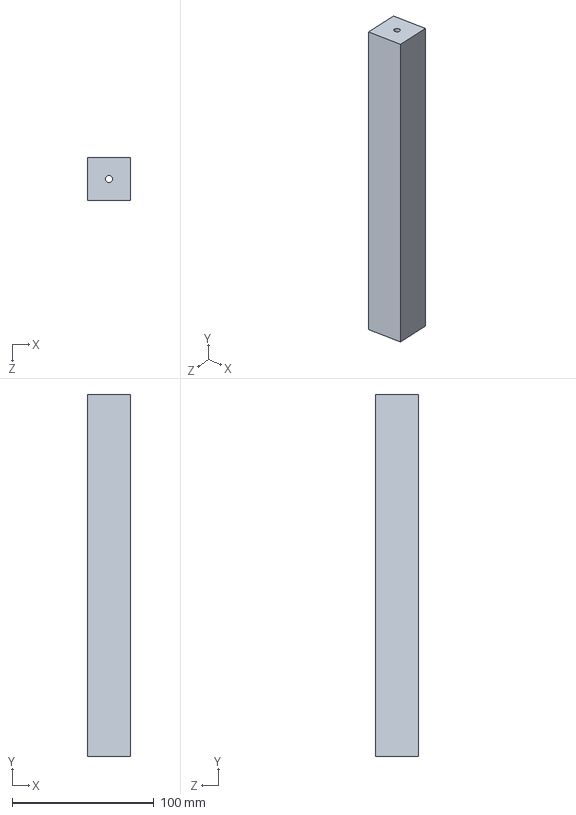
[picture p163: CAD file, 2025-11-12]
solidworks/solidworks/binnengeleider conus.SLDPRT
30.0 x 255.0 x 30.0 mm
