549116/ProjectGearDeburr/solidworks/PACK AND GO (totale assembly heet hoofdassembly)/steun motor geleiding.SLDPRT

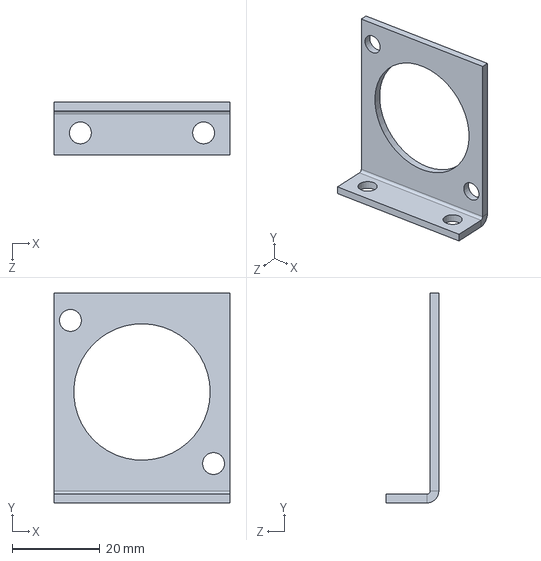
[picture p164: CAD file, 2026-01-20]
solidworks/PACK AND GO (totale assembly heet hoofdassembly)/steun motor geleiding.SLDPRT
40.0 x 47.7 x 12.0 mm
