549116/ProjectGearDeburr/solidworks/solidworks/adapter lazy susan naar frame.SLDPRT

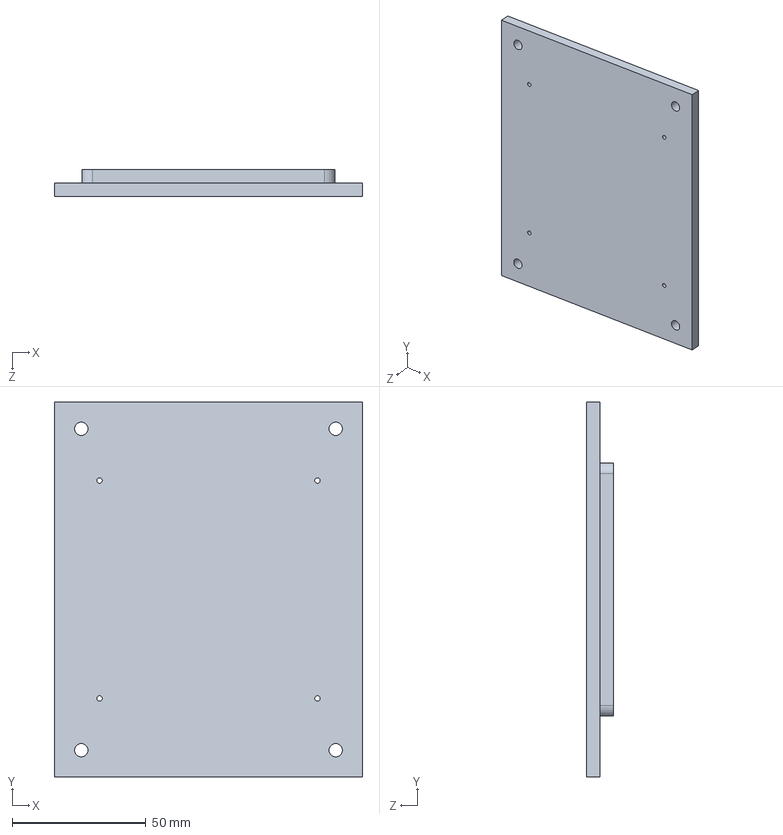
[picture p165: CAD file, 2025-11-12]
solidworks/solidworks/adapter lazy susan naar frame.SLDPRT
115.0 x 140.0 x 10.0 mm
