549116/ProjectGearDeburr/solidworks/PACK AND GO (totale assembly heet hoofdassembly)/ps_49x124x124.stp

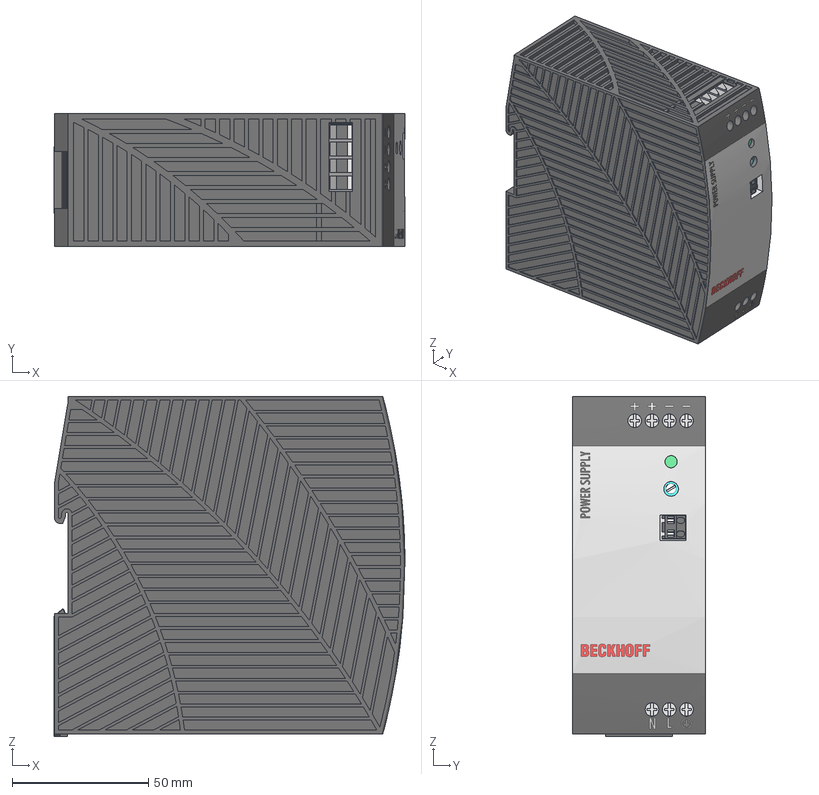
[picture p166: CAD file, 2026-01-20]
solidworks/PACK AND GO (totale assembly heet hoofdassembly)/ps_49x124x124.stp
129.0 x 49.0 x 125.0 mm
