549116/ProjectGearDeburr/solidworks/solidworks/conus groot.SLDPRT

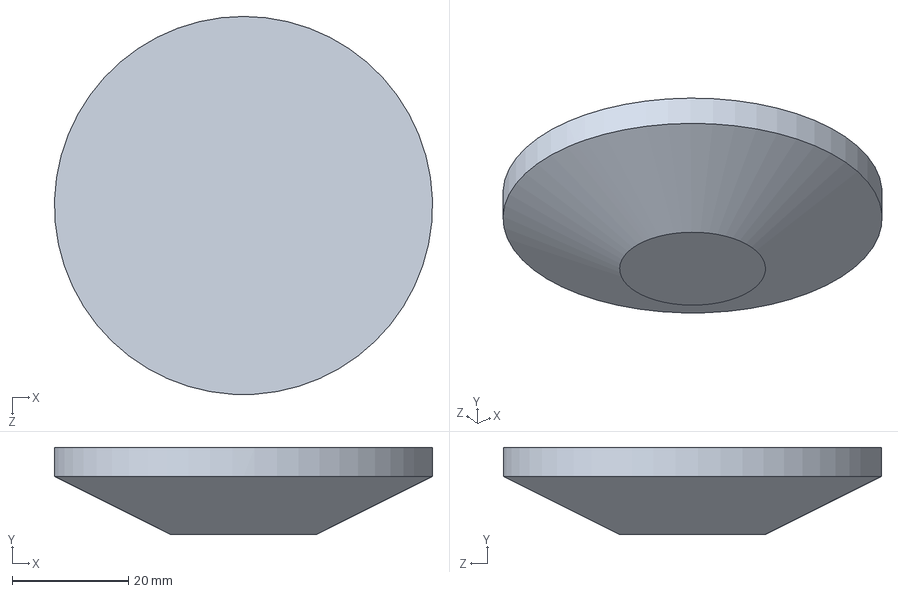
[picture p167: CAD file, 2025-11-12]
solidworks/solidworks/conus groot.SLDPRT
65.0 x 15.0 x 65.0 mm
