549116/ProjectGearDeburr/solidworks/PACK AND GO (totale assembly heet hoofdassembly)/plafond.SLDPRT

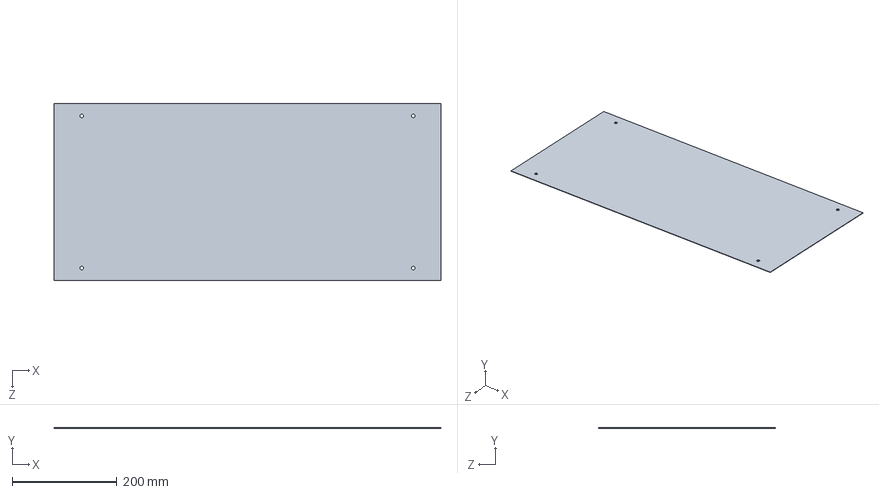
[picture p168: CAD file, 2026-01-20]
solidworks/PACK AND GO (totale assembly heet hoofdassembly)/plafond.SLDPRT
738.0 x 1.00 x 338.0 mm
