549116/ProjectGearDeburr/solidworks/PACK AND GO (totale assembly heet hoofdassembly)/afschermkap.SLDPRT

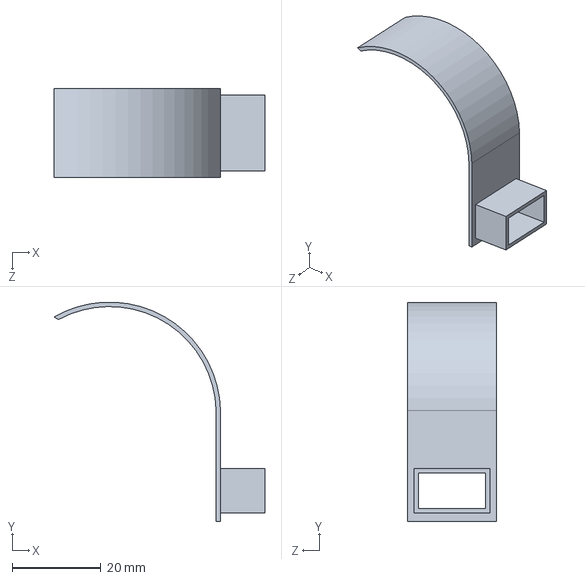
[picture p169: CAD file, 2026-01-20]
solidworks/PACK AND GO (totale assembly heet hoofdassembly)/afschermkap.SLDPRT
47.5 x 49.4 x 20.0 mm
