549116/ProjectGearDeburr/solidworks/PACK AND GO (totale assembly heet hoofdassembly)/cilinderhouder bewegend.SLDPRT

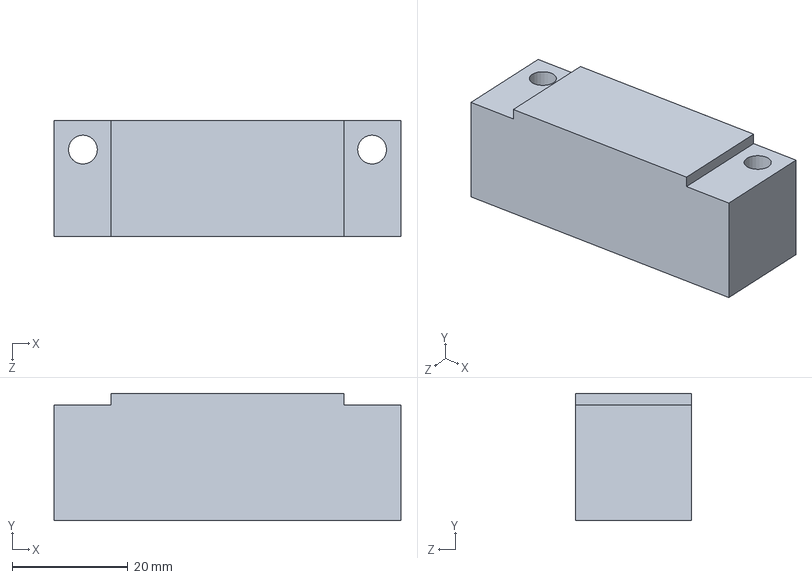
[picture p170: CAD file, 2026-01-20]
solidworks/PACK AND GO (totale assembly heet hoofdassembly)/cilinderhouder bewegend.SLDPRT
60.0 x 22.0 x 20.0 mm
