549116/ProjectGearDeburr/solidworks/PACK AND GO (totale assembly heet hoofdassembly)/cilinder bewegend.SLDPRT

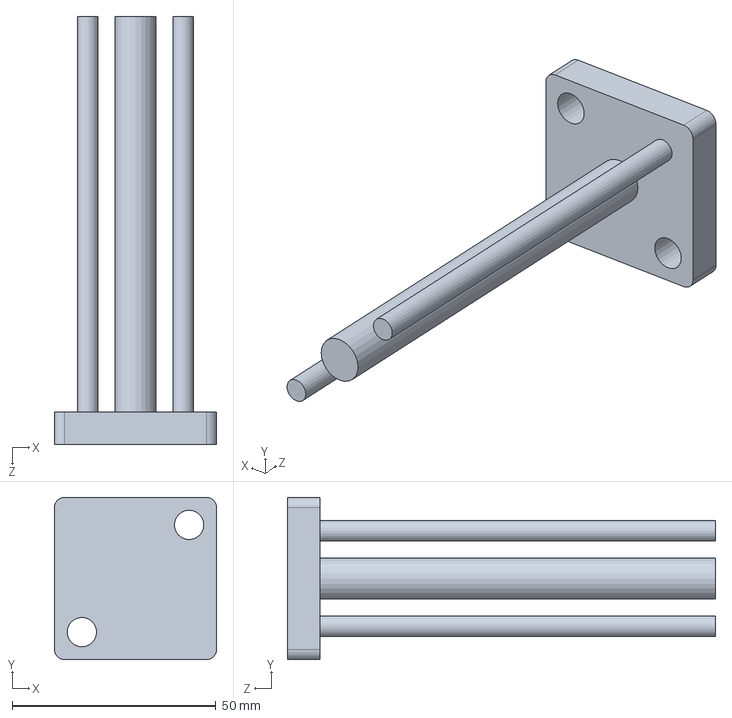
[picture p171: CAD file, 2026-01-20]
solidworks/PACK AND GO (totale assembly heet hoofdassembly)/cilinder bewegend.SLDPRT
39.8 x 39.8 x 105.0 mm
