549116/ProjectGearDeburr/solidworks/PACK AND GO (totale assembly heet hoofdassembly)/cilinder vast.SLDPRT

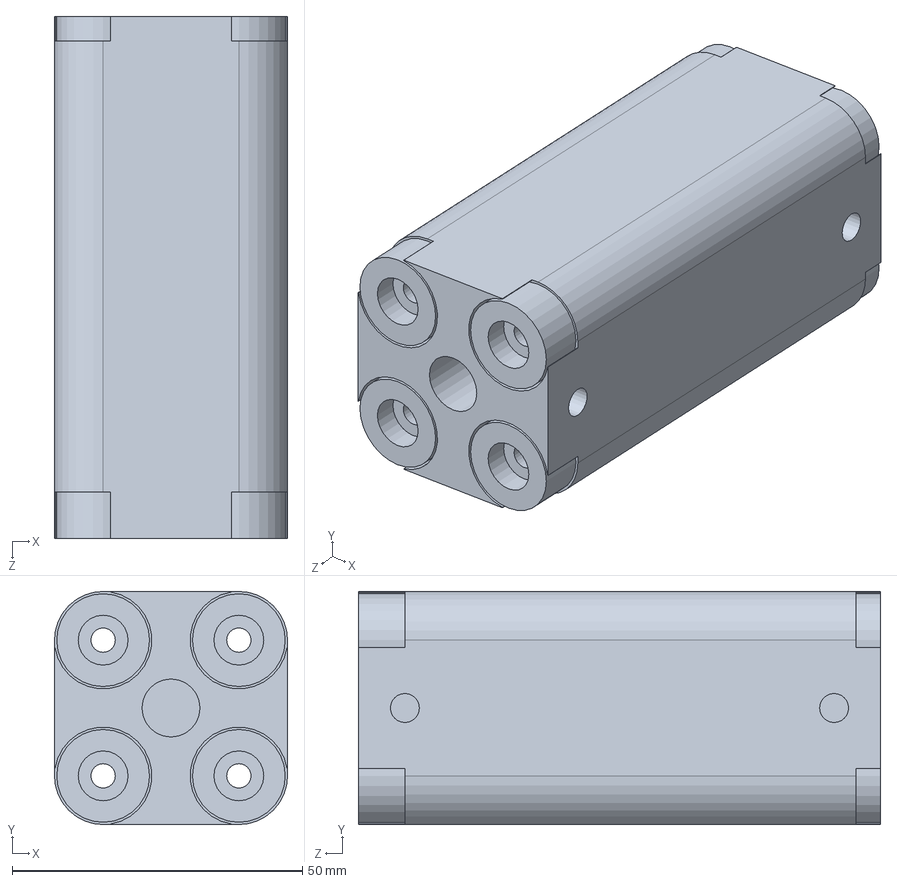
[picture p172: CAD file, 2026-01-20]
solidworks/PACK AND GO (totale assembly heet hoofdassembly)/cilinder vast.SLDPRT
40.2 x 40.2 x 90.0 mm
