549116/ProjectGearDeburr/solidworks/PACK AND GO (totale assembly heet hoofdassembly)/koker 20x20.SLDPRT

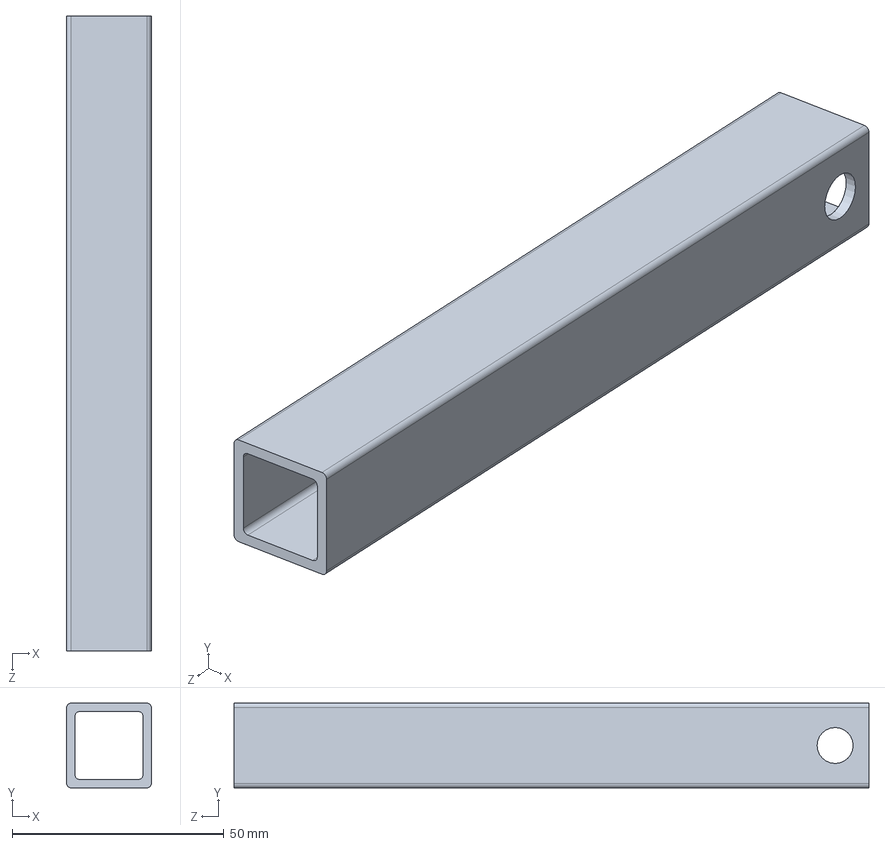
[picture p173: CAD file, 2026-01-20]
solidworks/PACK AND GO (totale assembly heet hoofdassembly)/koker 20x20.SLDPRT
20.0 x 20.0 x 150.0 mm
