549116/ProjectGearDeburr/solidworks/PACK AND GO (totale assembly heet hoofdassembly)/busje borstel motor.SLDPRT

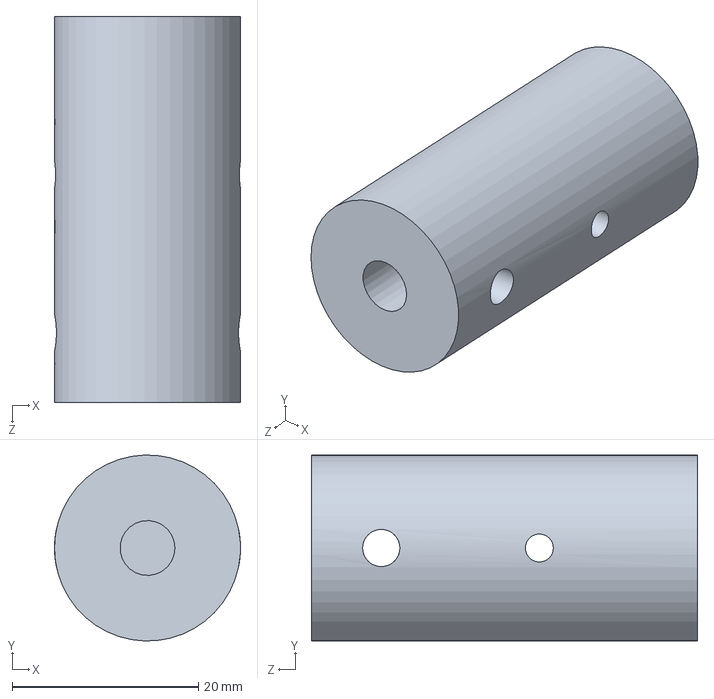
[picture p174: CAD file, 2026-01-20]
solidworks/PACK AND GO (totale assembly heet hoofdassembly)/busje borstel motor.SLDPRT
20.0 x 20.0 x 41.5 mm
