549116/ProjectGearDeburr/solidworks/PACK AND GO (totale assembly heet hoofdassembly)/flexkoppeling (schematisch).SLDPRT

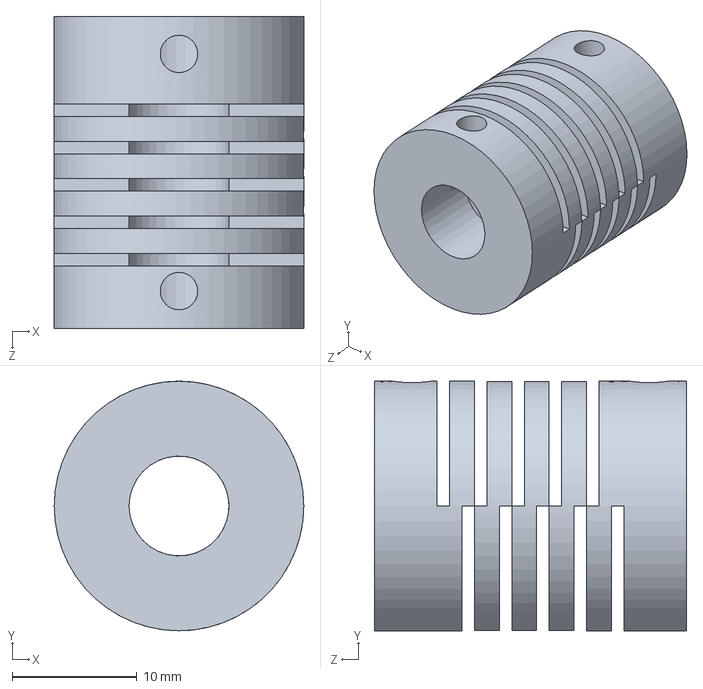
[picture p175: CAD file, 2026-01-20]
solidworks/PACK AND GO (totale assembly heet hoofdassembly)/flexkoppeling (schematisch).SLDPRT
20.0 x 20.0 x 25.0 mm
