549116/ProjectGearDeburr/solidworks/PACK AND GO (totale assembly heet hoofdassembly)/gearbox maxon.SLDPRT

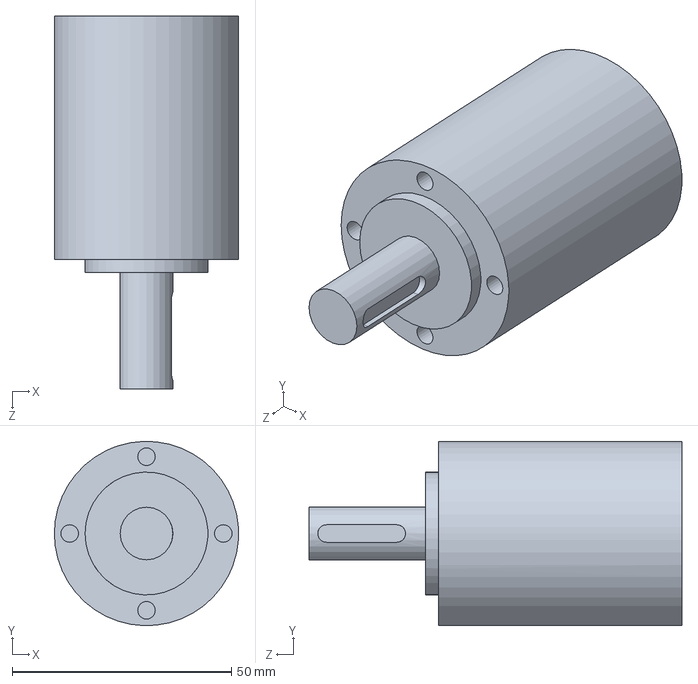
[picture p176: CAD file, 2026-01-20]
solidworks/PACK AND GO (totale assembly heet hoofdassembly)/gearbox maxon.SLDPRT
42.0 x 42.0 x 85.0 mm
