549116/ProjectGearDeburr/solidworks/PACK AND GO (totale assembly heet hoofdassembly)/plateau goed.SLDPRT

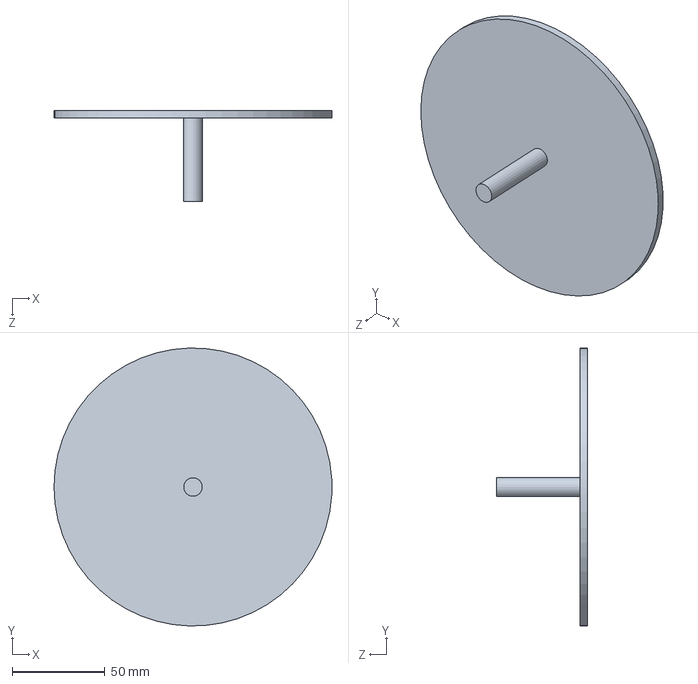
[picture p177: CAD file, 2026-01-20]
solidworks/PACK AND GO (totale assembly heet hoofdassembly)/plateau goed.SLDPRT
150.0 x 149.9 x 49.0 mm
