549116/ProjectGearDeburr/solidworks/PACK AND GO (totale assembly heet hoofdassembly)/achterwand.SLDPRT

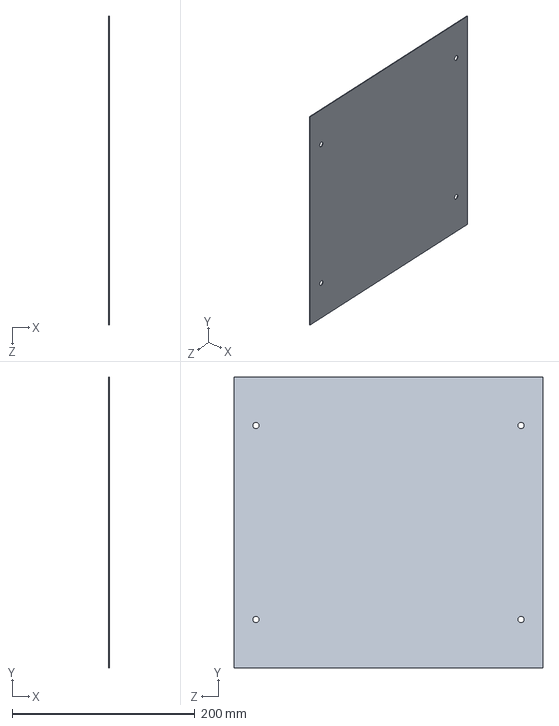
[picture p178: CAD file, 2026-01-20]
solidworks/PACK AND GO (totale assembly heet hoofdassembly)/achterwand.SLDPRT
1.00 x 318.0 x 338.0 mm
