549116/ProjectGearDeburr/solidworks/PACK AND GO (totale assembly heet hoofdassembly)/beugel afschermkap.SLDPRT

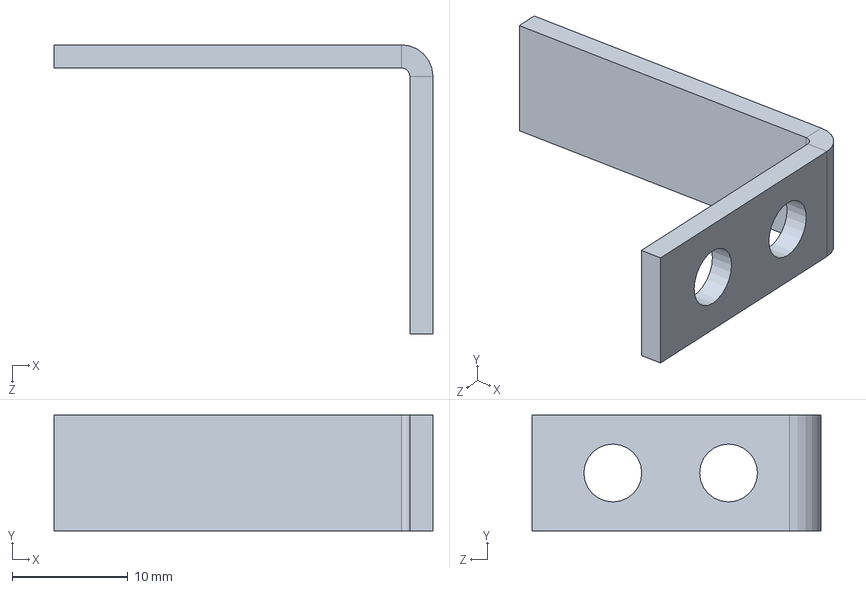
[picture p179: CAD file, 2026-01-20]
solidworks/PACK AND GO (totale assembly heet hoofdassembly)/beugel afschermkap.SLDPRT
32.7 x 10.0 x 25.0 mm
