549116/ProjectGearDeburr/solidworks/PACK AND GO (totale assembly heet hoofdassembly)/spacer between frame.SLDPRT

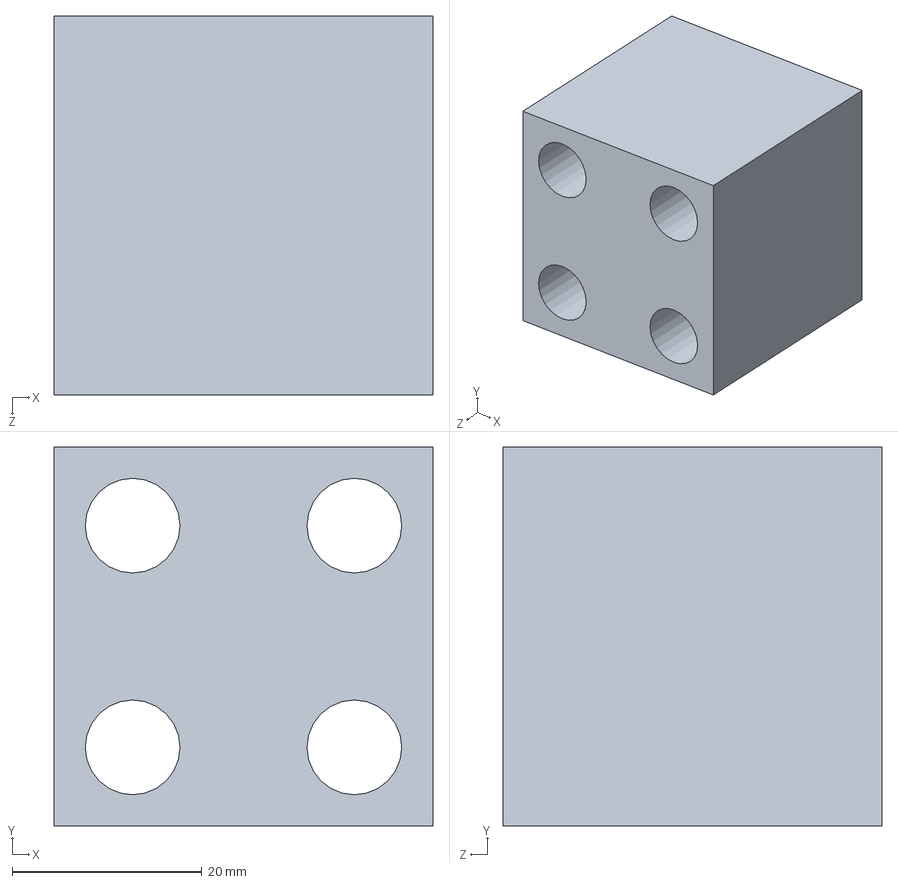
[picture p180: CAD file, 2026-01-20]
solidworks/PACK AND GO (totale assembly heet hoofdassembly)/spacer between frame.SLDPRT
40.0 x 40.0 x 40.0 mm
