549116/ProjectGearDeburr/solidworks/PACK AND GO (totale assembly heet hoofdassembly)/eigen 30x30 hoekje.SLDPRT

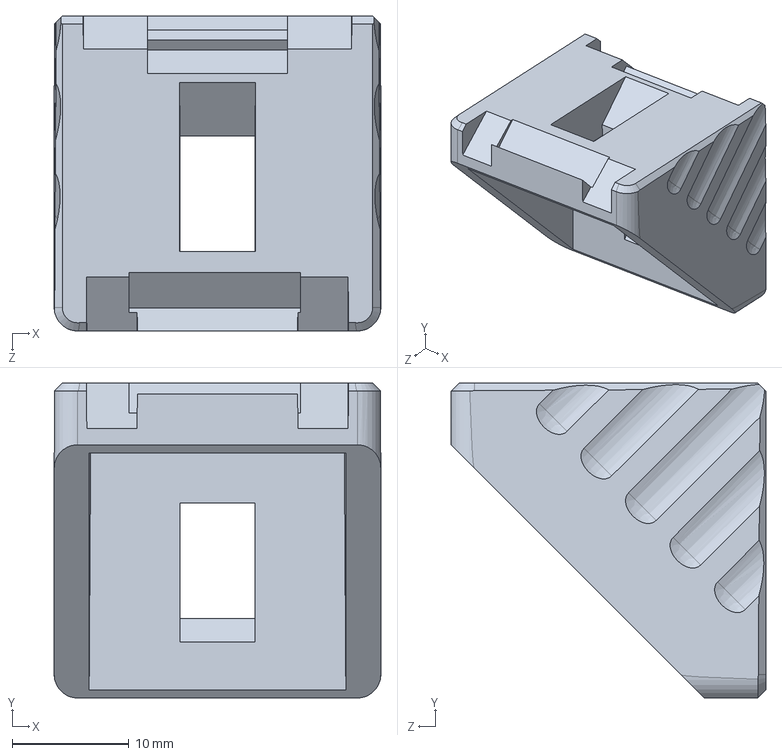
[picture p181: CAD file, 2026-01-20]
solidworks/PACK AND GO (totale assembly heet hoofdassembly)/eigen 30x30 hoekje.SLDPRT
28.0 x 27.0 x 27.0 mm
