549116/ProjectGearDeburr/solidworks/PACK AND GO (totale assembly heet hoofdassembly)/motorbeugel maxon.SLDPRT

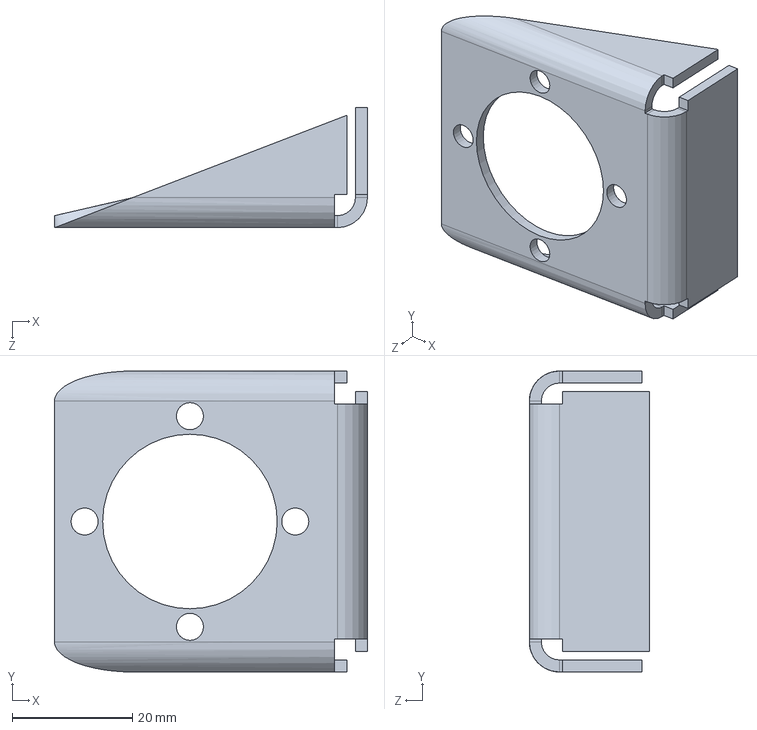
[picture p182: CAD file, 2026-01-20]
solidworks/PACK AND GO (totale assembly heet hoofdassembly)/motorbeugel maxon.SLDPRT
52.0 x 50.0 x 20.0 mm
