549116/ProjectGearDeburr/solidworks/PACK AND GO (totale assembly heet hoofdassembly)/zetdeel op geleiding.SLDPRT

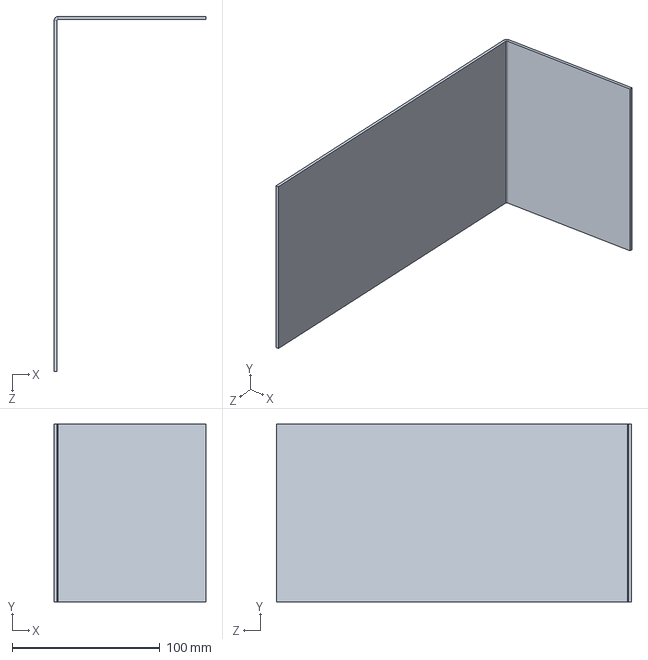
[picture p183: CAD file, 2026-01-20]
solidworks/PACK AND GO (totale assembly heet hoofdassembly)/zetdeel op geleiding.SLDPRT
102.7 x 120.0 x 240.0 mm
