549116/ProjectGearDeburr/solidworks/PACK AND GO (totale assembly heet hoofdassembly)/bevestiging klemcilinder en frame.SLDPRT

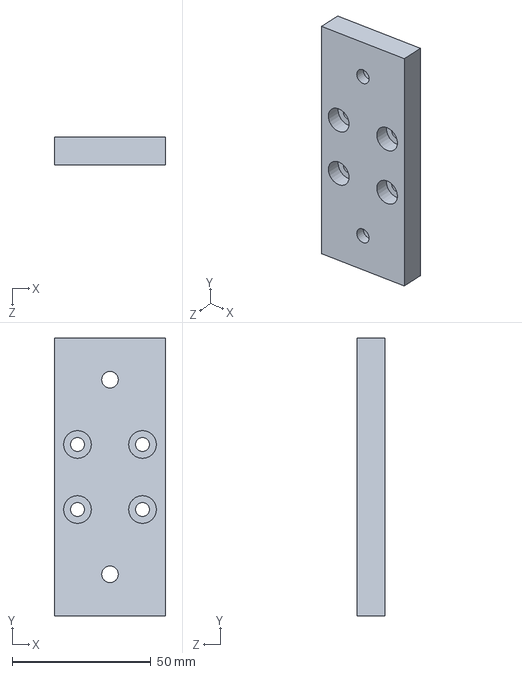
[picture p184: CAD file, 2026-01-20]
solidworks/PACK AND GO (totale assembly heet hoofdassembly)/bevestiging klemcilinder en frame.SLDPRT
40.0 x 100.0 x 10.0 mm
