549116/ProjectGearDeburr/solidworks/PACK AND GO (totale assembly heet hoofdassembly)/frame.SLDPRT

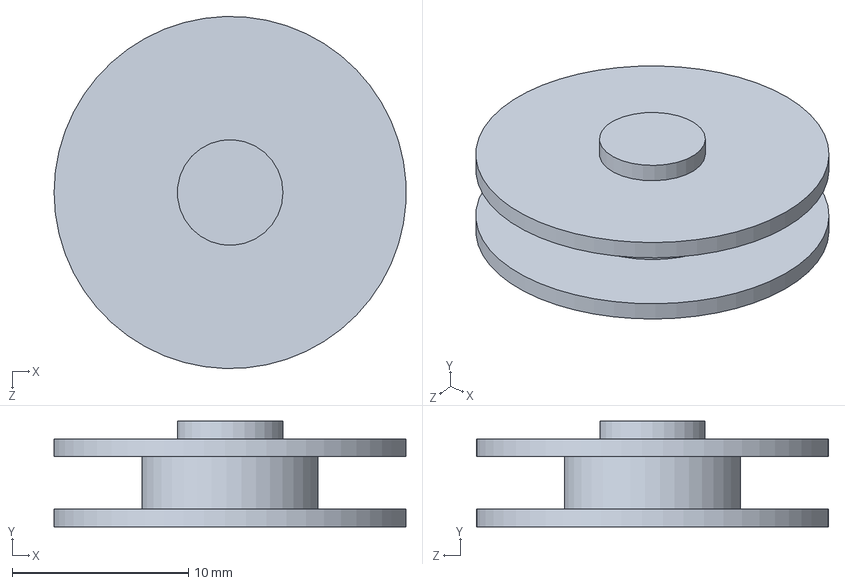
[picture p185: CAD file, 2026-01-20]
solidworks/PACK AND GO (totale assembly heet hoofdassembly)/frame.SLDPRT
20.0 x 6.00 x 20.0 mm
