549116/ProjectGearDeburr/solidworks/PACK AND GO (totale assembly heet hoofdassembly)/Yataklı Rulman,10mm.SLDPRT

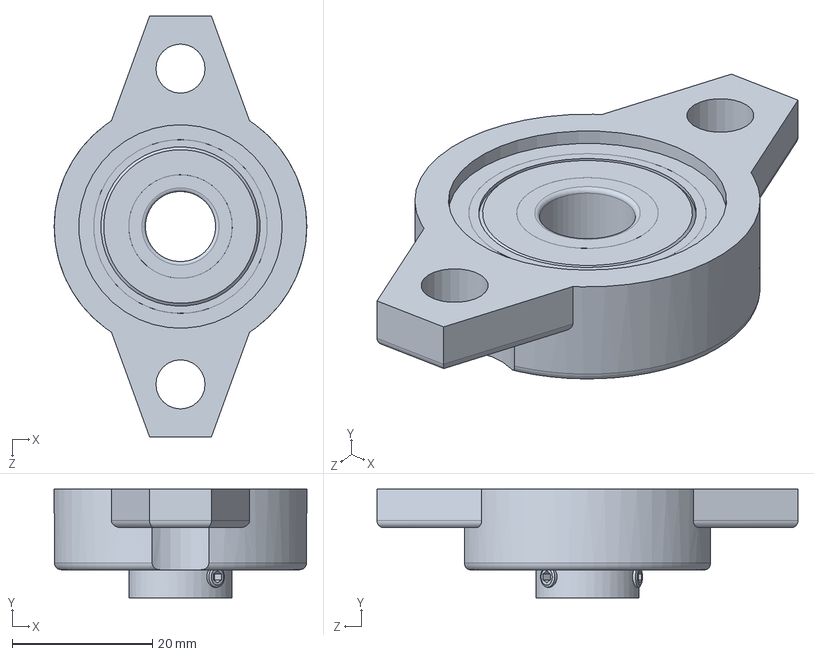
[picture p186: CAD file, 2026-01-20]
solidworks/PACK AND GO (totale assembly heet hoofdassembly)/Yataklı Rulman,10mm.SLDPRT
36.0 x 15.5 x 60.0 mm
