549116/ProjectGearDeburr/solidworks/PACK AND GO (totale assembly heet hoofdassembly)/AM8111-xx00.stp

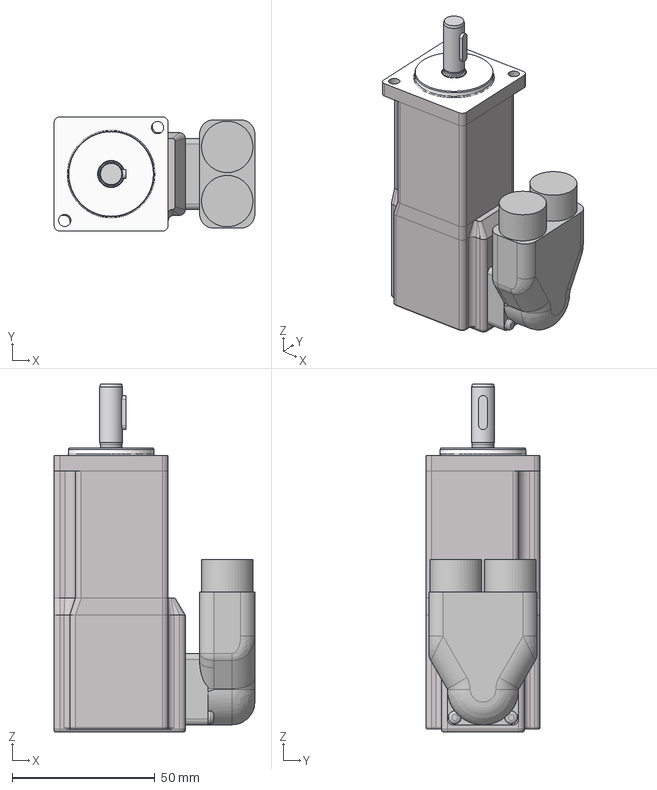
[picture p187: CAD file, 2026-01-20]
solidworks/PACK AND GO (totale assembly heet hoofdassembly)/AM8111-xx00.stp
70.4 x 40.0 x 122.0 mm
DIN 6885-A3x3x12
BM040-VM_00
Intercontec-EEDC101NN00000006000_VM
