549116/ProjectGearDeburr/solidworks/PACK AND GO (totale assembly heet hoofdassembly)/draad.SLDPRT

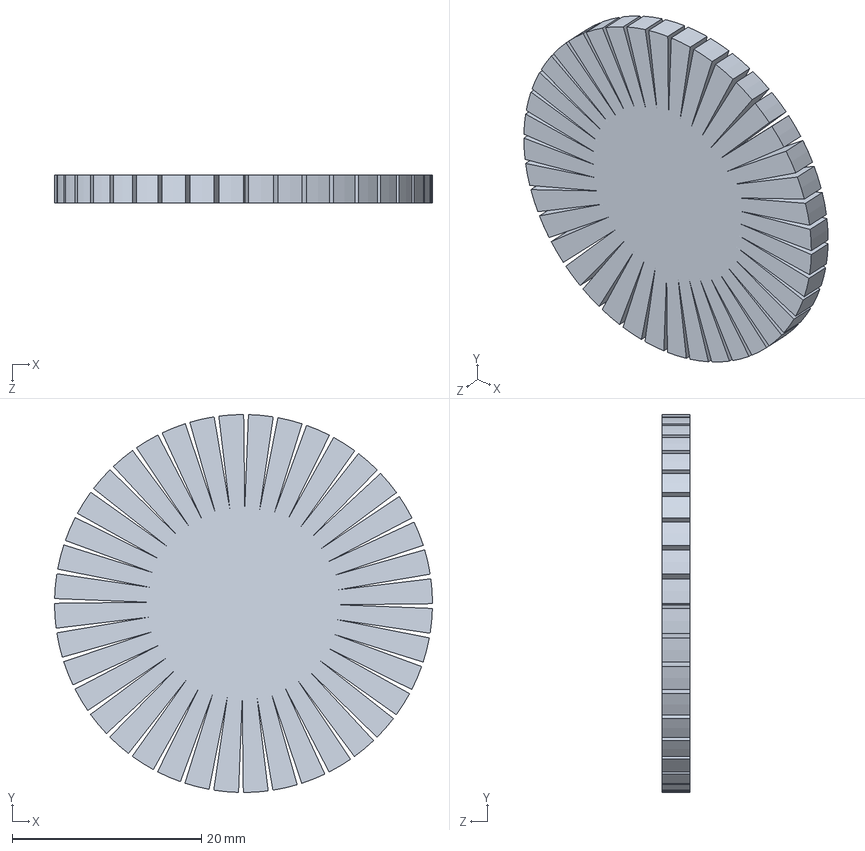
[picture p188: CAD file, 2026-01-20]
solidworks/PACK AND GO (totale assembly heet hoofdassembly)/draad.SLDPRT
40.0 x 40.0 x 3.00 mm
