549116/ProjectGearDeburr/solidworks/PACK AND GO (totale assembly heet hoofdassembly)/cilinderhouder vast.SLDPRT

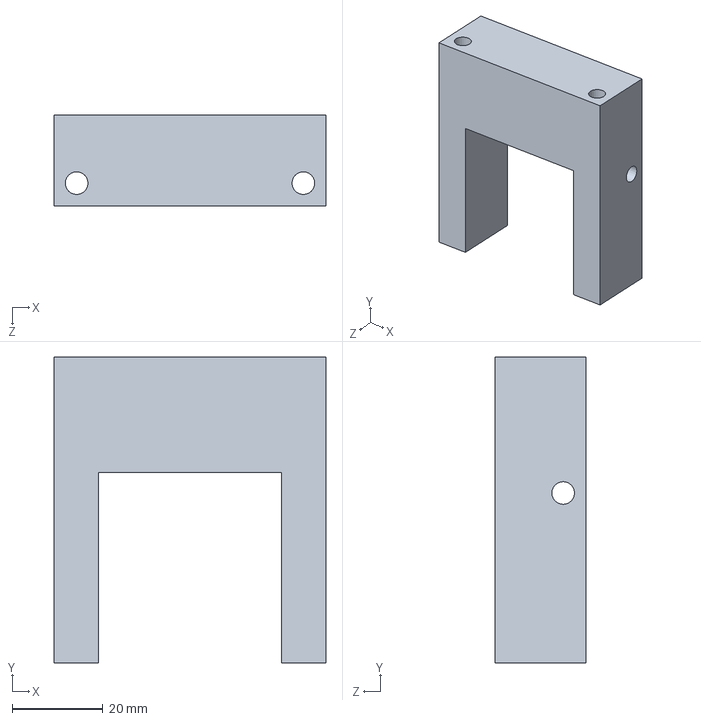
[picture p189: CAD file, 2026-01-20]
solidworks/PACK AND GO (totale assembly heet hoofdassembly)/cilinderhouder vast.SLDPRT
60.0 x 67.5 x 20.0 mm
