549116/ProjectGearDeburr/solidworks/PACK AND GO (totale assembly heet hoofdassembly)/houderhelft conuszuiger links.SLDPRT

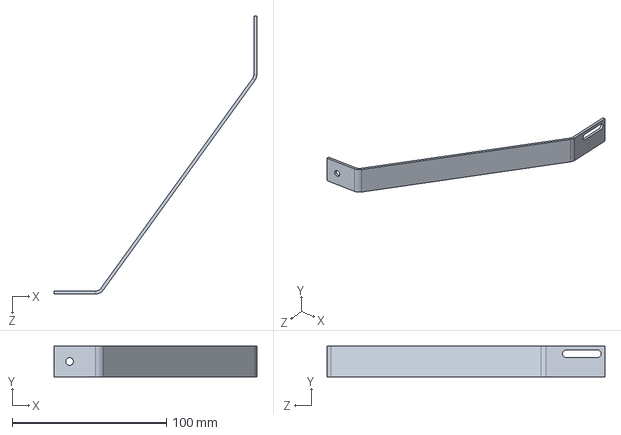
[picture p190: CAD file, 2026-01-20]
solidworks/PACK AND GO (totale assembly heet hoofdassembly)/houderhelft conuszuiger links.SLDPRT
131.2 x 20.0 x 180.0 mm
