549116/ProjectGearDeburr/solidworks/PACK AND GO (totale assembly heet hoofdassembly)/voorwand.SLDPRT

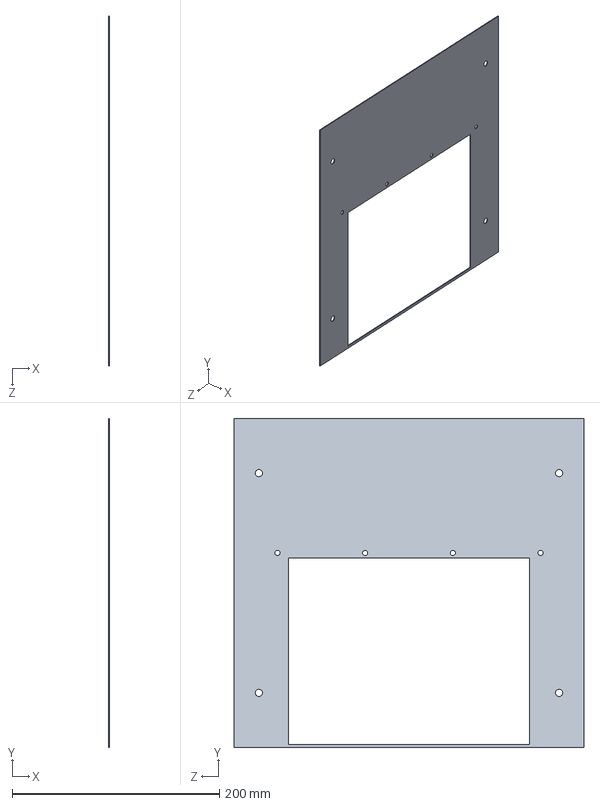
[picture p191: CAD file, 2026-01-20]
solidworks/PACK AND GO (totale assembly heet hoofdassembly)/voorwand.SLDPRT
1.00 x 318.0 x 338.0 mm
