549116/ProjectGearDeburr/solidworks/PACK AND GO (totale assembly heet hoofdassembly)/bodemplaat.SLDPRT

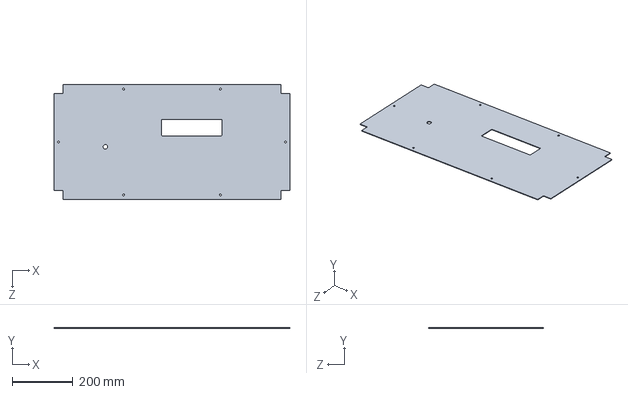
[picture p192: CAD file, 2026-01-20]
solidworks/PACK AND GO (totale assembly heet hoofdassembly)/bodemplaat.SLDPRT
780.0 x 2.00 x 380.0 mm
