549116/ProjectGearDeburr/solidworks/PACK AND GO (totale assembly heet hoofdassembly)/zijwand.SLDPRT

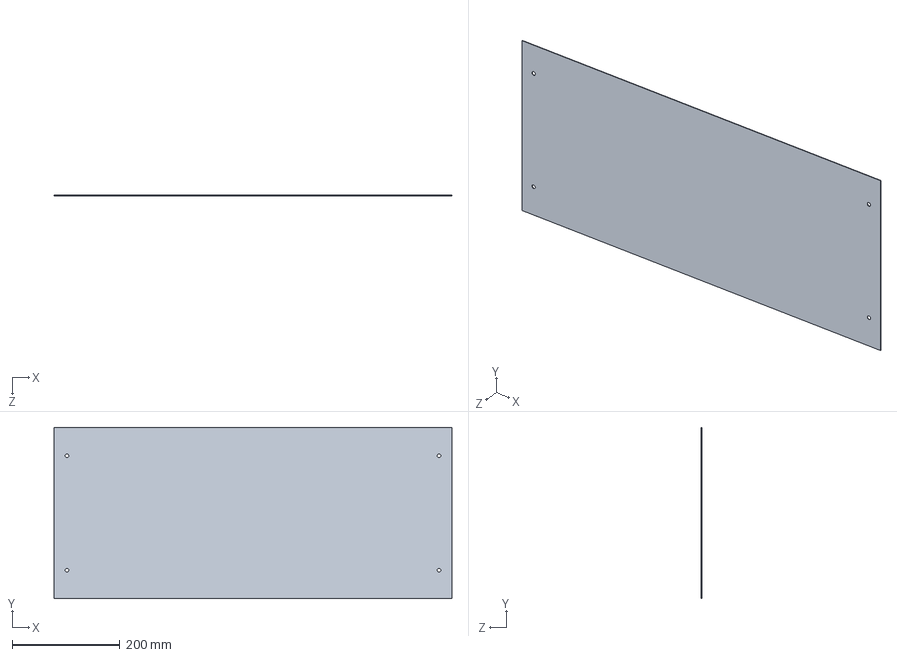
[picture p193: CAD file, 2026-01-20]
solidworks/PACK AND GO (totale assembly heet hoofdassembly)/zijwand.SLDPRT
738.0 x 318.0 x 1.00 mm
