549116/ProjectGearDeburr/solidworks/PACK AND GO (totale assembly heet hoofdassembly)/steun motor draaiplateau.SLDPRT

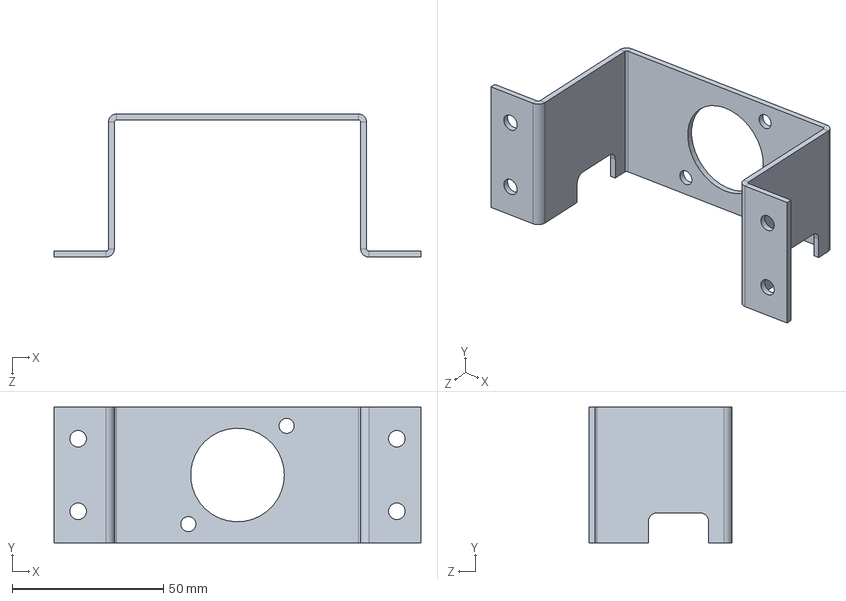
[picture p194: CAD file, 2026-01-20]
solidworks/PACK AND GO (totale assembly heet hoofdassembly)/steun motor draaiplateau.SLDPRT
121.5 x 45.0 x 47.4 mm
