549116/ProjectGearDeburr/solidworks/PACK AND GO (totale assembly heet hoofdassembly)/Guide Rail schuifje.SLDPRT

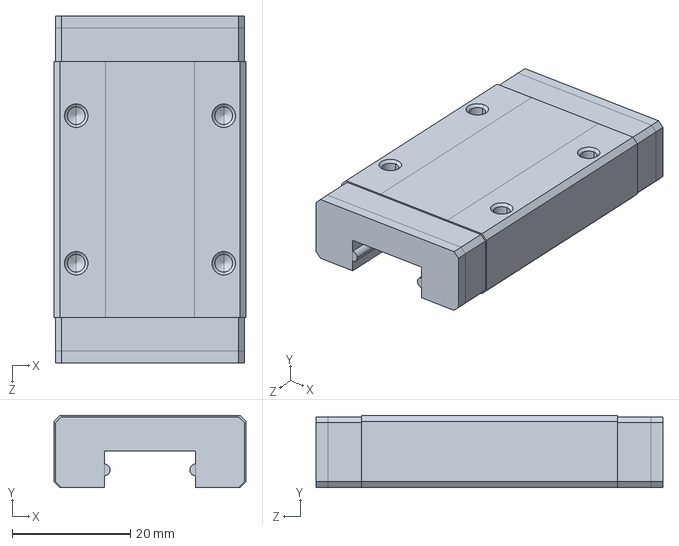
[picture p195: CAD file, 2026-01-20]
solidworks/PACK AND GO (totale assembly heet hoofdassembly)/Guide Rail schuifje.SLDPRT
32.5 x 12.3 x 58.8 mm
