549116/ProjectGearDeburr/solidworks/PACK AND GO (totale assembly heet hoofdassembly)/vulstukje motorsteun maxon.SLDPRT

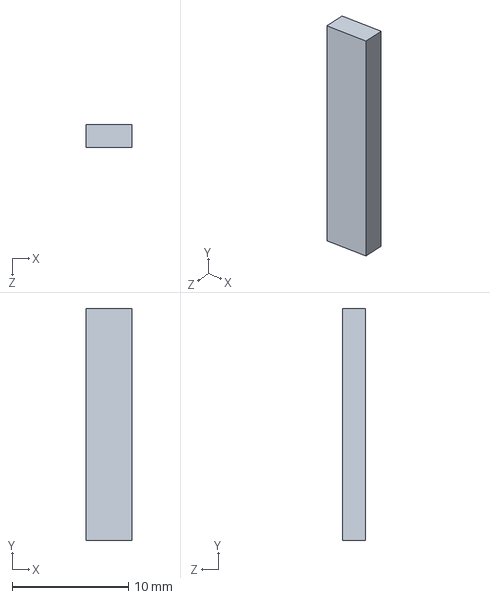
[picture p196: CAD file, 2026-01-20]
solidworks/PACK AND GO (totale assembly heet hoofdassembly)/vulstukje motorsteun maxon.SLDPRT
4.00 x 20.0 x 2.00 mm
