549116/ProjectGearDeburr/solidworks/PACK AND GO (totale assembly heet hoofdassembly)/oor.SLDPRT

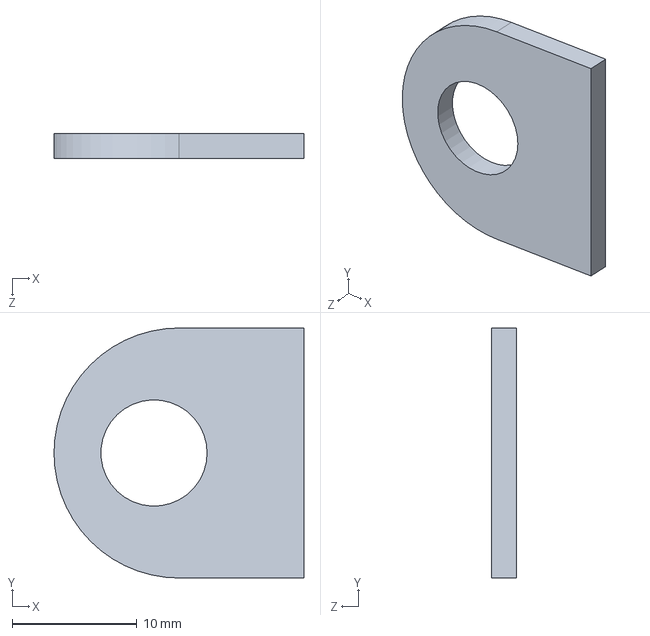
[picture p197: CAD file, 2026-01-20]
solidworks/PACK AND GO (totale assembly heet hoofdassembly)/oor.SLDPRT
20.0 x 20.0 x 2.00 mm
