549116/ProjectGearDeburr/solidworks/PACK AND GO (totale assembly heet hoofdassembly)/lagerblok achter.SLDPRT

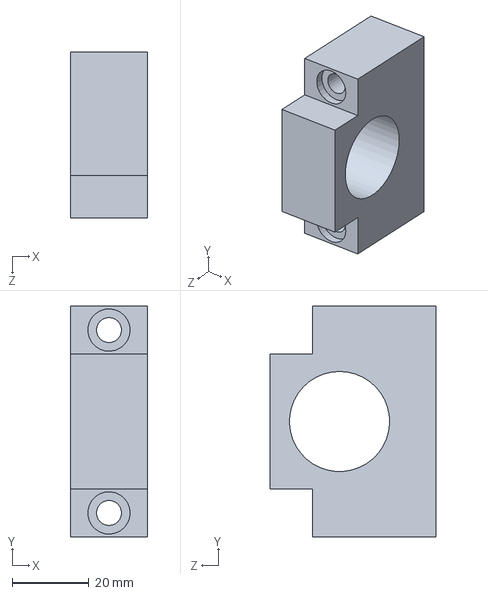
[picture p198: CAD file, 2026-01-20]
solidworks/PACK AND GO (totale assembly heet hoofdassembly)/lagerblok achter.SLDPRT
20.0 x 60.0 x 43.0 mm
