549116/ProjectGearDeburr/solidworks/PACK AND GO (totale assembly heet hoofdassembly)/driehoek.SLDPRT

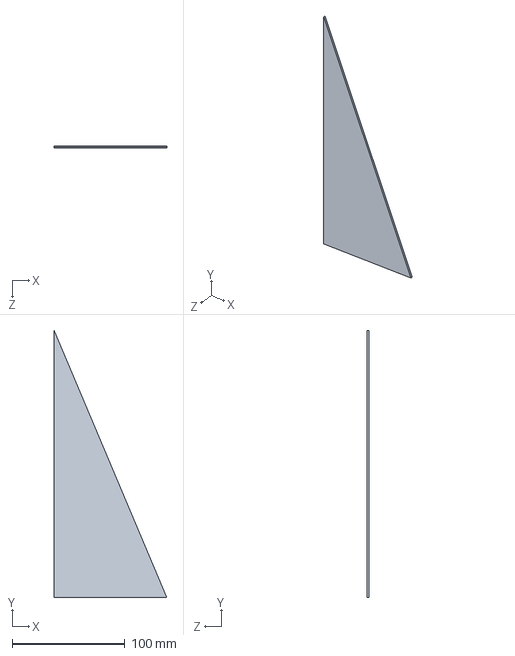
[picture p199: CAD file, 2026-01-20]
solidworks/PACK AND GO (totale assembly heet hoofdassembly)/driehoek.SLDPRT
100.0 x 237.0 x 2.00 mm
