549116/ProjectGearDeburr/solidworks/PACK AND GO (totale assembly heet hoofdassembly)/afscherming lazy susan.SLDPRT

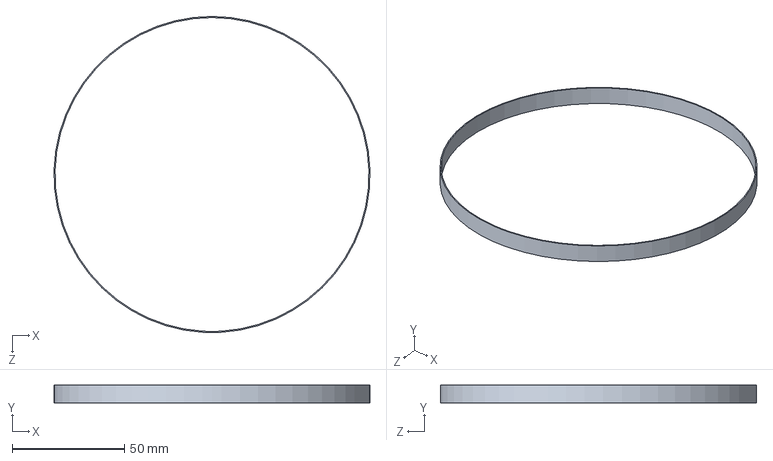
[picture p200: CAD file, 2026-01-20]
solidworks/PACK AND GO (totale assembly heet hoofdassembly)/afscherming lazy susan.SLDPRT
140.9 x 8.00 x 141.0 mm
