549116/ProjectGearDeburr/solidworks/PACK AND GO (totale assembly heet hoofdassembly)/lagerblok vooraan.SLDPRT

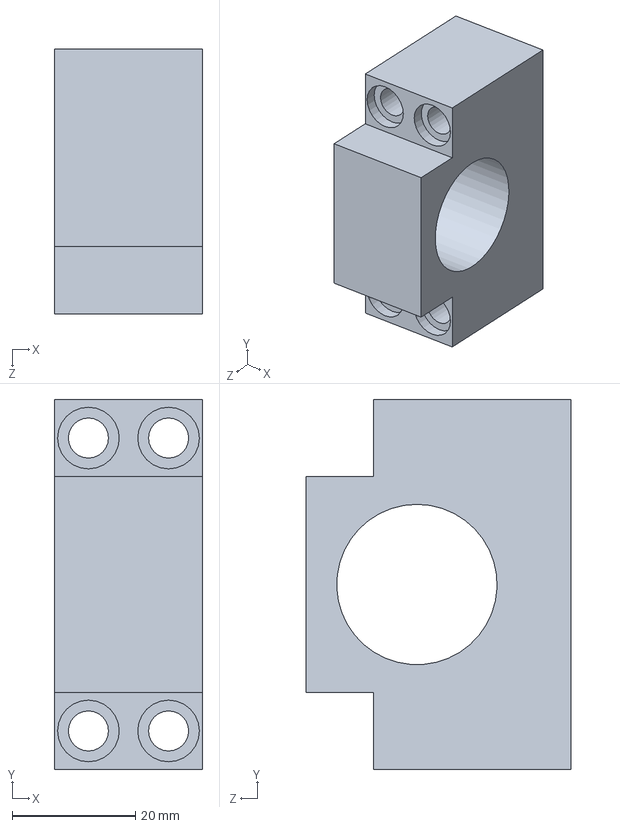
[picture p201: CAD file, 2026-01-20]
solidworks/PACK AND GO (totale assembly heet hoofdassembly)/lagerblok vooraan.SLDPRT
24.0 x 60.0 x 43.0 mm
