549116/ProjectGearDeburr/solidworks/PACK AND GO (totale assembly heet hoofdassembly)/spacer.SLDPRT

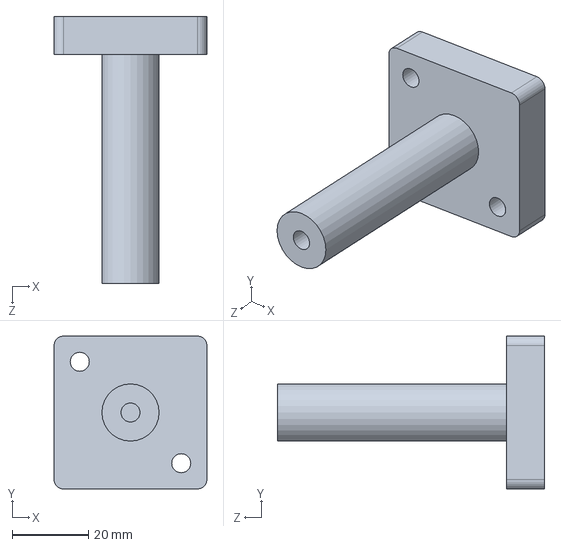
[picture p202: CAD file, 2026-01-20]
solidworks/PACK AND GO (totale assembly heet hoofdassembly)/spacer.SLDPRT
40.1 x 40.1 x 70.0 mm
