549116/ProjectGearDeburr/solidworks/PACK AND GO (totale assembly heet hoofdassembly)/lamel.SLDPRT

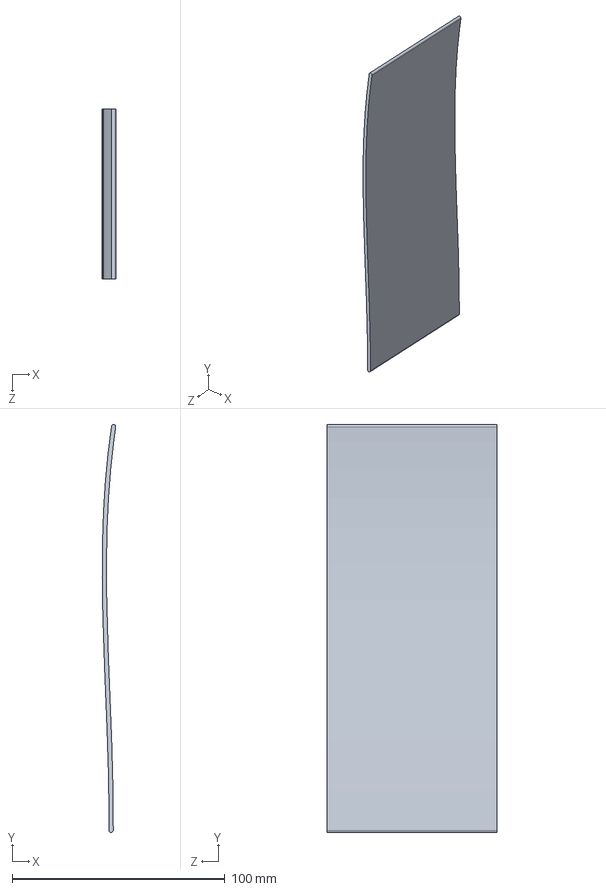
[picture p203: CAD file, 2026-01-20]
solidworks/PACK AND GO (totale assembly heet hoofdassembly)/lamel.SLDPRT
6.34 x 191.6 x 80.0 mm
