549116/ProjectGearDeburr/solidworks/PACK AND GO (totale assembly heet hoofdassembly)/blokje aandrijving.SLDPRT

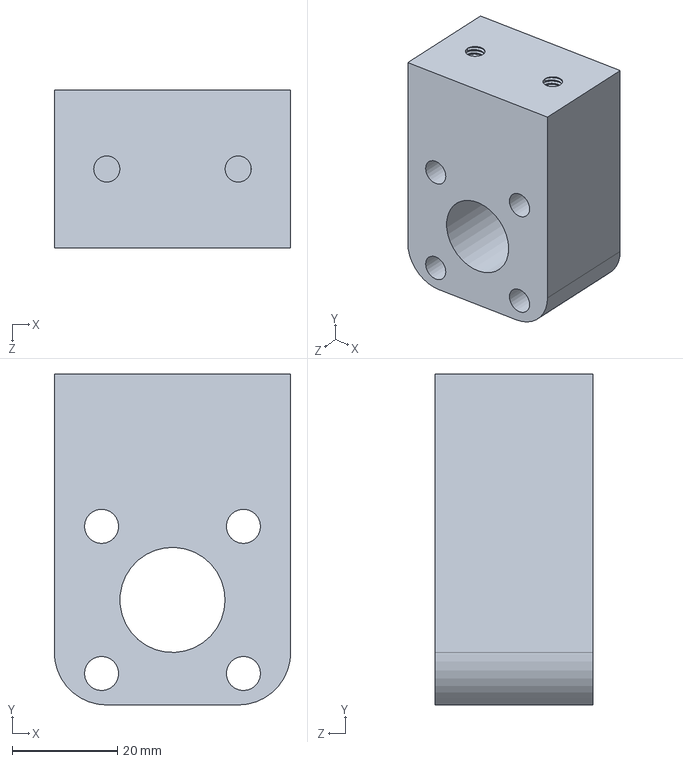
[picture p204: CAD file, 2026-01-20]
solidworks/PACK AND GO (totale assembly heet hoofdassembly)/blokje aandrijving.SLDPRT
45.0 x 63.0 x 30.0 mm
