549116/ProjectGearDeburr/solidworks/PACK AND GO (totale assembly heet hoofdassembly)/aandrijvingblokje.SLDPRT

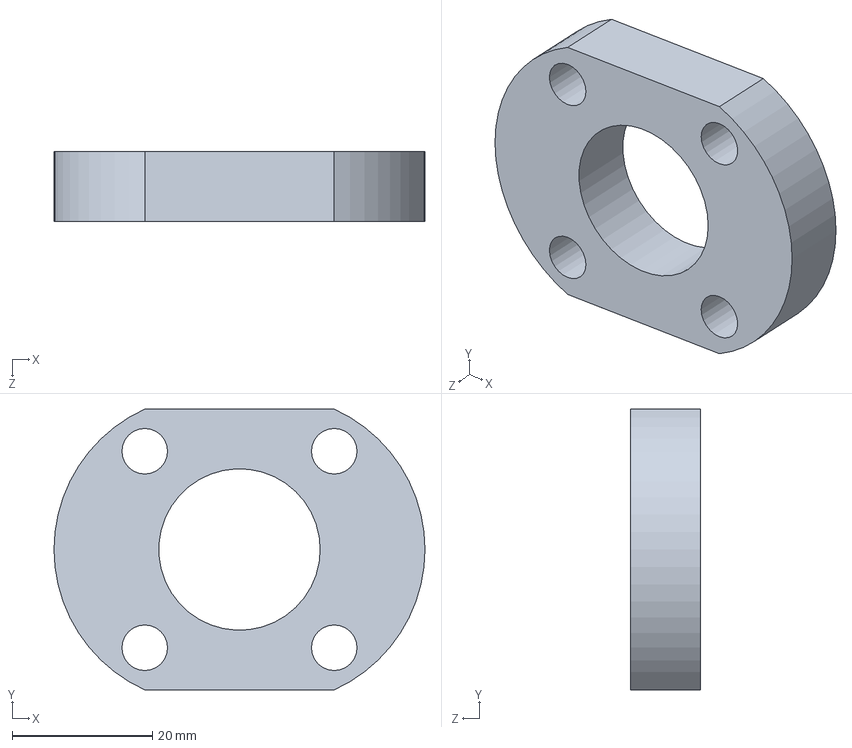
[picture p205: CAD file, 2026-01-20]
solidworks/PACK AND GO (totale assembly heet hoofdassembly)/aandrijvingblokje.SLDPRT
52.9 x 40.0 x 10.0 mm
