549116/ProjectGearDeburr/solidworks/PACK AND GO (totale assembly heet hoofdassembly)/houderhelft conuszuiger rechts.SLDPRT

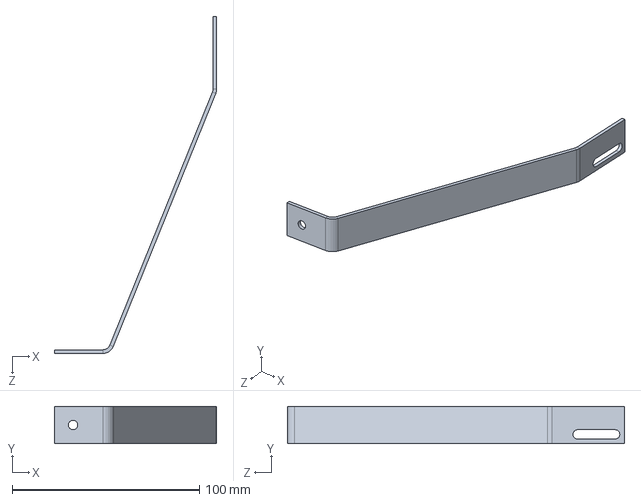
[picture p206: CAD file, 2026-01-20]
solidworks/PACK AND GO (totale assembly heet hoofdassembly)/houderhelft conuszuiger rechts.SLDPRT
86.8 x 20.0 x 180.0 mm
