549116/ProjectGearDeburr/solidworks/PACK AND GO (totale assembly heet hoofdassembly)/spindel.SLDPRT

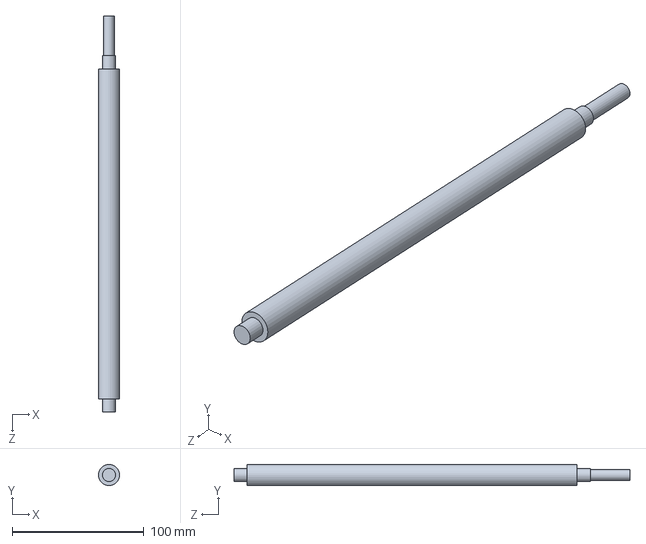
[picture p207: CAD file, 2026-01-20]
solidworks/PACK AND GO (totale assembly heet hoofdassembly)/spindel.SLDPRT
16.0 x 15.9 x 300.0 mm
