549116/ProjectGearDeburr/solidworks/PACK AND GO (totale assembly heet hoofdassembly)/conus klein.SLDPRT

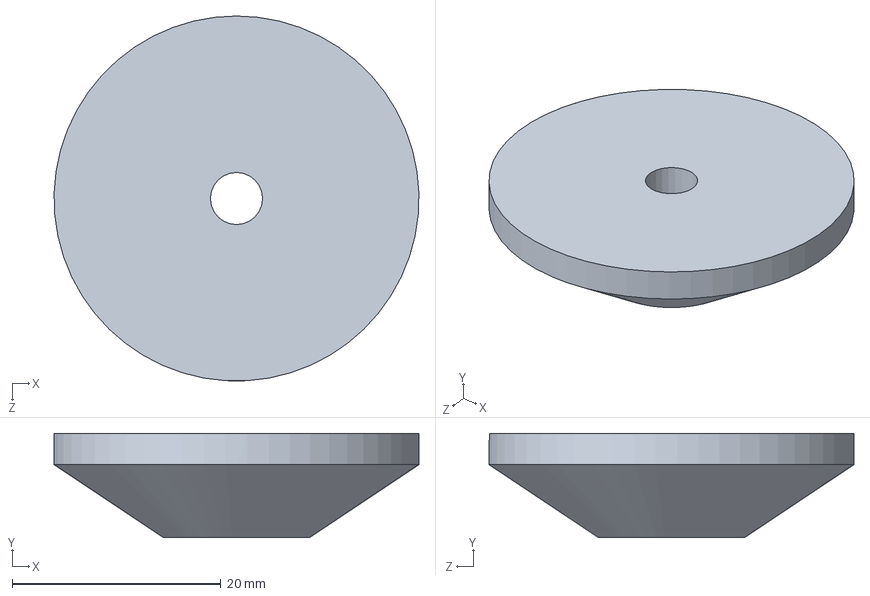
[picture p208: CAD file, 2026-01-20]
solidworks/PACK AND GO (totale assembly heet hoofdassembly)/conus klein.SLDPRT
35.0 x 10.0 x 35.0 mm
