549116/ProjectGearDeburr/solidworks/hoofdassembly.SLDASM

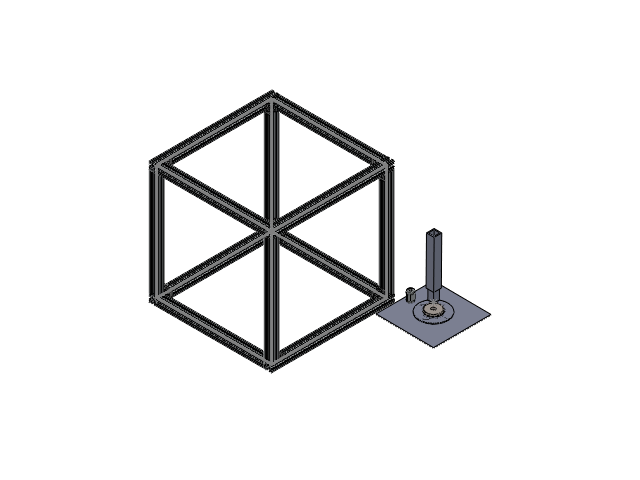
[picture p209: CAD file, 2025-11-12]
solidworks/hoofdassembly.SLDASM
6mmBearing.STEP x 30
HalfLazySusan.STEP x 2
plateau goed
spur gear_am
Case 1
Case 2
Case 3
Magnet x 2
Rotor
Connect x 2
Shaft Holder x 2
onderplaat
Poulie GT2_20T
Poulie GT2 80 dents
conus klein
binnengeleider conus
buitengeleider conus
3842993724_STRUT PROFILE 40x40L_h140_251030114502688
3842993724_STRUT PROFILE 40x40L_h140_251030114503172
3842993724_STRUT PROFILE 40x40L_h140_251030114503802
3842993724_STRUT PROFILE 40x40L_h140_251030114504413
3842993724_STRUT PROFILE 40x40L_h140_251030114505033
3842993724_STRUT PROFILE 40x40L_h140_251030114505755
3842993724_STRUT PROFILE 40x40L_h140_251030114506497
3842993724_STRUT PROFILE 40x40L_h140_251030114507291
3842993724_STRUT PROFILE 40x40L_h140_251030114508117
3842993724_STRUT PROFILE 40x40L_h140_251030114509010
3842993724_STRUT PROFILE 40x40L_h140_251030114509959
3842993724_STRUT PROFILE 40x40L_h140_251030114511012
3842529383_GUSSET 40_40_h140_251030114547458_HD x 16
