549116/ProjectGearDeburr/solidworks/PACK AND GO (totale assembly heet hoofdassembly)/frameOBVbestaand.SLDASM

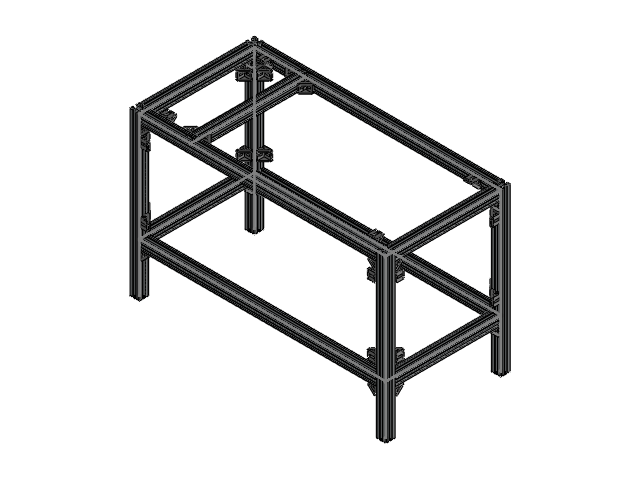
[picture p210: CAD file, 2026-01-21]
solidworks/PACK AND GO (totale assembly heet hoofdassembly)/frameOBVbestaand.SLDASM
3842993703_STRUT PROFILE 30x30_h140_251113140934421
3842993703_STRUT PROFILE 30x30_h140_251113140934812
3842993703_STRUT PROFILE 30x30_h140_251113140935299
3842993703_STRUT PROFILE 30x30_h140_251113140935846
3842993703_STRUT PROFILE 30x30_h140_251113140936371
3842993703_STRUT PROFILE 30x30_h140_251113140936968
3842993703_STRUT PROFILE 30x30_h140_251113140937590
3842993703_STRUT PROFILE 30x30_h140_251113140938261
3842993703_STRUT PROFILE 30x30_h140_251113140938985
3842993703_STRUT PROFILE 30x30_h140_251113140939763
3842993703_STRUT PROFILE 30x30_h140_251113140940618
3842993703_STRUT PROFILE 30x30_h140_251113140941532
3842548775_CAP_h140_251113141007103_HD x 4
3842523528_GUSSET 30_30_h140_251113141639806_HD x 20
3842993703_STRUT PROFILE 30x30_h140_251119122105086
eigen 30x30 hoekje x 20
