549116/ProjectGearDeburr/solidworks/solidworks/frame/lamelframe.SLDASM

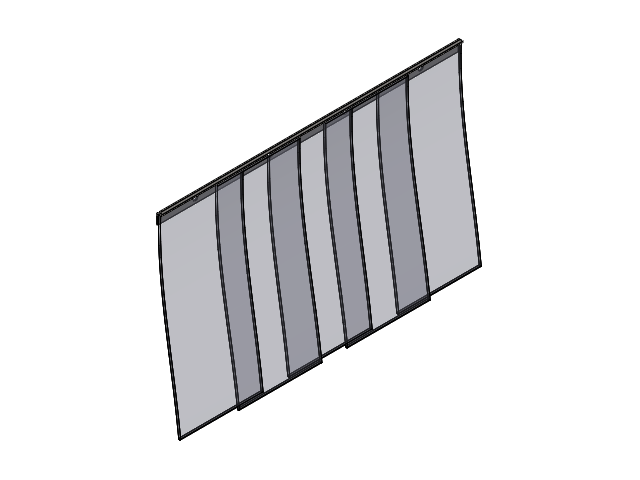
[picture p211: CAD file, 2026-01-20]
solidworks/solidworks/frame/lamelframe.SLDASM
beugel lamellen
lamel x 5
