549116/ProjectGearDeburr/solidworks/solidworks/schuif/assembly spindel en motor.SLDASM

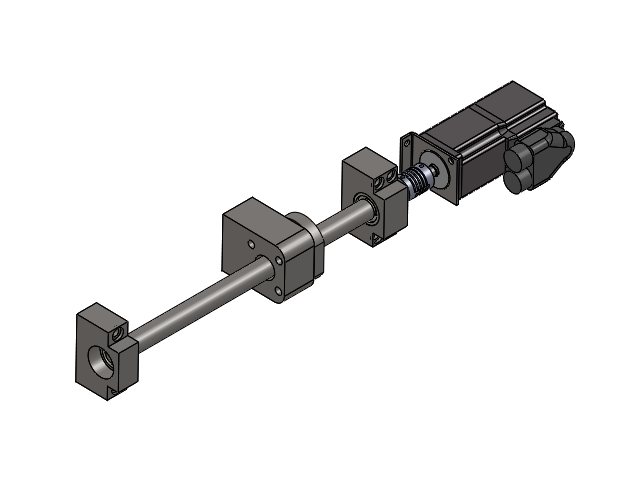
[picture p212: CAD file, 2026-01-21]
solidworks/solidworks/schuif/assembly spindel en motor.SLDASM
spindel
lagerblok vooraan
lagerblok achter
aandrijvingblokje
radial ball bearing_68_din x 2
DIN 6885-A3x3x12.stp
BM040-VM_00.stp
Intercontec-EEDC101NN00000006000_VM.stp
flexkoppeling (schematisch)
steun motor geleiding
blokje aandrijving
