549116/ProjectGearDeburr/solidworks/solidworks/tandwiel klemmen/conushouder beugel-zbook.SLDASM

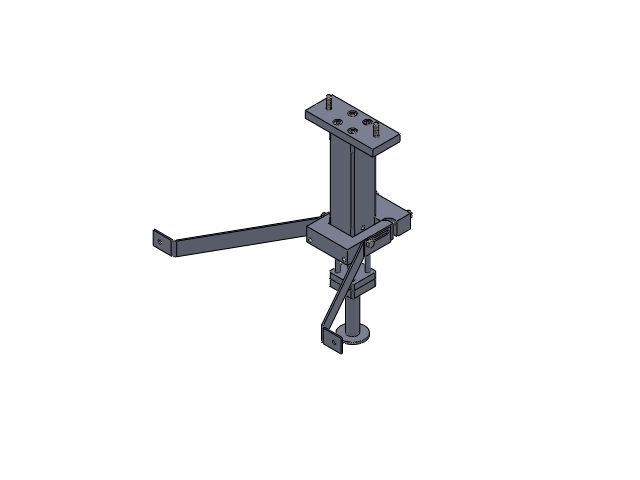
[picture p214: CAD file, 2026-01-20]
solidworks/solidworks/tandwiel klemmen/conushouder beugel-zbook.SLDASM
cilinderhouder vast
cilinderhouder bewegend
hex screw gradec_din x 4
houderhelft conuszuiger rechts
cilinder bewegend
cilinder vast
geleider x 2
bevestiging klemcilinder en frame
socket head cap screw_din x 7
spacer
conus klein
houderhelft conuszuiger links
