549116/ProjectGearDeburr/solidworks/solidworks/assembly draaiplateau-zbook.SLDASM

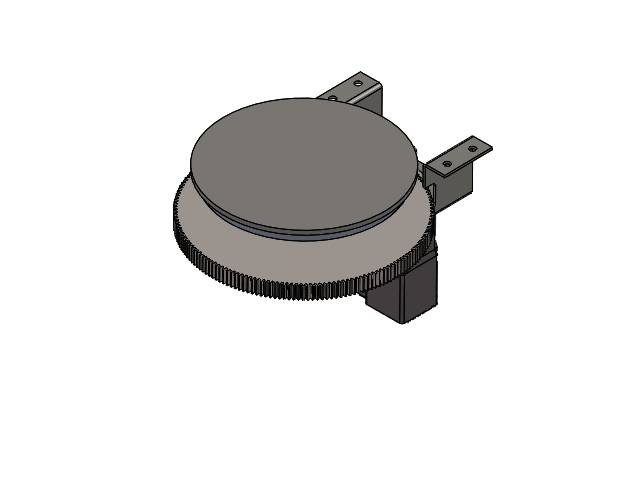
[picture p215: CAD file, 2026-01-20]
solidworks/solidworks/assembly draaiplateau-zbook.SLDASM
6mmBearing.STEP x 30
HalfLazySusan.STEP x 2
plateau goed
afscherming lazy susan
DIN 6885-A3x3x12.stp
BM040-VM_00.stp
Intercontec-EEDC101NN00000006000_VM.stp
spur gear_am x 2
steun motor draaiplateau
