549116/ProjectGearDeburr/solidworks/solidworks/koopdelen/cilinder staalborstel/SOLIDWORKS/assembly goed.SLDASM

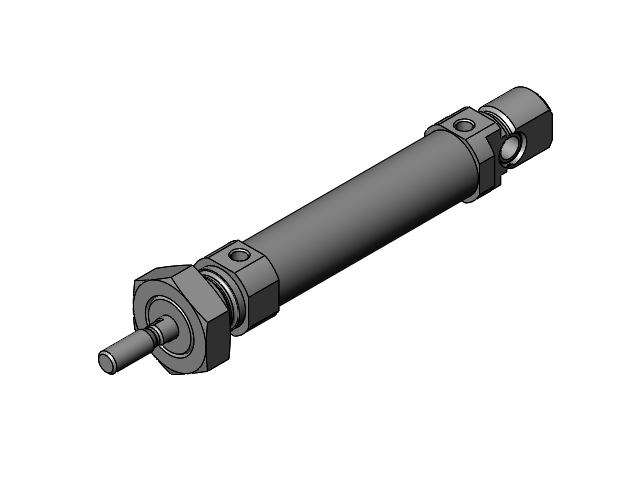
[picture p216: CAD file, 2026-01-20]
solidworks/solidworks/koopdelen/cilinder staalborstel/SOLIDWORKS/assembly goed.SLDASM
1908261 DSNU-16-30-P---(A----0-ZR)
DIN-439-B - M16x1.5(F)
1908261 DSNU-16-30-P---(A---00--0-KS)
