549116/ProjectGearDeburr/solidworks/PACK AND GO (totale assembly heet hoofdassembly)/complete borstel D=40.SLDASM

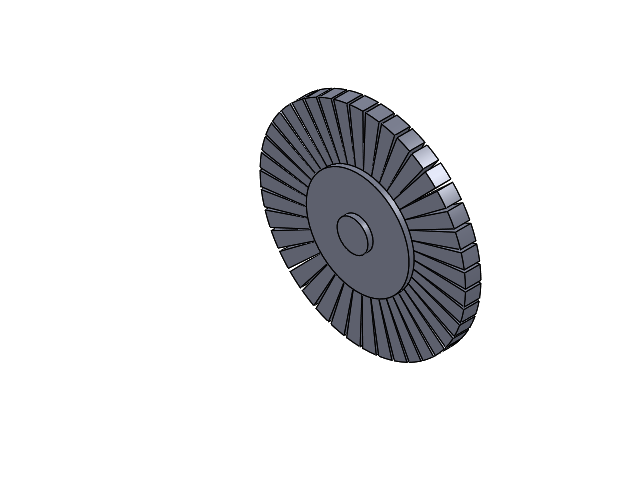
[picture p217: CAD file, 2026-01-21]
solidworks/PACK AND GO (totale assembly heet hoofdassembly)/complete borstel D=40.SLDASM
draad
frame
