549116/ProjectGearDeburr/solidworks/PACK AND GO (totale assembly heet hoofdassembly)/assembly zijwand met componenten.SLDASM

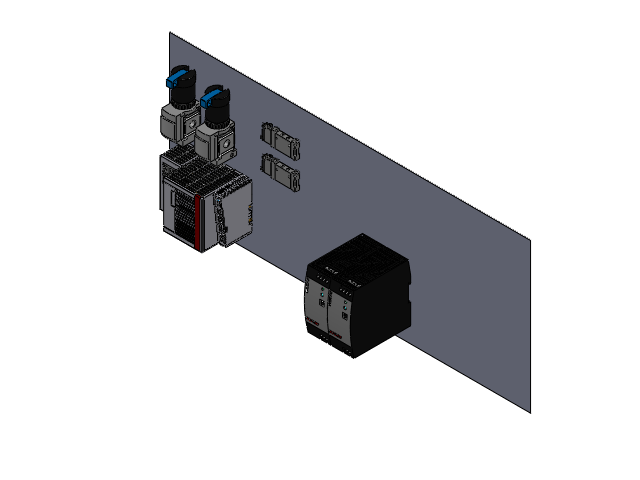
[picture p218: CAD file, 2026-01-21]
solidworks/PACK AND GO (totale assembly heet hoofdassembly)/assembly zijwand met componenten.SLDASM
zijwand
CX52x0.stp
ps_49x124x124.stp x 2
527690 MS4-LR-1_4-D7-AS-Z-0D x 2
8185907 MS4-LR x 2
564212_VUVG_LK10_M52_A_T_M5__1H2__L______G_ x 2
3779382_VUVG_LK_IP40 x 2
