549116/ProjectGearDeburr/solidworks/PACK AND GO (totale assembly heet hoofdassembly)/conushouder beugel.SLDASM

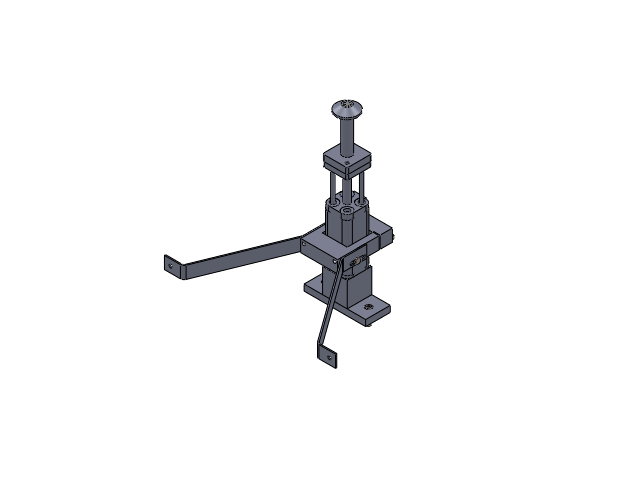
[picture p219: CAD file, 2026-01-21]
solidworks/PACK AND GO (totale assembly heet hoofdassembly)/conushouder beugel.SLDASM
cilinderhouder vast
cilinderhouder bewegend
hex screw gradec_din x 4
houderhelft conuszuiger rechts
cilinder bewegend
cilinder vast
bevestiging klemcilinder en frame
socket head cap screw_din x 7
spacer
conus klein
houderhelft conuszuiger links
spacer between frame
