549116/ProjectGearDeburr/solidworks/PACK AND GO (totale assembly heet hoofdassembly)/assembly geleiding.SLDASM

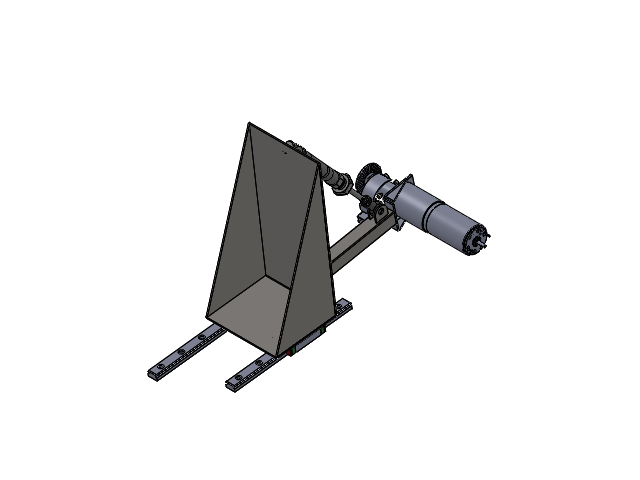
[picture p220: CAD file, 2026-01-21]
solidworks/PACK AND GO (totale assembly heet hoofdassembly)/assembly geleiding.SLDASM
zetdeel op geleiding
driehoek x 2
oor x 6
koker 20x20
draad
frame
9254 SGS-M6---(S_0_0_0)
DIN-439-B - M6(F)
afschermkap
beugel afschermkap
Maxon RE40
19201_DSNU_16_50_P____A____0_ZR_
DIN_439_B___M16x1_5_F_
19201_DSNU_16_50_P____A___00__0_KS_
gearbox maxon
busje borstel motor
motorbeugel maxon
vulstukje motorsteun maxon
socket head cap screw_din x 4
Guide Rail schuifje x 2
Guide Rail zelf x 2
