549116/ProjectGearDeburr/solidworks/solidworks/hoofdassembly-zbook.SLDASM

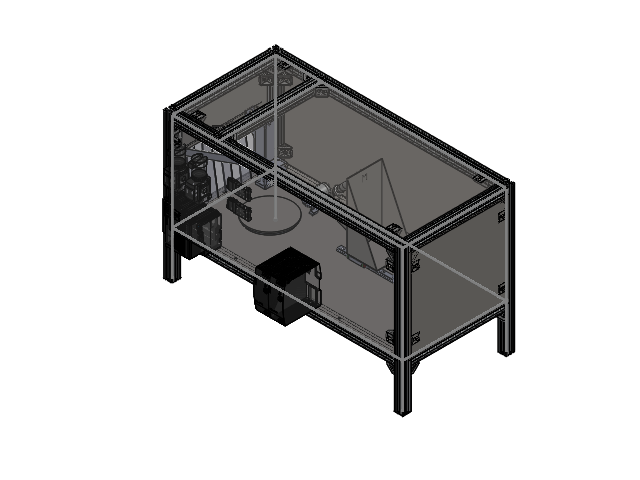
[picture p221: CAD file, 2026-01-20]
solidworks/solidworks/hoofdassembly-zbook.SLDASM
conus klein
3842993703_STRUT PROFILE 30x30_h140_251113140934421
3842993703_STRUT PROFILE 30x30_h140_251113140934812
3842993703_STRUT PROFILE 30x30_h140_251113140935299
3842993703_STRUT PROFILE 30x30_h140_251113140935846
3842993703_STRUT PROFILE 30x30_h140_251113140936371
3842993703_STRUT PROFILE 30x30_h140_251113140936968
3842993703_STRUT PROFILE 30x30_h140_251113140937590
3842993703_STRUT PROFILE 30x30_h140_251113140938261
3842993703_STRUT PROFILE 30x30_h140_251113140938985
3842993703_STRUT PROFILE 30x30_h140_251113140939763
3842993703_STRUT PROFILE 30x30_h140_251113140940618
3842993703_STRUT PROFILE 30x30_h140_251113140941532
3842548775_CAP_h140_251113141007103_HD x 4
3842523528_GUSSET 30_30_h140_251113141639806_HD x 20
3842993703_STRUT PROFILE 30x30_h140_251119122105086
eigen 30x30 hoekje x 24
Guide Rail x 2
zetdeel op geleiding
driehoek x 2
oor x 6
koker 20x20
Case 1
Case 2
Case 3
Magnet x 2
Rotor
Connect x 2
Shaft Holder x 2
draad
frame
9254 SGS-M6---(S_0_0_0)
DIN-439-B - M6(F)
afschermkap
beugel afschermkap
19200 DSNU-16-40-P---(A----0-ZR)
DIN-439-B - M16x1.5(F)
19200 DSNU-16-40-P---(A---00--0-KS)
achterwand
zijwand x 2
plafond
voorwand
beugel lamellen
lamel x 5
hex nut style 1 gradeab_din x 28
socket head cap screw 4762_din x 4
socket head cap screw_din x 20
CX52x0.stp
ps_49x124x124.stp x 2
527690 MS4-LR-1_4-D7-AS-Z-0D x 2
8185907 MS4-LR x 2
564212_VUVG_LK10_M52_A_T_M5__1H2__L______G_ x 2
3779382_VUVG_LK_IP40 x 2
cilinder bewegend
cilinder vast
geleider x 4
houderhelft conuszuiger links
cilinderhouder vast
cilinderhouder bewegend
hex screw gradec_din x 4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
