549116/ProjectGearDeburr/(list of files, cad)

Other CAD files:
solidworks/PACK AND GO (totale assembly heet hoofdassembly)/lamelframe.SLDASM
solidworks/solidworks/frame/frameOBVbestaand.SLDASM
solidworks/PACK AND GO (totale assembly heet hoofdassembly)/assembly draaiplateau.SLDASM
solidworks/PACK AND GO (totale assembly heet hoofdassembly)/9254 SGS-M6---(0_0).sldasm
solidworks/PACK AND GO (totale assembly heet hoofdassembly)/assembly spindel en motor.SLDASM
solidworks/solidworks/automation/plateau.SLDPRT
solidworks/solidworks/koopdelen/Poulie GT2 80 dents 2.JPG.SLDPRT
solidworks/solidworks/tandwiel modul 1 170 tands.SLDPRT
solidworks/PACK AND GO (totale assembly heet hoofdassembly)/Maxon RE40.SLDPRT
solidworks/PACK AND GO (totale assembly heet hoofdassembly)/9254 SGS-M6---(S_0_0_0).sldprt
solidworks/PACK AND GO (totale assembly heet hoofdassembly)/LazySusan.STEP
solidworks/PACK AND GO (totale assembly heet hoofdassembly)/19201_DSNU_16_50_P_A____0_.sldasm
solidworks/PACK AND GO (totale assembly heet hoofdassembly)/19201_DSNU_16_50_P____A___00__0_KS_.sldprt
solidworks/PACK AND GO (totale assembly heet hoofdassembly)/19201_DSNU_16_50_P____A____0_ZR_.sldprt
solidworks/PACK AND GO (totale assembly heet hoofdassembly)/3779382_VUVG_LK_IP40.sldprt
solidworks/PACK AND GO (totale assembly heet hoofdassembly)/3842523528_GUSSET 30_30_h140_251113141639806_HD.SLDPRT
solidworks/PACK AND GO (totale assembly heet hoofdassembly)/3842548775_CAP_h140_251113141007103_HD.SLDPRT
solidworks/PACK AND GO (totale assembly heet hoofdassembly)/3842993703_STRUT PROFILE 30x30_h140_251113140934421.SLDPRT
solidworks/PACK AND GO (totale assembly heet hoofdassembly)/3842993703_STRUT PROFILE 30x30_h140_251113140934812.SLDPRT
solidworks/PACK AND GO (totale assembly heet hoofdassembly)/3842993703_STRUT PROFILE 30x30_h140_251113140935299.SLDPRT
solidworks/PACK AND GO (totale assembly heet hoofdassembly)/3842993703_STRUT PROFILE 30x30_h140_251113140935846.SLDPRT
solidworks/PACK AND GO (totale assembly heet hoofdassembly)/3842993703_STRUT PROFILE 30x30_h140_251113140936371.SLDPRT
solidworks/PACK AND GO (totale assembly heet hoofdassembly)/3842993703_STRUT PROFILE 30x30_h140_251113140936968.SLDPRT
solidworks/PACK AND GO (totale assembly heet hoofdassembly)/3842993703_STRUT PROFILE 30x30_h140_251113140937590.SLDPRT
solidworks/PACK AND GO (totale assembly heet hoofdassembly)/3842993703_STRUT PROFILE 30x30_h140_251113140938261.SLDPRT
solidworks/PACK AND GO (totale assembly heet hoofdassembly)/3842993703_STRUT PROFILE 30x30_h140_251113140938985.SLDPRT
solidworks/PACK AND GO (totale assembly heet hoofdassembly)/3842993703_STRUT PROFILE 30x30_h140_251113140939763.SLDPRT
solidworks/PACK AND GO (totale assembly heet hoofdassembly)/3842993703_STRUT PROFILE 30x30_h140_251113140940618.SLDPRT
solidworks/PACK AND GO (totale assembly heet hoofdassembly)/3842993703_STRUT PROFILE 30x30_h140_251113140941532.SLDPRT
solidworks/PACK AND GO (totale assembly heet hoofdassembly)/3842993703_STRUT PROFILE 30x30_h140_251119122105086.SLDPRT
solidworks/PACK AND GO (totale assembly heet hoofdassembly)/527690 MS4-LR-1_4-D7-AS-Z-0D.sldprt
solidworks/PACK AND GO (totale assembly heet hoofdassembly)/529420 MS4-LR-1_4-D7-AS-Z.sldasm
solidworks/PACK AND GO (totale assembly heet hoofdassembly)/564212_VUVG_LK10_M52_A_T_M5__1H2__L______G_.sldprt
solidworks/PACK AND GO (totale assembly heet hoofdassembly)/8042539_VUVG_LK10_M52_AT_M5_1H2L_S.sldasm
solidworks/PACK AND GO (totale assembly heet hoofdassembly)/8185907 MS4-LR.sldprt
solidworks/PACK AND GO (totale assembly heet hoofdassembly)/DIN-439-B - M6(F).sldprt
solidworks/PACK AND GO (totale assembly heet hoofdassembly)/DIN_439_B___M16x1_5_F_.sldprt
solidworks/PACK AND GO (totale assembly heet hoofdassembly)/LazySusan.SLDASM
solidworks/automation/onderplaat.SLDPRT
solidworks/frame/3842523528_GUSSET 30_30_h140_251113141639806_HD.SLDPRT
solidworks/frame/3842993703_STRUT PROFILE 30x30_h140_251113135629012.SLDPRT
solidworks/frame/3842993703_STRUT PROFILE 30x30_h140_251113135629505.SLDPRT
solidworks/frame/3842993703_STRUT PROFILE 30x30_h140_251113135630001.SLDPRT
solidworks/frame/3842993703_STRUT PROFILE 30x30_h140_251113135630503.SLDPRT
solidworks/frame/3842993703_STRUT PROFILE 30x30_h140_251113135631056.SLDPRT
solidworks/frame/3842993703_STRUT PROFILE 30x30_h140_251113135631677.SLDPRT
solidworks/frame/3842993703_STRUT PROFILE 30x30_h140_251113135632302.SLDPRT
solidworks/frame/3842993703_STRUT PROFILE 30x30_h140_251113135632996.SLDPRT
solidworks/frame/3842993703_STRUT PROFILE 30x30_h140_251113135633728.SLDPRT
solidworks/frame/3842993703_STRUT PROFILE 30x30_h140_251113135634516.SLDPRT
solidworks/frame/3842993703_STRUT PROFILE 30x30_h140_251113135635351.SLDPRT
solidworks/frame/3842993703_STRUT PROFILE 30x30_h140_251113135636408.SLDPRT
solidworks/frame/3842993703_STRUT PROFILE 30x30_h140_251113140934421.SLDPRT
solidworks/frame/3842993703_STRUT PROFILE 30x30_h140_251113140934812.SLDPRT
solidworks/frame/3842993703_STRUT PROFILE 30x30_h140_251113140935299.SLDPRT
solidworks/frame/3842993703_STRUT PROFILE 30x30_h140_251113140935846.SLDPRT
solidworks/frame/3842993703_STRUT PROFILE 30x30_h140_251113140936371.SLDPRT
solidworks/frame/3842993703_STRUT PROFILE 30x30_h140_251113140936968.SLDPRT
solidworks/frame/3842993703_STRUT PROFILE 30x30_h140_251113140937590.SLDPRT
solidworks/frame/3842993703_STRUT PROFILE 30x30_h140_251113140938261.SLDPRT
solidworks/frame/3842993703_STRUT PROFILE 30x30_h140_251113140938985.SLDPRT
solidworks/frame/3842993703_STRUT PROFILE 30x30_h140_251113140939763.SLDPRT
solidworks/frame/3842993703_STRUT PROFILE 30x30_h140_251113140940618.SLDPRT
solidworks/frame/3842993703_STRUT PROFILE 30x30_h140_251113140941532.SLDPRT
solidworks/frame/frameOBVbestaand.SLDASM
solidworks/solidworks/19186_DSNU_10_50_P_A____0_.sldasm
solidworks/solidworks/19186_DSNU_10_50_P____A___00__0_KS_.sldprt
solidworks/solidworks/19186_DSNU_10_50_P____A____0_ZR_.sldprt
solidworks/solidworks/DIN_439_B___M12x1_25_F_.sldprt
solidworks/solidworks/frame/3842523561_GUSSET 45_45_h140_251027132909264_HD.SLDPRT
solidworks/solidworks/frame/3842529383_GUSSET 40_40_h140_251030114547458_HD.SLDPRT
solidworks/solidworks/frame/3842993703_STRUT PROFILE 30x30_h140_251113135629012.SLDPRT
solidworks/solidworks/frame/3842993703_STRUT PROFILE 30x30_h140_251113135629505.SLDPRT
solidworks/solidworks/frame/3842993703_STRUT PROFILE 30x30_h140_251113135630001.SLDPRT
solidworks/solidworks/frame/3842993703_STRUT PROFILE 30x30_h140_251113135630503.SLDPRT
solidworks/solidworks/frame/3842993703_STRUT PROFILE 30x30_h140_251113135631056.SLDPRT
solidworks/solidworks/frame/3842993703_STRUT PROFILE 30x30_h140_251113135631677.SLDPRT
solidworks/solidworks/frame/3842993703_STRUT PROFILE 30x30_h140_251113135632302.SLDPRT
solidworks/solidworks/frame/3842993703_STRUT PROFILE 30x30_h140_251113135632996.SLDPRT
solidworks/solidworks/frame/3842993703_STRUT PROFILE 30x30_h140_251113135633728.SLDPRT
solidworks/solidworks/frame/3842993703_STRUT PROFILE 30x30_h140_251113135634516.SLDPRT
solidworks/solidworks/frame/3842993703_STRUT PROFILE 30x30_h140_251113135635351.SLDPRT
solidworks/solidworks/frame/3842993703_STRUT PROFILE 30x30_h140_251113135636408.SLDPRT
solidworks/solidworks/frame/3842993724_STRUT PROFILE 40x40L_h140_251030114502688.SLDPRT
solidworks/solidworks/frame/3842993724_STRUT PROFILE 40x40L_h140_251030114503172.SLDPRT
solidworks/solidworks/frame/3842993724_STRUT PROFILE 40x40L_h140_251030114503802.SLDPRT
solidworks/solidworks/frame/3842993724_STRUT PROFILE 40x40L_h140_251030114504413.SLDPRT
solidworks/solidworks/frame/3842993724_STRUT PROFILE 40x40L_h140_251030114505033.SLDPRT
solidworks/solidworks/frame/3842993724_STRUT PROFILE 40x40L_h140_251030114505755.SLDPRT
solidworks/solidworks/frame/3842993724_STRUT PROFILE 40x40L_h140_251030114506497.SLDPRT
solidworks/solidworks/frame/3842993724_STRUT PROFILE 40x40L_h140_251030114507291.SLDPRT
solidworks/solidworks/frame/3842993724_STRUT PROFILE 40x40L_h140_251030114508117.SLDPRT
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
