549116/ProjectGearDeburr/documentatie/planning en evaluatie/Planning Tandwiel Deburren.docx

Kwartiel | Week | Datum (ma–zo) | Activiteiten | Op te leveren onderdelen
Q1 | 1.1 | 01–07 sep 2025 | - Opstart - Uitleg over project | –
Q1 | 1.2 | 08–14 sep 2025 | - Bedrijfsbezoek - Projectonderzoek - Marktonderzoek | –
Q1 | 1.3 | 15–21 sep 2025 | - Functieschema maken - Morfologisch overzicht - Begin PvE | Eerste versie PvE (concept)
Q1 | 1.4 | 22–28 sep 2025 | - Planning - PvE verder uitwerken en opsturen - Testen conceptideeën - IDEF0 diagram beginnen | Planning + bijgewerkt PvE
Q1 | 1.5 | 29 sep–05 okt 2025 | - IDEF0 diagram maken - Voorbereiden presentatie week 6 - Proof of concept ontwerpen | Conceptschetsen proof of concept
Q1 | 1.6 | 06–12 okt 2025 | - Vooruitgangspresentatie voorbereiden - Presenteren minor klas - Uitwerken eindconcept - Voorstel aan Joris en bedrijf | Vooruitgangspresentatie voorstel eindconcept
Q1 | 1.7 | 13–19 okt 2025 | - Eindconcept tekenen in SolidWorks | 3D-model eindconcept
20-26 okt 2025 | | | Herfstvakantie
Q1 | 1.8 | 27 okt–02 nov 2025 | - Documentatie afronden - Eindconcept afronden - Purchase parts list maken | Onderdelenlijst (concept)
Q1 | 1.9 | 03–09 nov 2025 | - Documentatie afronden - Keuze en onderbouwing concept - Voorbereiden kennisoverdracht | Purchase Lists IDEF0-diagram

Q2 | 2.1 | 10–16 nov 2025 | - Onderdelen in kaart brengen - Testplan opstellen | Testplan (concept)
Q2 | 2.2 | 17–23 nov 2025 | - Begin programma schrijven - opstelling bouwen | Eerste code & opstellingsbasis
Q2 | 2.3 | 24–30 nov 2025 | - Programma schrijven/testen - opstelling verder bouwen | Werkende basisopstelling
Q2 | 2.4 | 01–07 dec 2025 | - Programma schrijven en testen (vervolg) | Tussentijdse testresultaten
Q2 | 2.5 | 08–14 dec 2025 | - Testfase eindconcept | Testrapport (initieel)
Q2 | 2.6 | 15–21 dec 2025 | - Afronden eindconcept (mechanisch & softwarematig) | Eindconcept (versie 1)
22 dec 2025–04 jan 2026 | | | Kerstvakantie
Q2 | 2.7 | 05–11 jan 2026 | - Uitloop eindconcept (buffer) | –
Q2 | 2.8 | 12–18 jan 2026 | - Presentatie voorbereiden - afronden bouwen en coderen eindconcept | Eindpresentatie (voorbereid)
Q2 | 2.9 | 19–25 jan 2026 | - Eindpresentatie en demonstratie proof of concept | Eindpresentatie; demonstratie proof of concept
Q2 | 2.10 | 26 jan–01 feb 2026 | | –
