549116/ProjectGearDeburr/(commit log)

2025-11-12 schetsen
    ik heb een aantal van mijn gedigitaliseerde schetsen erin gezet
2025-11-12 overige documentatie overgezet
    [morfologisch overzicht in-uitvoer.xlsx]
2025-11-12 naam notities veranderd
    meer eenheid gebracht in de naamgeving van voortgangsgesprek notitiebestanden
2025-11-12 solidworks bestanden overgezet
    [3842523561_GUSSET 45_45_h140_251027132909264_HD.SLDPRT, 3842529383_GUSSET 40_40_h140_251030114547458_HD.SLDPRT, 3842993724_STRUT PROFILE 40x40L_h140_251030114502688.SLDPRT, 3842993724_STRUT PROFILE 40x40L_h140_251030114503172.SLDPRT, 3842993724_STRUT PROFILE 40x40L_h140_251030114503802.SLDPRT, 3842993724_STRUT PROFILE 40x40L_h140_251030114504413.SLDPRT, 3842993724_STRUT PROFILE 40x40L_h140_251030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]
2025-11-12 losse bestanden opgeruimd
    en een dubbele verwijderd
2025-11-13 vroege versie van frame erin gezet
    .txt met maten overgenomen uit telefoon, bosch rexroth assembly bestand gemaakt
    [3842523561_GUSSET 45_45_h140_251027132909264_HD.SLDPRT, 3842529383_GUSSET 40_40_h140_251030114547458_HD.SLDPRT, 3842993724_STRUT PROFILE 40x40L_h140_251030114502688.SLDPRT, 3842993724_STRUT PROFILE 40x40L_h140_251030114503172.SLDPRT, 3842993724_STRUT PROFILE 40x40L_h140_251030114503802.SLDPRT, 3842993724_STRUT PROFILE 40x40L_h140_251030114504413.SLDPRT, 3842993724_STRUT PROFILE 40x40L_h140_251030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]
2025-11-13 net gemaakte frame in git
    het net gemaakte frame dat per ongeluk weer in de teams gemaakt is in git zetten
    [3842523528_GUSSET 30_30_h140_251113141639806_HD.SLDPRT, 3842523561_GUSSET 45_45_h140_251027132909264_HD.SLDPRT, 3842529383_GUSSET 40_40_h140_251030114547458_HD.SLDPRT, 3842548775_CAP_h140_251113141007103_HD.SLDPRT, 3842993703_STRUT PROFILE 30x30_h140_251113135629012.SLDPRT, 3842993703_STRUT PROFILE 30x30_h140_251113135629505.SLDPRT, 3842993703_STRUT PROFILE 30x30_h140_251113135630001.SLDPRT, 3842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]
2025-11-14 frame vervangen met de goeie versie
2025-11-14 kopie-assembly verwijderd
    [totaalassembly.SLDASM]
2025-11-14 foto's geupload bestaande opstelling
    de opstelling van de vorige lichting hebben we (schaars) gedocumenteerd tijdens het inspecteren.
2025-11-14 berekening vermogen staalborstel
    [berekeningen borstelmotorvermogen.xlsx]
2025-11-14 berekening borstelvermogen verbeterd en diagram toegevoegd
    [berekeningen borstelmotorvermogen.xlsx]
2025-11-14 Create horizontale kracht.xlsx
    [horizontale kracht.xlsx]
2025-11-14 overzichtelijkere naam
    [borstelmotorvermogen.xlsx]
2025-11-18 berekeningen geleiders toegevoegd
    [geleiders.xlsx]
2025-11-18 bestellijst van de mail naar github gezet
    [bestellijst automation.xlsx]
2025-11-18 Update bestellijst automation.xlsx
    [bestellijst automation.xlsx]
2025-11-18 geleiderberekening uitgebreid
    er zit nu een check in die zegt of de rail sterk genoeg is ipv alleen de kracht uit te rekenen
    [geleiders.xlsx]
2025-11-18 berekeningen bijgewerkt vanuit teams
    versies klopten niet, nu wel
    [berekeningen borstelmotorvermogen.xlsx, geleiders.xlsx, horizontale kracht.xlsx]
2025-12-11 motor manual
2026-01-20 herstructurering mappen
    [1908261 DSNU-16-30-P---(A----0-ZR).sldprt, 1908261 DSNU-16-30-P---(A---00--0-KS).sldprt, 1908261 DSNU-16-30-P-A---(0).sldasm, 19186_DSNU_10_50_P_A____0_.sldasm, 19186_DSNU_10_50_P____A___00__0_KS_.sldprt, 19186_DSNU_10_50_P____A____0_ZR_.sldprt, 19200 DSNU-16-40-P---(A----0-ZR).sldprt, 19200 DSNU-16-40-P---(A---00--0-KS).sldprt]
2026-01-20 herstructurering documentatie
    [bestellijst automation.xlsx, kesselring deburring machine.xlsx, morfologisch overzicht in-uitvoer.xlsx, morfologisch overzicht ontbramen.xlsx]
2026-01-21 pack and go toegevoegd voor makkelijker nakijken
    [19201_DSNU_16_50_P_A____0_.sldasm, 19201_DSNU_16_50_P____A___00__0_KS_.sldprt, 19201_DSNU_16_50_P____A____0_ZR_.sldprt, 3779382_VUVG_LK_IP40.sldprt, 3842523528_GUSSET 30_30_h140_251113141639806_HD.SLDPRT, 3842548775_CAP_h140_251113141007103_HD.SLDPRT, 3842993703_STRUT PROFILE 30x30_h140_251113140934421.SLDPRT, 3842993703_STRUT PROFILE 30x30_h140_251113140934812.SLDPRT]
2026-01-21 pack and go bijgewerkt, filmpje toegevoegd
    [19201_DSNU_16_50_P_A____0_.sldasm, 19201_DSNU_16_50_P____A___00__0_KS_.sldprt, 19201_DSNU_16_50_P____A____0_ZR_.sldprt, 3779382_VUVG_LK_IP40.sldprt, 3842523528_GUSSET 30_30_h140_251113141639806_HD.SLDPRT, 3842548775_CAP_h140_251113141007103_HD.SLDPRT, 3842993703_STRUT PROFILE 30x30_h140_251113140934421.SLDPRT, 3842993703_STRUT PROFILE 30x30_h140_251113140934812.SLDPRT]
2026-01-21 verduidelijking conceptkeuze
    [morfologisch overzicht ontbramen.xlsx]
2026-01-21 nu wel de geupdate versie
    [morfologisch overzicht ontbramen.xlsx]
